icandy7272/ESP32-GPS-Lap-Timer/docs/PRD.md

# Kart GPS Lap Timer — 产品需求文档 (PRD)

**版本**: v0.5
**更新日期**: 2026-04-03
**审阅**: Codex Reviews (v0.2 → v0.5)

## 变更记录

| 版本 | 日期 | 变更内容 |
|---|---|---|
| v0.1 | 2026-04-02 | 初始需求 |
| v0.2 | 2026-04-02 | 新增 Position-Based Delta、无效圈过滤、自动开始/停止、赛后回顾、参考项目 |
| v0.3 | 2026-04-02 | Codex 审阅后修订：放宽 Delta 精度、改进过线检测算法、增加断电保护、精简驾驶 UI、限制扇区数、收窄 v1 范围、移除不安全的校准圈标记 |
| v0.4 | 2026-04-03 | 新增 PPS 校时，修正 Delta 精度目标（±50ms），过线计时精度目标（±20ms） |
| v0.5 | 2026-04-16 | 移除 PPS 相关内容：BK-880 不提供 PPS 输出，也无飞线可用的测试焊盘；时间基准改为 UART 到达时间，Delta 精度放宽到 ±100ms，过线计时 ±60ms |
| v0.5 | 2026-04-03 | Codex 二审：过线精度需求改为 ±30ms（±20ms 为目标值），去抖与精确计时解耦，SD 写入异步化 |

## 1. 项目概述

为卡丁车赛道设计的便携式 GPS 圈速计时器，安装在方向盘上，实时显示与最佳圈的时间差值（Delta），帮助车手在驾驶过程中精确定位每个弯角的快慢，并记录完整轨迹数据供赛后分析。

## 2. 目标用户

- 租赁卡丁车爱好者
- 会去不同赛道
- 需要在驾驶中实时获取圈速反馈
- 需要赛后导出数据用专业软件分析

## 3. 版本规划

### v1.0（MVP）

核心目标：**可靠的圈速计时 + 一个大 Delta 驾驶屏 + SD 卡 VBO 导出**

包含：
- 25Hz GPS 数据记录
- 可靠的过线检测和圈速计时
- Position-Based 实时 Delta 显示（大字体单屏）
- 扇区计时（最多 4 个扇区）
- SD 卡自动记录 VBO 文件
- WiFi 热点 Web 界面（赛道选择、VBO 下载、基础设置）
- 赛道自动识别
- 手动输入经纬度创建赛道
- 无效圈自动过滤
- 断电保护

### v1.1

- 赛后回顾界面（设备端查看圈速列表、理论最佳圈）
- Session 自动开始/停止
- 最佳圈模式切换（本次/历史）
- 历史最佳圈跨 Session 保留

### v2.0

- 地图点选创建赛道
- 赛后轨迹标记扇区
- OTA 固件更新
- 多车手 Profile
- 加速度计（IMU）G 值采集
- 弯心最低速度、滚动圈速等高级功能

## 4. 硬件配置

| 组件 | 型号 | 规格 |
|---|---|---|
| 主控 | 鹿小班 ESP32-S3-N16R8 | 双核 240MHz, 16MB Flash, 8MB PSRAM, WiFi+BLE |
| GPS | 北天 BK-880 | u-blox M9, 25Hz（单星座）/ 10Hz（多星座）, 有源天线, 28x28mm |
| 屏幕 | 中景园 ZJY320S0800TG02 | 3.2" IPS TFT, 320x240, ILI9341, SPI 4线, 3500nit |
| 存储 | MicroSD 卡模块（SPI） + 闪迪 16GB TF 卡 | FAT32 格式 |
| 电源 | 辰克 18650 电池组 | 5V 3A 输出, 4000mAh, Type-C 充电, 支持边充边用 |
| 按键 | 12mm 金属防水按键 x2 | 1 个自锁（总开关）, 1 个自复位（录制键） |
| 安装 | 3D 打印外壳 + 方向盘夹具 | 所有组件装在一个盒子中 |

### 硬件连接

```
ESP32-S3
├── SPI 总线（HSPI）
│   ├── TFT 屏幕 (CS_TFT)
│   └── SD 卡模块 (CS_SD)  ← 与 TFT 共用 MOSI/MISO/CLK，独立 CS
├── UART1
│   └── BK-880 GPS (TX/RX)  ← 115200 baud, UART 环形缓冲 ≥ 1KB
│                              （BK-880 不提供 PPS 输出；计时基准取 UART 到达时间）
├── GPIO
│   ├── 自复位录制键（GPIO4）
│   └── TFT 背光控制 (PWM)
├── 5V/VIN
│   └── 由 5V_SW 主电源母线供电
└── USB
    └── 固件烧录（烧录时外部 5V 断开）
```

### 设备物理结构（一体化盒装，安装在方向盘上）

```
侧面截面：

         天空 ↑ GPS 信号
    ╔══════════════╗  ← 塑料背壳（GPS 信号穿透）
    ║  GPS 天线 ↑  ║  ← BK-880 天线面朝天，贴背壳内侧
    ║──────────────║
    ║  ESP32-S3    ║
    ║  SD 卡模块   ║
    ║──────────────║
    ║  18650 电池  ║  ← 最重部件在底部，降低重心
    ╠══════════════╣
    ║  TFT 屏幕    ║  ← 朝向驾驶员
    ╚══════════════╝
         ↓ 方向盘
```

### 重量与振动注意事项

- 总重量估算：~250g（含电池）。AiM MyChron5 为 390g，Alfano 7 为 435g，本设备更轻
- 外壳建议用 PETG（比 PLA 更耐热耐冲击）
- 所有内部组件用泡棉或硅胶垫固定，防止振动松脱
- Type-C 充电口外露，供充电和固件更新

## 5. 功能需求

### 5.1 核心功能：Position-Based 实时 Delta 计时

**优先级：P0（v1.0）**

- **基于参考圈多段线进度的 Delta 计算**（Polyline Progress Delta）：
  1. 将最佳圈的 GPS 轨迹存储为有序坐标点序列（参考多段线）
  2. 每次 GPS 更新时，将当前坐标投影到参考多段线上，计算沿线进度（0.0 ~ 1.0）
  3. 查找参考圈在相同进度处的时间戳，计算差值
  4. **航向过滤**：当前航向与参考多段线该段的航向差 > 90° 时，不更新 Delta（防止平行赛道段误匹配）
  5. **最大横向距离阈值**：当前坐标到参考多段线的垂直距离 > 30m 时，Delta 显示冻结并标记"OFF TRACK"
- **时间基准（仅 UART）**：BK-880 **不对外输出 PPS 信号**（数据手册 §2.1.3：「1PPS 信号接口：无」），也没有可飞线引出的 PPS 测试焊盘。GPS fix 的时间戳取 UART 到达时间（`esp_timer_get_time()`），抖动约 10-50ms
- Delta 精度目标：**±100ms**（25Hz GPS + 样条插值 + UART 抖动）
- 过线计时精度：**±60ms**（UART 时间戳 + Catmull-Rom 样条插值）
  - 注：25Hz 采样间隔 40ms，样条插值可在采样点之间估算穿越时刻，但 GPS 位置噪声（CEP ~1.5m）和 UART 抖动限制了绝对下限
- Delta 屏幕显示分辨率：**0.01s**（百分之一秒，与 MyChron/Alfano 一致）
- 颜色编码：绿色 = 快于参考圈，红色 = 慢于参考圈
- **首圈无参考圈时**：Delta 显示 "--"，仅记录数据，首个有效圈完成后自动作为参考

### 5.2 过线检测（起终线和扇区线）

**优先级：P0（v1.0）**

每条检测线定义为：两点经纬度 + 合法穿越方向

检测逻辑：
1. **有符号线段交叉检测**：判断连续两个 GPS 点是否穿过检测线
2. **航向窗口**：当前航向必须在检测线法线方向 ±60° 以内（防止反方向穿越误触发）
3. **单次触发（Arming）**：每条检测线穿越一次后进入"已触发"状态，必须远离检测线一定距离（>50m）后重新激活
4. **最小时间间隔**：
   - 最小圈时间：15 秒（防止 GPS 抖动在终点线附近连续触发）
   - 最小扇区时间：5 秒
5. **样条插值精确时间戳**：GPS 采样间隔 40ms（25Hz），在前后两个 GPS 点之间用 Catmull-Rom 样条插值估算穿越时刻；时间基准为 UART 到达时间（BK-880 不提供 PPS）
6. **去抖（与精确计时解耦）**：
   - **精确时间戳路径**：检测到线段交叉后，立即用样条插值回溯计算精确穿越时刻（不等待确认）
   - **去抖验证路径**：连续 2 个 GPS 采样确认穿越方向一致后，才正式确认该穿越事件有效
   - 如果去抖验证失败（GPS 抖动导致的假穿越），丢弃已计算的时间戳
   - 两条路径独立运行：去抖不增加计时延迟，仅决定穿越事件是否被采纳

### 5.3 扇区计时

**优先级：P0（v1.0）**

- 每条赛道最多 **4 个扇区**（即最多 3 条扇区分割线 + 1 条起终线）
- 扇区分割线与起终线使用相同的检测逻辑
- 实时显示已完成扇区的 Delta
- GPS 抖动在短扇区上影响大，故限制最少 2 个扇区

### 5.4 最佳圈定义

**优先级：P0（v1.0 仅支持 Session Best，v1.1 扩展）**

- **v1.0**：本次 Session 最佳圈（每次开机重新计算）
- **v1.1**：增加历史最佳圈（跨 Session 保留，存储在 SD 卡），可通过 Web 界面切换
- 参考圈需存储完整 GPS 轨迹数据（约 50-100KB/圈，25Hz 下 40 秒一圈约 1000 个坐标点）

### 5.5 无效圈自动过滤

**优先级：P0（v1.0）**

圈状态定义：

| 状态 | 说明 | 计入统计？ |
|---|---|---|
| `timed` | 正常计时圈 | ✅ |
| `out` | 出发圈（首次穿越起终线之前） | ❌ |
| `slow` | 圈速 > 当前最佳圈 × 150% | ❌ |
| `short` | 圈时间 < 最小圈时间（15秒） | ❌ |
| `no_ref` | 无参考圈的首圈 | ✅（作为首个参考） |

失效规则：
- 首次穿越起终线前的所有数据为 `out` 状态
- 没有最佳圈时，第一个完整圈自动成为参考，状态为 `no_ref`
- `slow` 和 `short` 圈不更新最佳圈，不影响 Delta 参考基准
- v1.1 增加：Web 界面手动标记/取消

### 5.6 赛道管理

**优先级：P0（v1.0）**

- 预存赛道库，保存在 SD 卡中
- 每条赛道包含：
  - 赛道名称（ASCII only，v1.0 不支持中文文件名）
  - 赛道 ID
  - 起终线坐标（两点经纬度 + 合法穿越方向向量）
  - 扇区分割线坐标（每条也是两点经纬度 + 方向向量，最多 3 条）
  - 赛道中心坐标（用于自动识别）
  - 赛道近似长度（用于辅助识别）

### 5.7 赛道自动识别

**优先级：P0（核心自动识别为 v1.0，多候选交互选择延期到 v1.1）**

识别逻辑：
1. GPS 定位成功后，搜索赛道库中中心坐标距当前位置 < 5km 的赛道
2. 如果匹配到 1 条，直接使用，屏幕显示"已识别：XX"
3. 如果匹配到 0 条，屏幕提示"未知赛道，请用手机配置"
4. 识别结果可通过 Web 界面修改

**v1.0 当前范围：**

- 若 5km 内存在多条候选赛道，设备自动选择最近的一条
- 用户仍可通过手机 Web 界面手动切换赛道

**延期到 v1.1：**

- 如果匹配到多条（同一场馆多个布局），在 Web 界面上手动选择

### 5.8 赛道创建

**优先级：P0（v1.0 仅手动输入，v2.0 扩展）**

**v1.0**：在手机 Web 界面中离线创建赛道。用户先命名赛道，然后在现场依次标记起终线和可选扇区线，界面显示当前 GPS 坐标、鲜度和离线几何预览，不依赖互联网地图。

当前 v1.0 交互约束：

- 赛道创建完全离线，ESP32 热点模式下不加载在线地图瓦片
- 可见坐标默认约每 `2000ms` 刷新一次；进入赛道创建后提升到约 `1000ms`
- GPS 坐标显示鲜度标签：
  - `Live`
  - `1s ago`
  - `2s ago`
  - `Stale - refresh before trusting`
- 按下 `Mark P1/P2` 或扇区打点时，不再使用单次样本，改为固定策略采样：
  - 采样窗口 `2400ms`
  - 采样周期 `400ms`
  - 至少 `3` 个有效样本，否则失败并提示重试
  - 聚合方法为局部米制坐标系中的分量中位数
- 每次采样后显示点位质量，文案使用动作导向提示：
  - `Noisy - try again`
  - `Acceptable - short lines may drift`
  - `Good - ready to save`
- 短起终线会触发更严格门槛：若线长小于 `max(5m, 4 × max(point_spread))`，则要求更高置信度
- 复测（repeatability check）逻辑已预留，但 **v1 默认关闭**，当前不会强制要求用户复测
- Review 面板使用离线 SVG，显示：
  - 真比例几何
  - North / 北向参考
  - 米制比例尺
  - 起终线长度
  - 穿越方向
  - 点位不确定性圈
- v1 不保存未提交的赛道创建草稿；刷新或关闭页面会丢失当前创建过程，所以界面会明确提示不要刷新
- 创建失败时，Web 端应显示具体的保存错误，而不是笼统的 `save failed`

**v1.1**：赛后从已保存的 GPS 轨迹中标记起终线和扇区（在 Web 界面上拖拽轨迹上的点）

**v2.0**：在手机 Web 界面的卫星地图上点选（需解决 ESP32 热点下无互联网的问题，可能需要 Station 模式或预缓存地图瓦片）

### 5.9 数据记录

**优先级：P0（v1.0）**

- GPS 锁定 25Hz 刷新率（v1.0 不提供可选，确保 Delta 精度）
- 自动保存到 SD 卡，无需手动操作
- 文件格式：VBO（Racelogic VBOX 格式）
- 文件命名：`YYYYMMDD_TrackName_HHMMSS_NNN.vbo`（ASCII only）
  - 示例：`20260402_ShanghaiKartCenter_143022_001.vbo`
- 兼容 Circuit Tools、VBOX Tools 等分析软件

### 5.10 断电保护

**优先级：P0（v1.0）**

卡丁车振动大，Type-C 接触不良可能导致瞬断。必须防止数据丢失：

1. **写入策略**：VBO 数据写入临时文件 `_recording.vbo.tmp`，每 30 秒执行一次 `fsync` 刷盘
2. **Session 完成时**：关闭文件，原子重命名为最终文件名
3. **开机恢复**：启动时扫描 SD 卡根目录是否存在 `.tmp` 文件，如果有则：
   - 视为上次异常断电的未完成 Session
   - 重命名为 `YYYYMMDD_UNKNOWN_HHMMSS_recovered.vbo`（从文件内容提取时间戳）
   - 屏幕提示"已恢复上次未完成的 Session"
4. **Session 元数据 JSON**：仅在 Session 正常结束时写入，断电丢失 JSON 可接受（VBO 数据不丢）

### 5.11 VBO 文件格式

**文件编码**：ASCII only
**行结尾**：Windows CR+LF（`\r\n`），包括最后一行
**时间**：UTC

GPS 坐标格式：**角分制**
- 纬度：`十进制度 × 60`，`+` = 北纬，`-` = 南纬
- 经度：`十进制度 × -60`，`+` = 西经，`-` = 东经（注意：东经为负）
- 格式字符串：`%+012.5f`

文件结构：

```
File created on DD/MM/YYYY at HH:MM:SS\r\n
\r\n
[header]\r\n
satellites\r\n
time\r\n
latitude\r\n
longitude\r\n
velocity kmh\r\n
heading\r\n
height\r\n
\r\n
[comments]\r\n
Generated by KartGPS v1.0\r\n
Log Rate (Hz) : 25.00\r\n
\r\n
[session data]\r\n
name TrackName\r\n
\r\n
[laptiming]\r\n
Start  +MMMMM.MMMMM +MMMMM.MMMMM +MMMMM.MMMMM +MMMMM.MMMMM Start / Finish\r\n
Split  +MMMMM.MMMMM +MMMMM.MMMMM +MMMMM.MMMMM +MMMMM.MMMMM Split 1\r\n
\r\n
[column names]\r\n
sats time lat long velocity heading height\r\n
\r\n
[data]\r\n
008 143000.000 +01874.12345 -07258.67890 045.200 128.50 +00032.10\r\n
...
```

数据列格式：

| 列 | 格式 | 示例 | 说明 |
|----|---|---|---|
| sats | `%03d` | `008` | 3 位零填充 |
| time | `HHMMSS.SSS` | `143000.000` | UTC，无冒号，毫秒分辨率 |
| lat | `%+012.5f` | `+01874.12345` | 角分，+ 北 |
| long | `%+012.5f` | `-07258.67890` | 角分，- 东 |
| velocity | `%07.3f` | `045.200` | km/h |
| heading | `%06.2f` | `128.50` | 度 |
| height | `%+09.2f` | `+00032.10` | 米，WGS84 |

**验收标准**：生成的 VBO 文件必须能在 Circuit Tools 中正确导入并显示圈速和轨迹。项目需包含黄金测试文件（golden test files）用于回归验证。

### 5.12 手机交互（WiFi + Web 界面）

**优先级：P0（v1.0 基础版）**

- ESP32 自建 WiFi 热点
- SSID：`KartGPS-XXXX`（XXXX 为设备 MAC 后四位）
- 密码：可配置，默认 `kartgps123`
- 访问地址：`http://192.168.4.1`
- iOS / Android 浏览器通用

**重要约束**：记录模式下 WiFi 功能受限（降低优先级/限制并发请求），避免影响 GPS 数据处理和 SD 卡写入的实时性。WiFi 主要在停车/赛后使用。

v1.0 Web 页面：

```
首页
├── Status（默认）
│   ├── 当前状态（GPS 信号/卫星数、录制状态、当前圈、最佳圈、当前赛道）
│   ├── 录制控制
│   └── Advanced
│       ├── WiFi 密码修改
│       ├── 屏幕亮度
│       └── 固件/重启相关说明
├── Sessions
│   ├── 历史 Session 列表
│   └── VBO 文件下载
└── Tracks
    ├── 当前赛道摘要 / 附近赛道选择
    ├── 赛道列表（选择 / 删除）
    └── 新建赛道（手动输入经纬度 / 标记起终线与扇区）
```

### 5.13 VBO 文件传输

**优先级：P1（v1.0）**

- **方式 A**：拔 SD 卡插电脑读取
- **方式 B**：WiFi 下载（停车状态下，通过 Web 界面浏览和下载 VBO 文件）

## 6. 屏幕 UI 设计

### 6.1 驾驶界面（默认，唯一的赛道中屏幕）

**设计原则**：驾驶中只需余光瞥一眼。一个巨大的 Delta 数字 + 颜色 = 全部信息。

```
┌─────────────────────────────────┐
│                                 │
│                                 │
│         -0.23s                  │  ← 巨大字体，绿色背景（快）或红色背景（慢）
│                                 │
│                                 │
├─────────────────────────────────┤
│  Lap 7         Best: 42.956    │  ← 小字，弱化
└─────────────────────────────────┘
```

状态变体：
- **正常**：绿色/红色背景 + 白色大 Delta 数字
- **无参考圈（首圈）**：黑色背景 + 白色 "--"
- **OFF TRACK（偏离赛道 >30m）**：黄色背景 + "OFF TRACK"
- **GPS 信号丢失**：灰色背景 + "NO GPS"

### 6.2 停车/赛后界面（当前为预留界面）

在停车状态下，这个界面用于显示更多信息。当前硬件没有独立页面按键，
因此该界面先作为后续扩展预留：

```
┌─────────────────────────────────┐
│  SESSION: 14 laps (12 valid)    │
├─────┬────────┬──────────────────┤
│ Lap │  Time  │  vs Best         │
├─────┼────────┼──────────────────┤
│  3  │ 41.956 │  BEST ★          │
│  5  │ 42.088 │  +0.132          │
│  4  │ 42.102 │  +0.146          │
│  2  │ 42.301 │  +0.345          │
│ ... │        │                  │
├─────────────────────────────────┤
│  Best: 41.956                   │
└─────────────────────────────────┘
```

- 当前硬件没有独立页面按键；该界面先保留为后续扩展入口
- 无效圈以灰色显示
- v1.1 增加理论最佳圈显示

### 6.3 状态界面（当前为预留界面）

```
┌─────────────────────────────────┐
│  GPS: 12 sats  Fix: 3D         │
│  Track: ShanghaiKartCenter      │
│  Recording: ● REC               │
│  Battery: Charging / Full       │
│  SD: 14.2 GB free               │
│  WiFi: KartGPS-A3F2             │
│  FW: v1.0.0                     │
└─────────────────────────────────┘
```

注意：电池百分比需要电量计 IC（v1.0 没有），v1.0 仅显示充电中/已满/使用中。

### 6.4 开机流程屏幕

```
[开机画面] → [GPS 搜星中: X sats] → [已识别: XX赛道] → [Ready]
```

### 6.5 按键功能

| 按键 | 类型 | 功能 |
|---|---|---|
| 总开关 | 自锁 | 系统电源开/关 |
| 录制键 | 自复位 | 短按：开始/停止录制 |

## 7. 系统工作流程

```
[开机]
  │
  ▼
[GPS 搜星] ← 屏幕显示卫星数量，等待 3D Fix
  │
  ▼ (3D Fix, 卫星 ≥ 6)
  │
[自动匹配赛道]
  │
  ├── 匹配 1 条 → 屏幕显示"已识别：XX"
  ├── 匹配多条 → 进入 Web 界面手动切换
  └── 匹配 0 条 → 屏幕提示"用手机配置"
  │
  ▼
[Ready - 等待起跑]
  │
  ▼ (首次穿越起终线 → 开始计时)
  │   (同时 SD 卡开始写入 VBO 临时文件)
  │
[计时中]
  │
  ├── 每 40ms (25Hz) → GPS 更新 → 写入 VBO → 计算 Delta
  ├── 穿越扇区线 → 记录扇区时间
  ├── 穿越起终线 → 完成一圈
  │   ├── 判断圈状态 (timed / slow / short)
  │   └── 如果是新最佳 → 更新参考圈
  ├── 每 30 秒 → fsync 刷盘
  │
  ▼ (用户关机)
  │
[正常结束]
  ├── 关闭 VBO 文件
  ├── 原子重命名 .tmp → 最终文件名
  ├── 写入 Session 元数据 JSON
  └── 断电
```

## 8. 任务调度与资源管理

ESP32-S3 双核任务分配：

| 核心 | 任务 | 优先级 | 说明 |
|---|---|---|---|
| Core 0 | GPS UART 接收 + NMEA 解析 | 最高 | UART 环形缓冲 ≥ 1KB，不允许被任何任务阻塞（BK-880 无 PPS，时间戳取 UART 到达时间） |
| Core 0 | 过线检测 + Delta 计算 | 高 | 每次 GPS 更新后立即执行，必须在下一个 GPS fix 到来前完成（<40ms） |
| Core 1 | SD 卡 VBO 写入（异步队列） | 中高 | GPS 数据写入环形队列，Core 1 异步消费写入 SD 卡，每 30s fsync |
| Core 1 | TFT 屏幕渲染 | 中 | 目标 10 FPS，仅刷新变化区域（局部刷新） |
| Core 1 | WiFi Web Server | 低 | 记录模式下限制并发，仅响应基本请求 |
| Core 1 | 按键输入处理 | 低 | 去抖 50ms |

关键约束：
- **GPS 计时路径零阻塞**：Core 0 只做 GPS 接收、解析、过线检测、Delta 计算，不做任何 I/O 阻塞操作
- **SD 写入异步化**：GPS 数据先写入内存环形队列（PSRAM，容量 ≥ 5 秒数据），Core 1 的 SD 写入任务从队列消费。即使 SD 卡写入偶尔延迟（FAT32 簇分配），也不影响 Core 0 的计时精度
- **SPI 总线互斥**：SD 卡写入和 TFT 屏幕渲染共用 SPI 总线，通过 mutex 互斥，SD 写入优先级高于屏幕渲染
- WiFi 在记录模式下为尽力服务（best-effort），不保证响应速度

## 9. 数据存储结构（SD 卡）

```
SD 卡根目录
├── tracks/
│   ├── track_001.json
│   └── ...
├── sessions/
│   ├── 20260402_ShanghaiKartCenter_143022_001.vbo
│   ├── 20260402_ShanghaiKartCenter_143022_001.json  ← 正常结束时写入
│   └── ...
├── best_laps/                    ← v1.1
│   └── track_001_best.json
├── config/
│   └── settings.json
└── _recording.vbo.tmp            ← 记录中的临时文件（正常结束后消失）
```

### 赛道配置文件示例（track_001.json）

```json
{
  "id": "track_001",
  "name": "ShanghaiKartCenter",
  "start_finish": {
    "lat1": 31.2345,
    "lon1": 121.4567,
    "lat2": 31.2346,
    "lon2": 121.4568,
    "heading_deg": 45
  },
  "sectors": [
    {
      "name": "S1",
      "lat1": 31.2340,
      "lon1": 121.4570,
      "lat2": 31.2341,
      "lon2": 121.4571,
      "heading_deg": 120
    }
  ],
  "center_lat": 31.2342,
  "center_lon": 121.4567,
  "approx_length_m": 850
}
```

### Session 元数据示例

```json
{
  "track_id": "track_001",
  "track_name": "ShanghaiKartCenter",
  "date": "2026-04-02",
  "start_time_utc": "06:30:22",
  "end_time_utc": "07:12:45",
  "gps_hz": 25,
  "total_laps": 14,
  "valid_laps": 12,
  "best_lap": {
    "lap_number": 3,
    "time_ms": 41956,
    "sectors_ms": [14201, 15032, 12723]
  },
  "laps": [
    {"lap": 1, "time_ms": 43521, "status": "slow", "sectors_ms": [14800, 15621, 13100]},
    {"lap": 2, "time_ms": 42301, "status": "timed", "sectors_ms": [14300, 15101, 12900]},
    {"lap": 3, "time_ms": 41956, "status": "timed", "sectors_ms": [14201, 15032, 12723]}
  ]
}
```

## 10. 技术约束

- GPS 坐标系：WGS84
- GPS 锁定 25Hz，多星座模式下若不支持则降至 10Hz
- VBO 坐标格式：角分制（十进制度 × 60），东经为负
- VBO 文件编码：ASCII only，CR+LF 行尾
- VBO 时间：UTC
- SPI 总线：屏幕和 SD 卡共用，通过互斥锁（mutex）保证不冲突
- PSRAM 8MB：用于屏幕帧缓冲和参考圈 GPS 轨迹数据
- 内部 SRAM：用于 GPS UART 缓冲、NMEA 解析、实时计算
- 参考圈存储：约 50-100KB/圈（25Hz × 40s × 每点约 20 字节）
- 电池续航：需实测，目标 ≥ 8 小时
- 工作温度：-20°C ~ 70°C

## 11. 验收测试计划

| 测试项 | 方法 | 通过标准 |
|---|---|---|
| VBO 导入 | 在 Circuit Tools 中导入生成的 VBO 文件 | 正确显示轨迹、圈速、扇区 |
| 过线检测精度 | 用已知赛道真实 GPS 数据回放 | 与 MyLaps 官方计时差值 < 30ms（需求），目标 < 20ms |
| Delta 稳定性 | 连续 10 圈相同走线 | Delta 在直道上不出现 >0.1s 的异常跳变 |
| GPS 计时路径延迟 | 在 25Hz 记录模式下测量 Core 0 处理时间 | GPS fix 到达 → 过线检测完成 < 10ms（不被 SD/WiFi 阻塞） |
| 断电恢复 | 记录中拔电，重启 | 恢复的 VBO 文件可正常导入 |
| 赛道识别 | 在赛道库中有 5 条赛道，到达其中一条 | 10 秒内正确识别 |
| SD 卡长时间写入 | 连续记录 2 小时 | 无数据丢失、无文件损坏 |

## 12. 许可证说明

- 参考项目中 DovesLapTimer 为 GPLv3，**仅参考其行为逻辑和算法思路，独立实现代码**，不直接复用其源码
- BonoGPS 为 MIT，可自由复用其 u-blox 配置和 WiFi 栈代码
- 本项目计划采用 MIT 许可证

## 13. 参考项目与资料

### 开源项目

| 项目 | 地址 | 说明 | 可复用价值 |
|---|---|---|---|
| **DovesLapTimer** | https://github.com/TheAngryRaven/DovesLapTimer | Arduino 圈速计时库，样条插值过线检测，Delta，扇区计时，62ms 精度对标 MyLaps | 算法思路参考（GPL v3，不直接复用代码） |
| **DovesDataLogger** | https://github.com/TheAngryRaven/DovesDataLogger | DovesLapTimer 的数据记录伴侣项目 | SD 卡数据记录架构参考 |
| **gotzl/gps-tracker** | https://github.com/gotzl/gps-tracker | ESP32 GPS 圈速计时器，红/绿 Delta 条，WiFi 数据下载 | ESP32 Delta 显示 UI 参考 |
| **BonoGPS** | https://github.com/renatobo/bonogps | ESP32 GPS 桥接器，u-blox 配置，BLE/WiFi，25Hz（104★, MIT） | GPS 初始化、UBX 配置、WiFi 栈（可直接复用） |
| **M5Stack_GPS_LapTimer** | https://github.com/toripoyo/M5Stack_GPS_LapTimer | M5Stack GPS 圈速计时器（MIT） | 简单圈速计时参考 |
| **RaceChronoDiyBleDevice** | https://github.com/timurrrr/RaceChronoDiyBleDevice | ESP32 BLE 设备对接 RaceChrono（123★） | BLE 协议参考 |
| **vbo-tools** | https://github.com/lbulej/vbo-tools | Python CSV→VBO 转换器 | VBO 格式规范和坐标转换 |
| **quentinsf/vboxutils** | https://github.com/quentinsf/vboxutils | Python VBO 读取器 | VBO 格式验证参考 |

### 商业产品参考

| 产品 | 说明 | 参考价值 |
|---|---|---|
| **AiM MyChron5/5S** | 专业卡丁车数据仪，137x88mm，多显示模式，WiFi | 显示 UI、功能优先级 |
| **Alfano 7** | 专业卡丁车计时器，3000mAh/40h，5000+ 赛道库 | 赛道管理、理论最佳圈 |
| **RaceBox Mini/Mini S** | 便携 GPS 计时器，BLE 连手机，2000+ 赛道库 | 赛道自动识别、App 设计 |
| **FoxLAP** | ESP32 DIY GPS 计时器（闭源），1700+ 赛道，Position-Based Delta | 功能设计参考（https://foxlap.com） |

### 技术文档

| 文档 | 说明 |
|---|---|
| Racelogic VBO 格式规范 | https://en.racelogic.support/Knowledge_Base/.VBO_Files |
| VBO 经纬度计算说明 | https://en.racelogic.support/VBOX_Automotive/Knowledge_Base/VBOX_Latitude_and_Longitude_Calculations |
| 中景园 ZJY320S0800TG02 规格书 | 项目本地文件 |
| ILI9341 驱动芯片手册 | 项目本地文件 |
| BK-880 GPS 模块资料 | 北天官方 https://www.beitian.com |
