icandy7272/ESP32-GPS-Lap-Timer/pcb-guide.md

# ESP32-S3 GPS Lap Timer — PCB 打样教程

> 从零开始，手把手教你把面包板原型做成 PCB
>
> 前置文档：[docs/WIRING.md](docs/WIRING.md)（完整接线表和电源架构）

---

## 目录

1. [需要购买的元件](#1-需要购买的元件)
2. [电源与去耦方案](#2-电源与去耦方案)
3. [立创 EDA 零基础教程](#3-立创-eda-零基础教程)
4. [PCB 布局指南](#4-pcb-布局指南)
5. [嘉立创下单](#5-嘉立创下单)
6. [焊接与测试](#6-焊接与测试)
7. [洞洞板替代方案](#7-洞洞板替代方案)

---

## 1. 需要购买的元件

### 你已有的（不用买）

| 元件 | 数量 | 说明 |
|---|---|---|
| ESP32-S3-DevKitC-1 (N16R8) | 1 | 主控开发板 |
| ILI9341 TFT 3.2" 模块 | 1 | 排针接口，8 pin |
| GPS BK-880 模块 | 1 | **线束接口**（非直插排针），1×6 线束 |
| SD 卡 SPI 模块 | 1 | 排针接口，6 pin |
| 自锁按键 12×12mm | 1 | 电源总开关 |
| 自复位按键 12×12mm | 1 | Record 录制键 |
| 470µF 16V 电解电容 (8×12mm) | 4+ | 电源滤波 |
| 104 瓷片电容 0.1µF | 4+ | 高频去耦 |
| USB-C 5V 3A 电池 | 1 | 供电电源 |
| Type-C 母口分线板 | 1 | 从电池取电 |

### 需要购买

| 元件 | 规格 | 数量 | 参考价 | 用途 |
|---|---|---|---|---|
| 排母座 1×22pin | 2.54mm 间距，单排 | 2 | ¥1 | ESP32 DevKit 左右两侧插座 |
| 排母座 1×8pin | 2.54mm 间距，单排 | 1 | ¥0.5 | TFT 模块插座 |
| 排母座 1×6pin | 2.54mm 间距，单排 | 1 | ¥0.5 | SD 卡模块插座 |
| 排针 1×6pin | 2.54mm 间距，单排直插 | 1 | ¥0.3 | GPS 线束焊接点（线束焊到排针上，或直接焊到 PCB 焊盘） |
| 2pin 接线端子 5.08mm | 直插螺钉端子 | 1 | ¥0.5 | Type-C 分线板的 5V/GND 接入 |
| 220Ω 直插电阻 | 1/4W | 1 | ¥0.1 | LED 限流（如用 GPIO2 LED） |
| **PCB 打样** | 嘉立创 5 片 | 1 单 | **¥5-10** | 见第 5 节下单指南 |

> **排母座数量说明：** 以上按各模块引脚数列出最小需求。建议多买几条长排母（如 1×40pin），用手掰成需要的长度，更灵活也更便宜。

---

## 2. 电源与去耦方案

> 完整电源架构见 [docs/WIRING.md § 电源接线](docs/WIRING.md#电源接线)，这里只补充 PCB 上的电容布局。

### 电源通路

```
USB-C 电池 (5V 3A) → Type-C 母口分线板
  → [接线端子 `5V_BAT`] → [自锁按键] → `5V_IN` 总线
      │
      ├── C1: 470µF + C2: 104 ── GND     ← 总线入口滤波
      │
      ├──→ C3: 104 + C4: 470µF ── GPS VCC (5V)
      │
      ├──→ C5: 104 + C6: 470µF ── SD VCC (5V)
      │
      └──→ ESP32 5VIN
            └── 3.3V 引脚
                 └── C7: 104 + C8: 470µF ── TFT VCC (3.3V)
```

**共 4 对电容：4 个 470µF + 4 个 104。**

### 为什么用 470µF 替代文档推荐的 10-220µF？

`WIRING.md` 建议 GPS 旁 10µF、SD 旁 100-220µF、TFT 旁 10µF。你手头有大量 470µF，直接用完全没问题：

- 电解电容大了**不会有害**，只是占更多板面积
- 8×12mm 的 470µF 在载板上放得下
- 更大的容量对突发电流的缓冲更好

### 电容摆放原则

- **104 瓷片**紧贴模块的 VCC/GND 引脚（越近越好，滤高频噪声）
- **470µF 电解**可以稍远一些（1-2cm 内），滤低频纹波和突发电流
- 电解电容**注意正负极**：长脚为正（接 VCC），短脚/标记条为负（接 GND）

---

## 3. 立创 EDA 零基础教程

### 3.1 注册与进入

1. 打开 https://lceda.cn
2. 注册嘉立创账号（或用微信扫码登录）
3. 点击「立创 EDA 标准版」→「在线使用」
4. 进入编辑器后，左上角「文件」→「新建项目」
5. 项目名：`ESP32_GPS_LapTimer_PCB`

### 3.2 原理图绘制

原理图的目的是告诉软件"哪个引脚连哪个引脚"，**不需要画得跟实物一样**。

#### 步骤 1：放置元件符号

在右侧「元件库」搜索并放置：

| 搜索关键词 | 选择 | 数量 | 代表 |
|---|---|---|---|
| `排针 1×22` 或 `Header 1x22` | 2.54mm 单排直插 | 2 | ESP32 DevKit 左右两排 |
| `排针 1×8` 或 `Header 1x8` | 2.54mm 单排 | 1 | TFT 模块 |
| `排针 1×6` 或 `Header 1x6` | 2.54mm 单排 | 1 | SD 卡模块 |
| `排针 1×6` 或 `Header 1x6` | 2.54mm 单排 | 1 | GPS 线束焊接点 |
| `SW_Push` 或 `按键开关` | 直插按键 12×12 | 2 | 自锁开关 + Record |
| `接线端子 2P` | 5.08mm 2pin | 1 | 电源输入 |
| `电容 470uF` 或 `Cap_Polar` | 直插电解 8×12 | 4 | 滤波电容 |
| `电容 100nF` 或 `C` | 直插瓷片 | 4 | 去耦电容 |
| `电阻 220` 或 `R` | 直插 1/4W | 1 | LED 限流 |
| `LED` | 3mm 直插 | 1 | 状态 LED（可选） |

> **技巧：** 搜不到精确型号没关系。原理图符号只是逻辑连接，真正决定焊盘的是封装（Footprint）。先用通用符号，后面再指定封装。

#### 步骤 2：给元件标注引脚名

双击排母符号，把引脚名改成有意义的名字。参考 [docs/WIRING.md § 接线总览表](docs/WIRING.md#接线总览表)：

**ESP32 DevKit（左右各 1×22）：** 你不需要标全部 44 个引脚，只标用到的：

| 引脚编号 | 标注 | 说明 |
|---|---|---|
| 按 DevKit 实际排列 | 5VIN | 接 `5V_IN` |
| | GND | 接地 |
| | 3V3 | 输出给 TFT |
| | GPIO4 | Record 按钮 |
| | GPIO8 | TFT RST |
| | GPIO9 | TFT DC |
| | GPIO10 | TFT CS |
| | GPIO11 | SPI MOSI |
| | GPIO12 | SPI SCLK |
| | GPIO13 | SPI MISO |
| | GPIO17 | GPS RX |
| | GPIO18 | GPS TX |
| | GPIO42 | SD CS |
| | GPIO47 | TFT BLK |
| | GPIO2 | LED |

**TFT (1×8)：** GND, VCC, CLK, MOS, RES, DC, CS, BLK

**SD (1×6)：** GND, VCC, MISO, MOSI, SCK, CS

**GPS (1×6 焊盘/排针)：** SDA, GND, TX, RX, VCC, SCL — 模块板上的 2.54mm 通孔路径，焊 1×6 排针到模块，PCB/洞洞板上装对应排母座即可。BK-880 不提供 PPS，不需要预留任何 PPS 焊点。

#### 步骤 3：用网络标签连线

**不要直接拉线连来连去——会变成一团乱麻。** 用「网络标签」（Net Label）：

1. 在工具栏找到「网络标签」（或按快捷键 `N`）
2. 放一个标签叫 `MOSI`，贴在 ESP32 的 GPIO11 引脚上
3. 再放一个同名的 `MOSI` 标签，贴在 TFT 的 MOS 引脚上
4. 再放一个同名的 `MOSI` 标签，贴在 SD 的 MOSI 引脚上
5. **同名标签 = 物理连线**，软件会自动认为它们相连

按这个方法把所有连接做完：

| 网络标签 | 连接的引脚 |
|---|---|
| `5V_BAT` | 接线端子 pin1 → 自锁按键 pin1（按键前，电池原始 5V） |
| `5V_IN` | 自锁按键 pin2 → C1+ → C4+ → C6+ → ESP32 5VIN → GPS VCC → SD VCC（按键后，系统 5V 总线） |
| `3V3` | ESP32 3V3 → C8+ → TFT VCC |
| `GND` | 所有 GND 引脚、所有电容负极、接线端子 pin2 |
| `MOSI` | ESP32 GPIO11 → TFT MOS → SD MOSI |
| `SCLK` | ESP32 GPIO12 → TFT CLK → SD SCK |
| `MISO` | ESP32 GPIO13 → SD MISO |
| `TFT_CS` | ESP32 GPIO10 → TFT CS |
| `TFT_DC` | ESP32 GPIO9 → TFT DC |
| `TFT_RST` | ESP32 GPIO8 → TFT RES |
| `TFT_BL` | ESP32 GPIO47 → TFT BLK |
| `SD_CS` | ESP32 GPIO42 → SD CS |
| `GPS_RX` | ESP32 GPIO17 (U1RXD) ↔ GPS pin3 (TX) — 从 ESP32 视角命名：ESP32 的 RX 线 |
| `GPS_TX` | ESP32 GPIO18 (U1TXD) ↔ GPS pin4 (RX) — 从 ESP32 视角命名：ESP32 的 TX 线 |
| `BTN_REC` | ESP32 GPIO4 → Record 按钮 pin1 |
| `LED_OUT` | ESP32 GPIO2 → 220Ω 电阻 → LED 正极 |

> Record 按钮的另一端接 `GND`。LED 负极也接 `GND`。

#### 步骤 4：添加电源符号

1. 搜索元件库中的 `VCC` 和 `GND` 电源符号
2. 把 `VCC` 放在 `5V_IN` 网络上，`GND` 放在地线上
3. 这一步主要是让原理图更易读，不影响实际连接

#### 步骤 5：ERC 检查

1. 菜单「设计」→「电气规则检查（ERC）」
2. 点击「运行检查」
3. 常见警告：
   - "未连接的引脚" — 检查是不是忘了接线
   - "电源引脚未连接电源网络" — 加 VCC/GND 符号
4. 所有错误清零后，原理图完成

### 3.3 指定封装

每个元件需要指定 PCB 上的实际焊盘形状：

| 元件 | 封装搜索关键词 |
|---|---|
| ESP32 排母 1×22 ×2 | `PIN-HEADER_1X22_2.54` |
| TFT 排母 1×8 | `PIN-HEADER_1X8_2.54` |
| SD 排母 1×6 | `PIN-HEADER_1X6_2.54` |
| GPS 排母 1×6 | `PIN-HEADER_1X6_2.54` |
| 按键 12×12 | `SW_12x12` 或 `KEY-TH_4P-L12.0-W12.0` |
| 470µF 电解 8×12 | `CAP-D8.0×H12.0` 或搜 `电解 8x12` |
| 104 瓷片 | `C_DISC_D5.0` 或 `C0805`（看你的是直插还是贴片） |
| 220Ω 电阻 | `R_AXIAL_L6.3` 或类似直插封装 |
| LED 3mm | `LED_D3.0` |
| 接线端子 2P | `CONN-TH_2P-P5.08` |

双击每个元件 → 「封装」栏 → 搜索对应封装 → 选择 → 确认。

### 3.4 PCB 设计

#### 步骤 1：转换到 PCB

菜单「设计」→「原理图转 PCB」（或点顶部的 PCB 图标）。

所有元件会堆在一起出现在 PCB 编辑器中。接下来要做三件事：摆元件、画板框、布线。

#### 步骤 2：画板框

1. 切换到「板框层」（Board Outline）
2. 用矩形工具画板框
3. 推荐尺寸：**100mm × 80mm**（可以放下所有元件，后面调整）

> DevKit 本体约 70×26mm，TFT 模块约 50×34mm。预留足够空间。

#### 步骤 3：摆放元件

把元件从堆叠状态拖到板框内。摆放原则见下一节。

#### 步骤 4：布线

1. 点击「布线」工具（或快捷键 `W`）
2. 从一个焊盘开始，拉线到另一个焊盘
3. 软件会用飞线（细白线）提示哪些焊盘需要连接
4. 走完所有飞线 = 布线完成

走线宽度设置：
- 「设计规则」→ 添加规则：
  - `5V_IN` 网络：线宽 **1mm**
  - `3V3` 网络：线宽 **0.5mm**
  - `GND` 网络：线宽 **1mm**（或用铺铜代替）
  - 其余信号线：线宽 **0.25mm**

#### 步骤 5：铺铜（地平面）

1. 选择「铺铜」工具
2. 在**底层**（Bottom Layer）画一个覆盖整个板框的矩形
3. 网络选择 `GND`
4. 点击「重建铺铜」
5. 底层会被 GND 铜皮填满，所有 GND 焊盘自动通过过孔连接

> 这是 PCB 设计中最重要的一步——地铜平面能大幅减少电源噪声和信号串扰，是面包板无法实现的。

#### 步骤 6：DRC 检查

1. 菜单「设计」→「设计规则检查（DRC）」
2. 运行检查
3. 修复所有错误（间距不够、未连接、短路等）

---

## 4. PCB 布局指南

### 推荐布局（俯视图）

```
┌──────────────────────────────────────────────────────────┐
│                                                          │
│  [接线端子]  [自锁按键]     470µF(总线)                    │
│   5V/GND      ON/OFF        C1 + C2(104)                 │
│                                                          │
│  ┌────────────────────────────────────┐                   │
│  │                                    │    [GPS 焊盘]     │
│  │   ESP32-S3 DevKit (1×22 + 1×22)    │    C3+C4(470µF)  │
│  │                                    │  ← 线束从此引出   │
│  │     USB-C 口朝板边                  │                   │
│  │     （方便烧录时接线）               │                   │
│  │                                    │                   │
│  └────────────────────────────────────┘                   │
│                                                          │
│  [SD 排母]    [Record 按钮]     [TFT 排母 1×8]           │
│  C5+C6         GPIO4            C7+C8                    │
│  ← 靠近 ESP32                    ← 可伸出板边插屏幕       │
│    (SPI 走线短)                                           │
│                                                          │
│  [LED] ── [220Ω] ── GPIO2                                │
│                                                          │
└──────────────────────────────────────────────────────────┘
```

### 排母座丝印防呆（重要！）

模块排针的丝印顺序和 PCB 排母的 pin1 方向可能相反，**插反会导致 5V 灌入 GPIO，烧毁 ESP32 或模块。**

**必须在 PCB 丝印上印出每个排母座各引脚的信号名：**

```
SD 卡排母：
  CS  SCK  MOSI  MISO  VCC  GND
   ○    ○    ○     ○    ○    ○

TFT 排母：
  GND  VCC  SCL  SDA  RES  DC  CS  BLK
   ○    ○    ○    ○    ○   ○   ○    ○

GPS 焊盘：
  SDA  GND  TX  RX  VCC  SCL
   ○    ○   ○   ○    ○    ○
```

安装时，将模块丝印上的信号名与 PCB 丝印一一对齐即可，不依赖 pin 编号。

### 元件摆放原则

| 原则 | 原因 |
|---|---|
| **ESP32 居中** | 信号线向四周辐射，平均走线最短 |
| **SD 卡靠近 ESP32** | SPI 总线走线越短越好（10-25MHz 时钟） |
| **GPS 天线朝板边外侧** | 远离 SPI 时钟线和 ESP32 的射频干扰 |
| **TFT 在一侧** | 方便用排线延伸到外壳面板 |
| **自锁按键在板边** | 方便从外壳露出操作 |
| **接线端子在板边** | 方便外部电源线接入 |
| **电容紧贴模块 VCC/GND** | 去耦效果与距离成反比，越近越好 |

### 走线规则

| 网络 | 线宽 | 说明 |
|---|---|---|
| `5V_IN`, `GND` | ≥ 1.0mm | 电源主干，电流大 |
| `3V3` | ≥ 0.5mm | 3.3V 供 TFT，电流 ~30mA |
| SPI (`MOSI`, `SCLK`, `MISO`) | 0.25mm | 尽量短、平行、等长 |
| CS/DC/RST/BL | 0.25mm | 低速控制信号，不敏感 |
| UART (`GPS_TX`, `GPS_RX`) | 0.25mm | 低速 115200，可以走长线 |
| `BTN_REC` | 0.25mm | 低速 GPIO 输入 |

### SPI 走线注意事项

```
GOOD:  MOSI ═══════╗
       SCLK ═══════╬══→ TFT/SD （平行、短、紧挨）
       MISO ═══════╝
       GND  ═══════    （旁边跑一根地线）

BAD:   MOSI ═══════════════╗
       SCLK ═╗              ╠══→ TFT/SD （长度不一、绕路）
       MISO ═╩═════════════╝
```

- SPI 三根线（MOSI/SCLK/MISO）从 ESP32 出发，先到 SD 卡模块再到 TFT（或反之），走菊花链
- 或者从 ESP32 分叉，分别短线到两个模块
- 旁边伴一根 GND 走线或依赖底层地铜平面

---

## 5. 嘉立创下单

### 5.1 导出 Gerber 文件

立创 EDA 最方便的一点——**可以跳过 Gerber 导出，直接下单：**

1. PCB 编辑器内，点击顶部工具栏的「嘉立创下单」按钮
2. 自动检查设计 → 生成制造文件 → 跳转到嘉立创下单页面
3. 如果要手动导出：菜单「制造」→「Gerber 导出」

### 5.2 下单参数

| 参数 | 选择 | 说明 |
|---|---|---|
| 层数 | **2** | 双面板（顶层走信号，底层铺地铜） |
| 尺寸 | 自动识别 | 从 Gerber 读取 |
| 板厚 | **1.6mm** | 标准厚度，最便宜 |
| 阻焊颜色 | **绿色** | 最便宜，交期最快 |
| 铜厚 | **1 oz** | 标准，够用 |
| 表面处理 | **HASL（有铅喷锡）** | 最便宜，手工焊接最方便 |
| 数量 | **5 片** | 最小起订量 |
| 确认生产稿 | **否** | 省时间 |

### 5.3 费用与交期

| 项目 | 参考价格 |
|---|---|
| PCB 5 片 | ¥2-5 |
| 运费 | ¥5-12（看快递方式） |
| **合计** | **约 ¥10-15** |
| 交期 | 下单后 2-5 个工作日发货 |

> 嘉立创经常有新用户免费打样活动，注册后看看有没有优惠券。

---

## 6. 焊接与测试

### 6.1 焊接顺序

从低到高、从小到大焊接：

| 顺序 | 元件 | 注意事项 |
|---|---|---|
| 1 | 104 瓷片电容 ×4 | 无极性，随便插 |
| 2 | 220Ω 电阻 | 无极性 |
| 3 | 470µF 电解电容 ×4 | **有极性！** 长脚=正=VCC，短脚/白条=负=GND |
| 4 | 排母座（ESP32, TFT, GPS, SD） | 先焊一个引脚定位，确认垂直后再焊其余 |
| 5 | 按键 ×2 | 12×12mm 四脚，对角两脚相连 |
| 6 | 接线端子 | 开口朝板边（方便接线） |
| 7 | LED + 电阻 | LED 长脚=正极=接电阻侧 |

### 6.2 焊后检查（上电前必做！）

用万用表逐项检查：

| 检查项 | 操作 | 期望结果 |
|---|---|---|
| **5V/GND 无短路** | 欧姆挡量接线端子 5V 和 GND | 不导通（显示 OL） |
| **3V3/GND 无短路** | 量 TFT 排母的 VCC 和 GND | 不导通 |
| **自锁按键通断** | 蜂鸣挡量按键两端，按下/释放 | 按下响，释放不响 |
| **电源通路** | 自锁按键按下，量各模块 VCC 到接线端子 5V+ | 导通（蜂鸣） |
| **电容极性** | 目视检查 470µF 的正负极标记 | 正极接 VCC 侧 |

### 6.3 首次上电

1. **不插任何模块**，只接电源线到接线端子
2. 按下自锁按键
3. 用万用表量各排母座的 VCC-GND 电压：
   - GPS/SD 排母：应为 **~5V**
   - TFT 排母：此时无电压（ESP32 还没插，3.3V 没输出）
4. 确认无异味、无发热

### 6.4 插入模块测试

1. 断电（释放自锁按键）
2. 插入 ESP32 DevKit
3. 上电，量 TFT 排母 VCC-GND：应为 **~3.3V**
4. 逐个插入其他模块，每插一个观察是否正常

### 6.5 刷固件并修改参数

PCB 走线比面包板可靠得多，可以恢复全速参数：

**文件 1：`src/storage/storage_internal.h` 第 18 行**
```cpp
// 修改前（面包板保守值）：
static constexpr uint32_t SD_SPI_MHZ = 4;

// 修改后（PCB 全速值）：
static constexpr uint32_t SD_SPI_MHZ = 25;
```

**文件 2：`platformio.ini` 第 16 行**
```ini
; 修改前（面包板降频防 BROWNOUT）：
board_build.f_cpu = 160000000L

; 修改后（PCB 全速）：
board_build.f_cpu = 240000000L
```

### 6.6 验证步骤

1. 编译并上传固件
2. 查看串口输出，确认无 `BROWNOUT` 错误
3. 检查 SD 卡 `boot_log.txt`，确认启动正常
4. 测试录制功能（按 Record 按钮）
5. 测试 GPS 定位（户外等待 30-60 秒冷启动）
6. 如果 SD 卡在 25MHz 下不稳定，降回 10MHz 再试

### 6.7 烧录模式注意

> 参见 [docs/WIRING.md § 烧录与双供电注意事项](docs/WIRING.md#6-烧录与双供电注意事项)

1. 释放自锁按键（断外部 5V）
2. USB 线连电脑和 ESP32 DevKit
3. 烧录固件
4. 拔掉 USB
5. 按下自锁按键恢复电池供电

**不要同时接电池和电脑 USB** — 双路 5V 可能互相回灌。

---

## 7. 洞洞板替代方案

如果 PCB 打样太麻烦，可以用洞洞板焊接，原理图作为接线参考即可。

### 7.1 材料清单

| 材料 | 规格 | 用途 |
|---|---|---|
| 洞洞板 | **双面镀锡**，2.54mm 间距，~10×8cm | 焊接基板 |
| 排母座 | 1×6 ×2, 1×8 ×1, 1×22 ×2 | 模块插座（含 GPS） |
| 排针 | 1×6 | 焊到 GPS 模块底部焊盘 |
| 接线端子 | 2P 5.08mm | 电源输入 |
| 漆包线 | **0.3mm** | 信号跳线（SPI/UART/GPIO） |
| 镀锡铜线 | **0.5mm** 或更粗 | 电源线（5V/GND，承载 500mA） |
| 杜邦线（可选剥皮用） | 普通现成杜邦线 | 可替代漆包线/镀锡线 |
| 焊锡丝 | 0.6mm 含松香 | 焊接 |

### 模块连接方式总结

| 模块 | 连接方式 |
|---|---|
| ESP32 DevKit | 两条 1×22 排母座（插拔） |
| TFT 屏 | 1×8 排母座（插拔） |
| SD 卡模块 | 1×6 排母座（插拔） |
| GPS BK-880 | **先焊 1×6 排针到模块底部焊盘**，再用 1×6 排母座插拔 |
| 自锁按键（电源） | 按钮的线焊到洞洞板焊盘（按钮装外壳上） |
| 自复位按键（Record） | 按钮的线焊到洞洞板焊盘（按钮装外壳上） |
| 接线端子 | 直接焊到洞洞板 |
| 电容 | 直接焊到洞洞板 |

> **不要用 0.1mm 漆包线做电源线** — 太细，500mA 会发热，长期不可靠。
> **0.1-0.2mm 仅信号线短跳可用**，但容易折断。
> 推荐：信号 0.3mm 漆包线，电源 0.5mm+ 镀锡线。

### 7.2 双面镀锡洞洞板的优势

- 每个孔上下两面都有铜环，强度更好
- 相邻焊盘可以**用焊锡桥接**，省跳线
- 比单面板贵一点但好焊

### 7.3 布局原则

和 PCB 一样（参考第 4 节）：
- ESP32 居中，USB 朝板边
- SD 靠近 ESP32
- GPS 在板边，远离 SPI
- 电容紧贴模块 VCC

### 7.4 焊接顺序

1. **排母座**（先焊对角两针定位，确认垂直再焊其余）
2. **按钮接线焊盘**（直接用 1×2 排针孔位，不焊排针，留着穿线）
3. **接线端子**（开口朝板边）
4. **104 瓷片电容**（无极性）
5. **470µF 电解电容**（**注意极性**：长脚=正、短脚/白条=负）
6. **背面跳线**（按原理图的网络连接）

### 7.5 跳线技巧

**电源/GND 总线（推荐方案）：**
- 用 0.5mm 镀锡铜线沿一行/一列拉直，作为 5V 总线
- GND 另起一行
- 各模块的 VCC/GND 焊到对应总线上
- 这样比每个模块单独拉线干净得多

```
背面示意（俯视）：
  ESP32 GND ──┬─────────────── GND 总线 ────┬── GPS GND
              │                              │
              SD GND                         TFT GND

  ESP32 5V ──┬─────────────── 5V 总线 ────┬── GPS VCC
             │                             │
             SD VCC                        (TFT VCC 走 3V3)
```

**SPI 信号（MOSI/SCLK/MISO）：**
- 用 0.3mm 漆包线，三根捋直走在一起
- 旁边伴一根 GND 跳线（抗干扰）
- 长度尽量短

**漆包线焊接：**
- 漆包线表面有绝缘漆，焊前需要去漆
- 方法：电烙铁高温（350°C）+ 焊锡，烫几秒漆就化了
- 或者用刀刮、砂纸磨

### 7.6 防呆

模块插上去之前，**用记号笔在板上写信号名**：

```
SD 排母旁：  CS  SCK  MOSI  MISO  VCC  GND
TFT 排母旁： GND VCC SCL SDA RES DC CS BLK
GPS 焊盘旁：SDA GND TX RX VCC SCL
```

模块上的丝印对着洞洞板上的标注插，杜绝插反烧板。

### 7.7 上电前检查

万用表蜂鸣挡：
- 5V 总线 ↔ GND：**不应导通**（否则短路）
- 各模块 VCC ↔ 5V 总线（或 3.3V）：**应导通**
- 各模块 GND ↔ GND 总线：**应导通**
- 自锁按键按下：5V_BAT ↔ 5V_IN **应导通**

### 7.8 固件参数

洞洞板的信号完整性比 PCB 差一些，但比面包板好。建议：
- `SD_SPI_MHZ` 先试 **10**（不要直接上 25）
- `f_cpu` 可以上 **240MHz**

如果稳定，再把 SD 速度加到 25MHz。

---

## 附录：常见问题

### Q: 上电后没反应？
- 检查自锁按键是否按下锁住
- 量接线端子有没有 5V
- 检查 470µF 电容正负极是否反了

### Q: SD 卡读写报错？
- 先把 `SD_SPI_MHZ` 降回 4 或 10，排除速度问题
- 检查 MOSI/SCLK/MISO/CS 四根线的焊点

### Q: TFT 不亮？
- 量 TFT VCC-GND 是否有 3.3V
- 检查 GPIO47 (BLK) 连线
- RST (GPIO8) 虚焊会导致屏幕不初始化

### Q: GPS 无输出？
- TX/RX 是否交叉连接（GPS TX → ESP32 GPIO17）
- GPS 模块 VCC 是否有 5V
- 首次定位需要 30-60 秒，室内可能更久

### Q: 编译上传后 BROWNOUT？
- 把 `f_cpu` 改回 `160000000L` 试试
- 检查 470µF 电容是否在位
- 检查自锁按键接触是否良好（量按键两端电压降，应 < 250mV）

---

## 附录：补充意见（焊接前）

这些不是必须照做的硬性要求，但按现在这条 worktree 里的文档和代码状态来看，下面几条会明显降低首版洞洞板翻车概率。

### 1. BK-880 完全不提供 PPS，无需预留相关焊点

- 数据手册 §2.1.3 明确标注「1PPS 信号接口：无」
- 模块板上没有可用于飞线的 PPS 测试焊盘（`PPS` LED 只是内部秒脉冲的可视指示）
- GPIO16 代码里保留 `PIN_GPS_PPS` 定义以便兼容，但 **ISR 永不触发**
- 洞洞板上 GPIO16 不需要布线、不需要预留焊孔，按未用处理即可

### 2. 已确认的插座规格

- 当前实物规格已经确认：
- `ESP32-S3-DevKitC-1` 使用 **两排独立 `1×22`**
- `GPS BK-880` 使用 **`1×6` 线束/焊盘**
- 因此采购和切排母时，按上面两个规格执行即可
- `ESP32` 不要按标准双排 `2×22` 排母去理解，它更接近“两条分开的单排插座”
- 真正开焊前，仍建议先把 `ESP32`、`TFT`、`SD`、`GPS` 四个模块摆到桌上，逐个数针脚、量排距、确认丝印方向，再开始切插座

### 3. 洞洞板首版建议按“先稳再快”调试

- 虽然文档里给了洞洞板 `240MHz + SD_SPI_MHZ=10` 的建议，但第一次点亮时我还是更建议从当前固件保守值开始
- 也就是先用 `f_cpu = 160MHz`
- `SD_SPI_MHZ` 先维持 `4` 或最多升到 `10`
- 等你确认下面这些都稳定后，再逐步提速：
- 连续冷启动不 brownout
- TFT 每次都能正常复位点亮
- SD 卡反复挂载/写入不报错
- GPS 长时间供电不掉线
- 这样排障会简单很多，因为你能先把“焊接错误”和“时序/速度问题”分开

### 4. 机械强度在洞洞板版本里和电气同样重要

- `GPS` 线束、电源输入线、自锁按键引线，都是最容易被震动拉坏的地方
- 这些线不要只靠焊点承力，建议在线束进入板子的地方做一次应力释放
- 可选做法：热熔胶、UV 胶、小扎带穿孔固定、或者在线束上打结后再进外壳
- `USB` 口、`SD` 卡口、总开关位置，也尽量在外壳阶段就想好，避免后面因为“插不进去”返工焊线

### 5. 建议预留最少量测试点

- 哪怕是洞洞板，也建议至少留出几个万用表/示波器好碰到的位置
- 推荐预留：
- `5V_IN`
- `3V3`
- `GND`
- `GPIO17 / GPIO18`（GPS 串口）
- `GPIO42`（SD CS，排查 SPI 时很有用）
- 这些测试点不需要很正式，一排空焊孔或短排针都可以

### 6. 首次上电顺序建议再保守一点

- 第一次不是“全插满再上电”，而是按层级推进
- 先只上电源总线，确认 `5V_IN` 正常
- 再插 `ESP32`，确认板上 `3.3V` 正常
- 再插 `TFT`
- 再插 `SD`
- 最后插 `GPS`
- 每加一个模块，都量一次该模块 `VCC-GND` 电压，并观察电流、发热和串口日志
- 这样一旦出问题，你几乎能立刻定位是哪个模块或哪段线引入的

### 7. 这版文档已经够开工，但仍建议边焊边修正文档

- 现在这份 `pcb-guide.md` 已经足够支持你开始做洞洞板版本
- 但它还带着少量从 `PCB 打样` 视角遗留下来的描述，和少量规格不一致的地方
- 比如 `ESP32` 插座针数、`GPS` 线束针数、以及“PCB 推荐参数”和“洞洞板推荐参数”的切换时机
- 所以更实际的策略不是等文档绝对完美，而是你每焊完一个关键节点，就把实测结论反写回文档
- 这样第二版无论继续洞洞板还是转正式 PCB，都会顺得多
