icandy7272/ESP32-GPS-Lap-Timer/docs/WIRING.md

# ESP32-S3 GPS 轨迹记录仪 — 接线指南

> 适用硬件：ESP32-S3 N16R8 DevKit（乐鑫官方开发板，两排独立 1×22 排针）
> 更新日期：2026-04-09

---

## 目录

1. [接线总览表](#接线总览表)
2. [TFT 屏接线](#tft-屏接线)
3. [SD 卡模块接线](#sd-卡模块接线)
4. [GPS 模块接线](#gps-模块接线)
5. [按钮接线](#按钮接线)
6. [电源接线](#电源接线)
7. [ASCII 连接示意图](#ascii-连接示意图)
8. [注意事项](#注意事项)
9. [组装与振动加固（点热熔胶）](#组装与振动加固点热熔胶)

---

## 接线总览表

| 模块 | 模块引脚 | ESP32-S3 GPIO | 说明 |
|---|---|---|---|
| **TFT (ILI9341)** | GND | GND | 接地 |
| TFT | VCC | 3.3V | 注意：ILI9341 供电为 3.3V，不可接 5V |
| TFT | CLK (SCLK) | GPIO12 | SPI 时钟，与 SD 共享 |
| TFT | MOS (MOSI) | GPIO11 | SPI 数据输出，与 SD 共享 |
| TFT | RES (RST) | GPIO8 | 屏幕复位 |
| TFT | DC | GPIO9 | 数据/命令选择 |
| TFT | CS | GPIO10 | SPI 片选（TFT 专用） |
| TFT | BLK | GPIO47 | 背光控制（PWM 调亮度） |
| **SD 卡模块** | GND | GND | 接地 |
| SD 卡 | VCC | **5V_SW** | 当前项目这块蓝色 SPI SD 模块带 `1117-3.3` 稳压，建议接 **5V_SW** |
| SD 卡 | MISO | GPIO13 | SPI 数据输入（SD 专用，TFT 无 MISO） |
| SD 卡 | MOSI | GPIO11 | SPI 数据输出，与 TFT 共享 |
| SD 卡 | SCK | GPIO12 | SPI 时钟，与 TFT 共享 |
| SD 卡 | CS | GPIO42 | SPI 片选（SD 专用） |
| **GPS BK-880** | SDA (pin1) | 未接（预留） | I2C 数据，QMC5883 罗盘 |
| GPS BK-880 | GND (pin2) | GND | 接地；必须与 ESP32 共地 |
| GPS BK-880 | TX (pin3) | GPIO17 | GPS 发送 → ESP32 接收（UART1 RX） |
| GPS BK-880 | RX (pin4) | GPIO18 | GPS 接收 ← ESP32 发送（UART1 TX） |
| GPS BK-880 | VCC (pin5) | **5V_SW** | 主电源 DC 3.6-5.5V，推荐 5V |
| GPS BK-880 | SCL (pin6) | 未接（预留） | I2C 时钟，QMC5883 罗盘 |
| **按钮 1（锁定）** | 串联在 5V 正极 | 不接 GPIO | 作为系统总开关，控制 `5V_SW` 母线 |
| **按钮 2（录制）** | 一端 | GPIO4 | 自复位物理录制键，另一端接 GND |
| **GPIO5 扩展位** | 预留 | GPIO5 | 当前硬件未装配；可留给未来页面/扇区键 |
| **LED 状态指示** | 正极 | GPIO2 | 负极接 GND，串接 220Ω 限流电阻 |
| **电源** | 5V 电池 USB-C | 取电板 → 自锁开关 → `5V_SW` | `5V_SW` 再分到 ESP32 `5V/VIN`、GPS、SD |

---

## TFT 屏接线

**模块型号：** ZJY320S0800TG02，3.2 寸，驱动 IC：ILI9341，8 根连线

| # | 模块引脚标注 | 连接位置 | 说明 |
|---|---|---|---|
| 1 | GND | ESP32-S3 GND | 接地 |
| 2 | VCC | ESP32-S3 3.3V | **必须接 3.3V**，ILI9341 不支持 5V 逻辑/供电 |
| 3 | CLK | GPIO12 | SPI 时钟线 |
| 4 | MOS | GPIO11 | SPI MOSI（主机发送，屏幕接收） |
| 5 | RES | GPIO8 | 复位引脚，低电平复位 |
| 6 | DC | GPIO9 | 数据/命令选择：高电平=数据，低电平=命令 |
| 7 | CS | GPIO10 | 片选，低电平有效 |
| 8 | BLK | GPIO47 | 背光使能。接 GPIO 可用 PWM 控制亮度；若不需调光也可直接接 3.3V 常亮 |

**要点：**
- ILI9341 逻辑电平为 3.3V，若 VCC 误接 5V 会损坏芯片
- BLK 接 GPIO47 后，代码中用 `ledcWrite()` 即可实现亮度调节
- TFT 仅作为输出设备，无需 MISO 线

---

## SD 卡模块接线

**接口：** SPI，6 根连线

> 当前项目实物使用的是蓝色 SPI MicroSD 模块，板上可见 `1117-3.3`
> 稳压器和 `SN74HC125` 缓冲/电平处理芯片。对这块模块，`VCC`
> 建议接 **5V_SW**，不要从 ESP32 的 `3.3V` 脚给它供电。

| # | 模块引脚标注 | 连接位置 | 说明 |
|---|---|---|---|
| 1 | GND | ESP32-S3 GND | 接地 |
| 2 | VCC | **5V_SW** | 当前这块带 `1117-3.3` 的模块建议接 **5V_SW** |
| 3 | MISO | GPIO13 | SD 卡数据输出，此引脚 TFT 不使用 |
| 4 | MOSI | GPIO11 | **与 TFT 共用**，同一根物理线 |
| 5 | SCK | GPIO12 | **与 TFT 共用**，同一根物理线 |
| 6 | CS | GPIO42 | SD 专用片选，与 TFT CS（GPIO10）独立 |

**共享 SPI 总线说明：**
- TFT 和 SD 卡共用 MOSI（GPIO11）和 SCK（GPIO12）
- 通过各自的 CS 引脚区分：操作 TFT 时拉低 GPIO10，操作 SD 时拉低 GPIO42
- 同一时刻只能有一个 CS 为低电平，不可同时操作两个设备
- Arduino/ESP-IDF 的 SPI 库会自动管理 CS，配置正确即可
- 若你换成纯 `3.3V` SPI 卡座，再把该模块 `VCC` 改接 `3.3V`

---

## GPS 模块接线

**模块型号：** Beitian BK-880 GNSS 模块，UART 通信，内置 QMC5883 电子罗盘

> 参考文档：《BK-880 GNSS 模块使用说明书》P2.0 (2025-07-06)
>
> BK-880 提供**两种电气接口**，信号定义相同：
>   1. **1.25mm 6P 卧式贴片座**（随模块自带线束）
>   2. **板上 2.54mm 通孔焊盘**（已实测间距为 2.54mm，可焊标准直插排针）
>
> 本项目洞洞板/PCB 版本使用 **2.54mm 通孔路径**：在模块板上焊 1×6 排针，
> 洞洞板/PCB 上装对应排母座即可插拔。避免处理 1.25mm 线束的压接工艺。
>
> UART TX/RX 为 **3.3V TTL** 电平，可直接接 ESP32-S3。
> **BK-880 不对外提供 PPS 信号**（数据手册 §2.1.3：「1PPS 信号接口：无」）：
> 6P 线束和 2.54mm 通孔均未引出 PPS，模块板上也没有可飞线使用的 PPS 测试焊盘。
> 项目按 UART 到达时间做时间基准，不依赖 PPS。

| # | 模块引脚标注 | I/O | 连接位置 | 说明 |
|---|---|-----|---|---|
| 1 | SDA | O | 未接（预留） | I2C 数据，QMC5883 罗盘（未来可接 ESP32 I2C） |
| 2 | GND | G | ESP32-S3 GND | 接地；必须和 ESP32 共地 |
| 3 | TX | O | GPIO17 | GPS 模块发送 → ESP32 接收（**交叉连接**） |
| 4 | RX | I | GPIO18 | GPS 模块接收 ← ESP32 发送（**交叉连接**） |
| 5 | VCC | I | **5V_SW** | 主电源，DC 3.6-5.5V，推荐 5.0V |
| 6 | SCL | I | 未接（预留） | I2C 时钟，QMC5883 罗盘（未来可接 ESP32 I2C） |

**要点：**
- TX/RX 必须交叉：GPS 的 TX 接 ESP32 的 RX，GPS 的 RX 接 ESP32 的 TX
- 当前代码引脚定义见 [pins.h](/Users/wenchaodu/Documents/Claude_code_projects/ESP32_track_GPS/src/pins.h)：`RX=GPIO17`、`TX=GPIO18`
- `PIN_GPS_PPS` (GPIO16) 在代码中保留以便兼容，**无外部连接**——BK-880 根本不向外输出 PPS，对应 ISR 在运行期永不触发
- 当前固件会自动尝试 `115200 / 38400 / 9600` 三种常见波特率；探测到后会尽量切到 `115200`
- 25Hz 下 NMEA 数据量较大，长期稳定运行仍建议最终工作在 `115200`
- SDA/SCL 为 QMC5883 电子罗盘 I2C 接口，当前项目未使用，线束上预留即可
- 若 GPS 模块单独接 5V 供电，**一定要和 ESP32 共地**

---

## 按钮接线

### 按钮 1：自锁总开关（推荐接法）

自锁按钮不再接到 `GPIO4`，而是直接串在系统 `5V` 正极上，作为整机
总开关使用：

```text
取电板 5V ──────── 自锁按钮 ──────── 5V_SW
取电板 GND ──────────────────────── 公共地
```

| 按钮 | 类型 | 连接方式 | 功能 |
|---|---|---|---|
| 按钮 1 | 12mm **锁定**（自锁）按钮 | 串联在 `5V` 正极 | 系统总开关 |

**要点：**
- 只切 `5V` 正极，**不要切 GND**
- 自锁按钮放在 `5V` 分电点之前，按钮后的电源母线统一记作 `5V_SW`
- `5V_SW` 同时供给 ESP32 `5V/VIN`、GPS `VCC`、SD 模块 `VCC`

### 按钮 2：录制键（GPIO 输入）

```text
GPIO4 ──────── 按钮一端
                  |
               [按钮]
                  |
GND  ──────── 按钮另一端
```

| 按钮 | 类型 | GPIO | 功能 |
|---|---|---|---|
| 按钮 2 | 12mm **瞬动**（自复位）按钮 | GPIO4 | 录制开始 / 停止 |

**代码初始化示例：**
```cpp
pinMode(4, INPUT_PULLUP);  // 按钮2，按下时读到 LOW
```

### GPIO5 扩展键（当前未装配）

当前硬件版本没有把第二颗 GPIO 按键装到 `GPIO5`。固件保留了
`PIN_BTN_SECTOR` 这个扩展位，但在当前设备上它不是必接项。

**要点：**
- 当前量产/原型接线只需要 `GPIO4` 录制键即可
- 若以后增加页面切换或手动扇区功能，可把一颗额外的自复位按钮接到 `GPIO5`
- GPIO 输入按钮启用 `INPUT_PULLUP` 后无需外接上拉电阻

---

## 电源接线

**推荐方案：5V USB-C 电池 → 取电板 → 自锁开关 → `5V_SW` 主电源母线**

```text
5V USB-C 电池
      |
      | USB-C 线
      |
USB-C 取电板 / 分电板
      |
      +---- GND ------------------------------------------+
      |                                                   |
      +---- 5V ---- 自锁按钮 ---- 5V_SW ------------------+----> ESP32 5V / VIN
                                                          +----> GPS VCC
                                                          +----> SD VCC

ESP32 3.3V ----------------------------------------------------> TFT VCC
```

- `5V_SW` 是自锁按钮后的系统主电源母线
- `ESP32` 建议从 `5V/VIN` 供电，不再把电池长期直接插在开发板 USB 口上
- `GPS BK-880` 建议从 `5V_SW` 供电；已确认当前模块 `TX/RX` 是 `3.3V TTL`
- 当前这块带 `1117-3.3` 的 `SD` 模块建议从 `5V_SW` 供电
- `TFT` 继续使用 ESP32 板上的 `3.3V` 引脚供电
- **所有 GND 必须共地**

**烧录模式（推荐操作流程）：**

1. 自锁总开关拨到 `OFF`
2. 电脑 USB 接到 ESP32 开发板
3. 烧录固件
4. 烧录完成后拔掉电脑 USB
5. 自锁总开关拨到 `ON`，恢复电池供电

> 说明：Espressif 官方把 `USB` 供电与 `5V/GND` 针脚供电列为互斥的上电方式。
> 为避免双路 `5V` 互相回灌，烧录时不要让外部 `5V_SW` 同时喂进 ESP32。

**3.3V 引脚电流预算（参考）：**

| 模块 | 典型电流 |
|---|---|
| TFT ILI9341 | ~20 mA |
| LED | ~5-10 mA |
| **合计** | ~25-30 mA |

ESP32-S3 板载 LDO 给 TFT 和少量逻辑负载供电是安全的；GPS 和当前 SD 模块
都不再占用板载 `3.3V` 预算。

---

## ASCII 连接示意图

```
  5V USB-C 电池
         |
         v
  USB-C 取电板 / 分电板
         |
         +--------------------------- GND --------------------------------------+
         |                                                                      |
         +---- 5V ---- [按钮1 自锁总开关] ---- 5V_SW ---------------------------+-----+
                                                                                 |     |
                                                                                 |     |
                                                                                 v     v
                    ┌─────────────────────────────────┐                     GPS BK-880  SD 模块
                    │       ESP32-S3 N16R8 DevKit      │                     VCC ← 5V_SW VCC ← 5V_SW
                    │                                  │                     GND ↔ GND   GND ↔ GND
                    │  5V/VIN ─────────────────────────┼←── 5V_SW             TX  → GPIO17 MOSI←GPIO11
                    │  GND    ─────────────────────────┼↔── GND               RX  ← GPIO18 SCK ←GPIO12
                    │                                  │                                  MISO→GPIO13
                    │  GPIO11 ──── MOSI (SPI共享) ────┼──→ TFT MOS                        CS  ←GPIO42
                    │                                  │
                    │  GPIO16 ──── (预留未用；BK-880 不提供 PPS，无外部连接)
                    │  GPIO12 ──── SCLK (SPI共享) ────┼──→ TFT CLK
                    │  GPIO10 ──── CS ────────────────┼──→ TFT CS
                    │  GPIO9  ──── DC ────────────────┼──→ TFT DC
                    │  GPIO8  ──── RST ───────────────┼──→ TFT RES
                    │  GPIO47 ──── BLK ───────────────┼──→ TFT BLK
                    │  3.3V   ────────────────────────┼──→ TFT VCC
                    │  GND    ────────────────────────┼──→ TFT GND
                    │                                  │
                    │  GPIO4  ──┐   (独立录制键)        │
                    │           ├── [按钮2 录制]        │
                    │  GND    ──┘                      │
                    │                                  │
                    │  GPIO2  ──[220Ω]──[LED]── GND   │
                    │                                  │
                    └─────────────────────────────────┘

SPI 共享总线示意：
  GPIO11 (MOSI) ──┬──→ TFT MOS
                  └──→ SD MOSI

  GPIO12 (SCLK) ──┬──→ TFT CLK
                  └──→ SD SCK

  GPIO13 (MISO) ←── SD MISO   (TFT 无此引脚)

  CS 独立控制：
    GPIO10 → TFT CS（操作 TFT 时拉低）
    GPIO42 → SD CS （操作 SD 时拉低）
```

---

## 注意事项

### 1. 避开的 Strapping 引脚

ESP32-S3 启动时以下引脚电平会影响启动模式，**慎用或避用**：

| 引脚 | 说明 |
|---|---|
| GPIO0 | 启动模式选择（低电平=下载模式），避免接外部上拉/下拉 |
| GPIO3 | JTAG 相关，启动时需为低电平，谨慎使用 |
| GPIO45 | VDD_SPI 电压选择（影响 Flash），不可随意拉高/拉低 |
| GPIO47 | 已用作 TFT BLK；注意该引脚在某些版本中也是 strapping pin，启动完成后可正常使用 |

**GPIO47 特别说明：** 在 ESP32-S3 中，GPIO47 是 strapping pin（控制 ROM 消息打印），默认需为低电平。BLK 背光默认低电平（关背光）不影响启动，上电稳定后再用 PWM 控制，实测无问题。若遇到启动异常，可改接其他非 strapping 引脚。

### 2. 3.3V vs 5V 注意事项

| 模块 | 供电电压 | 说明 |
|---|---|---|
| TFT ILI9341 | **3.3V** | 不可接 5V，会损坏驱动 IC |
| GPS BK-880 | **5V_SW** | 当前项目实测这块载板更适合 5V 输入；UART 仍是 3.3V TTL |
| SD 卡模块 | **5V_SW** | 当前实物这块蓝色模块带 `1117-3.3`，建议接 5V_SW |
| 按钮 | 视接法而定 | 自锁总开关串在 5V 正极；GPIO 按钮只需 GPIO + GND |

### 3. 共享 SPI 总线注意事项

- MOSI（GPIO11）和 SCLK（GPIO12）由 TFT 和 SD 卡共享，使用同一根导线分别接到两个模块
- 同一时刻只能激活一个 CS：操作 TFT 时 GPIO10=LOW、GPIO42=HIGH；操作 SD 时 GPIO42=LOW、GPIO10=HIGH
- Arduino 的 `TFT_eSPI` 库和 `SD` 库均支持共享 SPI 总线，配置文件中指定各自 CS 引脚即可
- SPI 频率：TFT 可达 40-80 MHz；SD 卡建议 25 MHz 以下

### 4. GPS 串口接线验证

- 上电后若 GPS 无 NMEA 输出，首先检查 TX/RX 是否接反
- 当前实测这块 BK-880 在 5V 模块供电下，TX 仍输出约 3.0-3.3V TTL 电平，可直接接 ESP32-S3
- 模块板上的 PPS LED 只是内部秒脉冲的可视指示，没有对外引出的电气接口
- 默认等待 30-60 秒冷启动定位；首次上电或室内环境可能更久

### 5. 走线建议

- SPI 线尽量短，避免长线干扰（特别是高速 TFT 刷新时）
- GPS 模块远离 ESP32 核心，减少 RF 干扰
- 电源线尽量粗短；在 GPS `VCC/GND` 附近建议放 `10μF + 100nF`
- 在 SD 模块 `VCC/GND` 附近建议放 `100μF~220μF + 100nF`
- 在 TFT `3.3V/GND` 附近建议放 `10μF + 100nF`

### 6. 烧录与双供电注意事项

- 运行模式：自锁总开关 `ON`，电池经 `5V_SW` 给 ESP32、GPS、SD 供电
- 烧录模式：自锁总开关 `OFF`，只接电脑 USB 给 ESP32 供电和烧录
- 不建议在外部 `5V_SW` 仍连接 ESP32 `5V/VIN` 时，再把电脑 USB 同时插上
- 若设备正在录制，关机前先停止录制，再断开总电源，可减少 `_recording.vbo.tmp` 恢复压力
- **电池模式下用 live_map（无需 USB）：** 板子上电后，笔记本加入 `KartGPS`
  AP，然后跑 `python3 tools/live_map.py --source udp --offline-map`，浏览器
  打开 `http://127.0.0.1:8080`。固件会把 `[gps-live]` 用 UDP 5555 广播出来；
  `--offline-map` 走本地 canvas 渲染，不依赖 Leaflet/OSM 之类的在线瓦片
  （加入 AP 之后笔记本是没有外网的）。详见
  `docs/superpowers/plans/2026-05-06-wifi-live-map.md`。

---

## 组装与振动加固（点热熔胶）

这块板子最终要上卡丁车（30-80 km/h）。手工焊点和飞线在持续振动下最常见的失效是**焊盘根部疲劳断裂** —— 焊盘把铜从 PCB 上撕下来，整条线脱开。点热熔胶做应力释放是这一类硬件最便宜、最可逆的加固手段。下面是这块板子的具体清单。

### 应该点

**飞线 / 焊接点机械应力释放：**

- **GPS 模块的 1.25mm 6-pin 线束**：在 PCB 接插点上点一坨胶，把头壳和板子粘成一体。振动里头壳被甩动会反复拉焊脚，最容易先死的位置之一。
- **SD 卡座的 6 个引脚根部**：尤其 `VCC` 和 `GND`，焊点面积小、承力大。
- **TFT 排线**（如果是 FPC 直焊而非连接器接入）：FPC 焊点最容易疲劳断。
- **电池 / 取电板到主板的 5V 线**：粗线撕拉力最大，一定要点。
- **USB-C 接口的板上 4 个机械固定脚**（不是 D+/D- 信号脚）：USB-C 反复插拔最爱拽掉。
- **任何天线飞线**（如果是飞线接 SMA / IPEX 转接的）：连接器底部点一坨防反复扭。

**TFT SPI 飞线特殊情况：** GPIO11 (`MOSI`) 和 GPIO12 (`SCLK`) 现在跑 20 MHz，**走线越短越固定信号越干净**。这两根飞线（如果是飞线而非 PCB trace）值得多点一点胶把线压在板面上 —— 既是机械加固，也是信号完整性提升。

**模块级固定：**

- **ESP32-S3 DevKitC-1 排针根部**（如果用排针不直焊）：在板子边缘排针根部点一圈胶柱。
- **TFT 模块四角到 PCB 之间**：用胶柱代替机械螺丝，比纯靠 8 针 0.5mm 焊脚撑着稳得多。

### 不要点

**会发热的器件 —— 胶受热变软甚至流出来：**

- ESP32-S3 模块本体（满载会到 60°C）
- 电源 LDO / 升压模块外壳
- TFT 控制器芯片所在区域

**未来可能要拆 / 改 / 测的点：**

- 测试点 / pogo pin 落点 / 调试排针
- 跳线 / 配置电阻
- BOOT 按钮 / RST 按钮
- 串口 TX / RX 焊盘（万一以后要外接 J-Link / debug 工具）
- **GPIO16 (`PIN_GPS_PPS`)**：v1 暂时空着，未来真接 PPS 飞线会用到，详见
  `~/.claude/projects/-Users-wenchaodu-Documents-Claude-code-projects-ESP32-track-GPS/memory/project_pcb_migration.md` §3。

**信号完整性敏感区：**

- **GPS 模块的陶瓷贴片天线本体和它周围 ~5mm**：胶会改变贴片天线的介电环境，让 NMEA 接收灵敏度下降。
- 27 MHz 晶振 / TFT 时钟相关元件附近：胶受热膨胀有可能引入抖动（小概率，但既然 TFT 时钟我们已经超规格 2x，留点裕度好）。

### 操作要点

1. **温度档位调到中低温**（120-150 °C）。大多数热熔胶枪有高 / 低温两档，**用低温**。高温档会把焊盘上的助焊剂残留化掉，也更可能损伤 ESP32 周围的 PCB 阻焊层。
2. **小点慢点**。一个焊点根部一颗黄豆大就够。多了反而把热量闷在焊点上、增加冷焊风险。
3. **冷却前别动板子**。胶完全凝固前（~30 秒）板子放平，不然胶会拉丝或下沉移位。
4. **拉丝清理**。拔枪头时会拉丝，等细丝凝固了用手指或镊子撕掉，别让丝缠到旁边引脚造成意外短路或干扰 SPI 高速线。
5. **可逆性预期**。胶可以用酒精 + 热风枪 100°C 加温慢慢去掉，但很费事。点之前再次确认这一点是真不会再改了。

---

## GPIO 引脚汇总

| GPIO | 功能 | 说明 |
|---|---|---|
| GPIO2 | LED | 状态指示灯 |
| GPIO4 | REC 输入 | 独立自复位录制按钮 |
| GPIO5 | 预留扩展位 | 当前硬件未装配 |
| GPIO8 | TFT RST | 屏幕复位 |
| GPIO9 | TFT DC | 数据/命令选择 |
| GPIO10 | TFT CS | TFT 片选 |
| GPIO11 | SPI MOSI | TFT + SD 共享 |
| GPIO12 | SPI SCLK | TFT + SD 共享 |
| GPIO13 | SPI MISO | SD 卡专用 |
| GPIO16 | 预留未用 | BK-880 不提供 PPS 信号，此引脚无外部连接 |
| GPIO17 | UART1 RX | 接 GPS TX |
| GPIO18 | UART1 TX | 接 GPS RX |
| GPIO42 | SD CS | SD 卡片选 |
| GPIO47 | TFT BLK | 背光 PWM 控制 |

> 自锁总开关不占用 GPIO；它是串在 `5V` 正极上的物理电源开关。
