icandy7272/ESP32-GPS-Lap-Timer/src/gps_filter.cpp

#include "gps_filter.h"
#include "gps_kalman.h"

#if defined(ARDUINO)
#include <freertos/FreeRTOS.h>
#include <freertos/portmacro.h>
#endif

#include <math.h>

#if defined(ARDUINO)
static portMUX_TYPE s_filter_mux = portMUX_INITIALIZER_UNLOCKED;
#define GPS_FILTER_LOCK() portENTER_CRITICAL(&s_filter_mux)
#define GPS_FILTER_UNLOCK() portEXIT_CRITICAL(&s_filter_mux)
#else
#define GPS_FILTER_LOCK()
#define GPS_FILTER_UNLOCK()
#endif

namespace {

static constexpr float HEADING_RELIABLE_SPEED_KMH = 5.0f;
static constexpr int   RAW_HISTORY_CAPACITY = 5;
static constexpr int   MEDIAN_WINDOW_MIN = 3;
static constexpr float DISPLAY_MEDIAN_MAX_SPEED_KMH = 8.0f;
static constexpr float STATIONARY_SPEED_MAX_KMH = 2.0f;
static constexpr float STATIONARY_HOLD_RADIUS_M = 1.0f;
static constexpr float MAX_FILTER_SPEED_KMH = 140.0f;
static constexpr float MAX_FILTER_ACCEL_MPS2 = 45.0f;
static constexpr float LOW_SPEED_HEADING_FLIP_KMH = 8.0f;
static constexpr float LOW_SPEED_HEADING_FLIP_DEG = 120.0f;
static constexpr float LOW_SPEED_HEADING_FLIP_RADIUS_M = 1.5f;

// After this many consecutive rejects the filter drops its own
// last-filtered baseline and treats the next sample as
// first-after-reset.  Codex P1 from 2026-04-19: without an escape
// hatch, a legitimate large GPS jump (or a recovered signal gap)
// traps the filter into rejecting every subsequent sample because
// they're all judged against the stale pre-jump baseline.  At 1 Hz,
// 5 rejects ≈ 5 s of frozen display, which is the outer edge of
// what is still useful as outlier rejection vs. "just stuck".
static constexpr uint8_t MAX_CONSECUTIVE_REJECTS = 5;

struct GpsFilterState {
    bool display_valid;
    bool match_valid;
    GpsPoint display_fix;
    GpsPoint match_fix;
    GpsFilterDiagnostics diagnostics;
    GpsPoint raw_history[RAW_HISTORY_CAPACITY];
    int raw_history_count;
    int raw_history_next;
    // Consecutive-reject counter.  Resets to 0 the moment a sample is
    // accepted.  Exists purely so we can notice a stale baseline and
    // rebuild it without fully reinitialising the filter.
    uint8_t consecutive_rejects;
    // Alpha-beta (constant-velocity) Kalman state for the display
    // position path.  Replaced the speed-tiered EMA on 2026-04-23
    // after walking tests showed the EMA output still visibly
    // jittered on-screen with the board held stationary — EMA at
    // alpha=0.24 lets 24% of raw noise through every sample, which
    // at 25 Hz and ±3 m typical noise is a clearly visible wobble.
    // Kalman-lite at alpha=0.08 cuts that to ~8% and, more
    // importantly, tracks velocity so it catches up to real motion
    // without lagging.  See src/gps_kalman.cpp for the math.
    GpsKalmanState kalman_display;
};

static GpsFilterState s_state = {};

static int clamp_score(int value) {
    if (value < 0) {
        return 0;
    }
    if (value > 100) {
        return 100;
    }
    return value;
}

static bool has_position_fix(int fix_quality, int fix_type) {
    if (fix_type > 0) {
        return fix_type >= 2;
    }
    return fix_quality == 1 || fix_quality == 2 ||
           fix_quality == 4 || fix_quality == 5;
}

static bool has_3d_fix(int fix_quality, int fix_type, int satellites) {
    if (fix_type > 0) {
        return fix_type >= 3;
    }
    return has_position_fix(fix_quality, fix_type) && satellites >= 6;
}

static int score_fix_quality(int fix_quality) {
    switch (fix_quality) {
        case 4: return 34;  // RTK fixed
        case 5: return 32;  // RTK float
        case 2: return 28;  // DGPS
        case 1: return 22;  // Autonomous GPS
        default: return 0;
    }
}

static int score_fix_type(int fix_type) {
    if (fix_type >= 3) {
        return 20;
    }
    if (fix_type == 2) {
        return 6;
    }
    return 0;
}

static int score_satellites(int satellites) {
    if (satellites >= 15) return 18;
    if (satellites >= 12) return 15;
    if (satellites >= 9)  return 12;
    if (satellites >= 7)  return 8;
    if (satellites >= 5)  return 4;
    return 0;
}

static int score_hdop(float hdop) {
    if (hdop <= 0.0f) return 6;  // GSA absent; do not over-reward.
    if (hdop <= 0.9f) return 18;
    if (hdop <= 1.5f) return 15;
    if (hdop <= 2.5f) return 10;
    if (hdop <= 4.0f) return 4;
    return 0;
}

static int score_pdop(float pdop) {
    if (pdop <= 0.0f) return 4;
    if (pdop <= 1.5f) return 10;
    if (pdop <= 2.5f) return 8;
    if (pdop <= 4.0f) return 4;
    return 0;
}

static uint8_t tier_for_score(uint8_t score) {
    if (score >= 80) return GPS_QUALITY_TIER_EXCELLENT;
    if (score >= 60) return GPS_QUALITY_TIER_GOOD;
    if (score >= 40) return GPS_QUALITY_TIER_FAIR;
    return GPS_QUALITY_TIER_POOR;
}

static double deg_to_rad(double deg) {
    return deg * 0.017453292519943295;
}

static double approx_distance_m(double lat1_deg,
                                double lon1_deg,
                                double lat2_deg,
                                double lon2_deg) {
    double lat1 = deg_to_rad(lat1_deg);
    double lat2 = deg_to_rad(lat2_deg);
    double d_lat = lat2 - lat1;
    double d_lon = deg_to_rad(lon2_deg - lon1_deg);
    double x = d_lon * cos((lat1 + lat2) * 0.5);
    double y = d_lat;
    return 6371000.0 * sqrt((x * x) + (y * y));
}

static void sort_values(double* values, int count) {
    for (int i = 1; i < count; i++) {
        double key = values[i];
        int j = i - 1;
        while (j >= 0 && values[j] > key) {
            values[j + 1] = values[j];
            j--;
        }
        values[j + 1] = key;
    }
}

// display_alpha_for_speed removed 2026-04-23 — the display path now
// uses gps_kalman_update (alpha-beta, constant-velocity) instead of
// the speed-tiered EMA.  match_alpha_for_speed is kept because the
// match path (fed to lap_timer's secondary smoothed stream) still
// uses EMA; that path wants a faster response to track geometry
// and doesn't share the stationary-jitter problem Kalman solves.

static float match_alpha_for_speed(float speed_kmh) {
    if (speed_kmh < 2.0f) return 0.35f;
    if (speed_kmh < 5.0f) return 0.42f;
    if (speed_kmh < 12.0f) return 0.55f;
    if (speed_kmh < 25.0f) return 0.68f;
    return 0.78f;
}

static double blend_double(double prev, double next, float alpha) {
    return prev + ((next - prev) * alpha);
}

static float blend_float(float prev, float next, float alpha) {
    return prev + ((next - prev) * alpha);
}

static void push_raw_history(const GpsPoint& raw_fix) {
    s_state.raw_history[s_state.raw_history_next] = raw_fix;
    s_state.raw_history_next =
        (s_state.raw_history_next + 1) % RAW_HISTORY_CAPACITY;
    if (s_state.raw_history_count < RAW_HISTORY_CAPACITY) {
        s_state.raw_history_count++;
    }
}

static int raw_history_start() {
    return (s_state.raw_history_next - s_state.raw_history_count
            + RAW_HISTORY_CAPACITY) % RAW_HISTORY_CAPACITY;
}

static GpsPoint raw_history_at(int offset_from_oldest) {
    int idx = (raw_history_start() + offset_from_oldest) % RAW_HISTORY_CAPACITY;
    return s_state.raw_history[idx];
}

static double median_recent_coord(bool latitude) {
    double values[RAW_HISTORY_CAPACITY] = {};
    int count = s_state.raw_history_count;

    for (int i = 0; i < count; i++) {
        GpsPoint point = raw_history_at(i);
        values[i] = latitude ? point.lat_deg : point.lon_deg;
    }

    sort_values(values, count);
    return values[count / 2];
}

static GpsPoint apply_display_median(const GpsPoint& raw_fix) {
    GpsPoint filtered = raw_fix;
    if (raw_fix.speed_kmh > DISPLAY_MEDIAN_MAX_SPEED_KMH ||
        s_state.raw_history_count < MEDIAN_WINDOW_MIN) {
        return filtered;
    }

    filtered.lat_deg = median_recent_coord(true);
    filtered.lon_deg = median_recent_coord(false);
    return filtered;
}

static double time_delta_s(const GpsPoint& previous_fix,
                           const GpsPoint& next_fix) {
    int64_t delta_us = next_fix.timestamp_us - previous_fix.timestamp_us;
    if (delta_us <= 0) {
        return 0.0;
    }
    return static_cast<double>(delta_us) / 1000000.0;
}

static float heading_delta_deg(float a_deg, float b_deg) {
    float delta = fmodf(fabsf(a_deg - b_deg), 360.0f);
    if (delta > 180.0f) {
        delta = 360.0f - delta;
    }
    return delta;
}

static bool exceeds_implied_speed_limit(const GpsPoint& previous_fix,
                                        const GpsPoint& next_fix) {
    double dt_s = time_delta_s(previous_fix, next_fix);
    if (dt_s <= 0.0) {
        return false;
    }

    double step_m = approx_distance_m(previous_fix.lat_deg, previous_fix.lon_deg,
                                      next_fix.lat_deg, next_fix.lon_deg);
    double implied_speed_kmh = (step_m / dt_s) * 3.6;
    return implied_speed_kmh > MAX_FILTER_SPEED_KMH;
}

static bool exceeds_acceleration_limit(const GpsPoint& previous_fix,
                                       const GpsPoint& next_fix) {
    double dt_s = time_delta_s(previous_fix, next_fix);
    if (dt_s <= 0.0) {
        return false;
    }

    double dv_mps = fabs(static_cast<double>(next_fix.speed_kmh)
                       - static_cast<double>(previous_fix.speed_kmh)) / 3.6;
    double accel_mps2 = dv_mps / dt_s;
    return accel_mps2 > MAX_FILTER_ACCEL_MPS2;
}

static bool has_low_speed_heading_flip(const GpsPoint& previous_fix,
                                       const GpsPoint& next_fix) {
    if (previous_fix.speed_kmh > LOW_SPEED_HEADING_FLIP_KMH ||
        next_fix.speed_kmh > LOW_SPEED_HEADING_FLIP_KMH) {
        return false;
    }

    double step_m = approx_distance_m(previous_fix.lat_deg, previous_fix.lon_deg,
                                      next_fix.lat_deg, next_fix.lon_deg);
    if (step_m > LOW_SPEED_HEADING_FLIP_RADIUS_M) {
        return false;
    }

    return heading_delta_deg(previous_fix.heading_deg, next_fix.heading_deg)
        > LOW_SPEED_HEADING_FLIP_DEG;
}

static bool should_reject_fix(const GpsPoint& previous_fix,
                              const GpsPoint& next_fix) {
    return exceeds_implied_speed_limit(previous_fix, next_fix)
        || exceeds_acceleration_limit(previous_fix, next_fix)
        || has_low_speed_heading_flip(previous_fix, next_fix);
}

static void apply_heading_freeze(GpsPoint* fix,
                                 const GpsPoint& previous_fix) {
    if (fix->heading_reliable &&
        fix->speed_kmh >= HEADING_RELIABLE_SPEED_KMH) {
        return;
    }

    fix->heading_deg = previous_fix.heading_deg;
    s_state.diagnostics.heading_freezes++;
}

static void apply_stationary_hold(GpsPoint* fix,
                                  const GpsPoint& previous_fix) {
    if (fix->speed_kmh > STATIONARY_SPEED_MAX_KMH) {
        return;
    }

    double step_m = approx_distance_m(previous_fix.lat_deg, previous_fix.lon_deg,
                                      fix->lat_deg, fix->lon_deg);
    if (step_m > STATIONARY_HOLD_RADIUS_M) {
        return;
    }

    fix->lat_deg = previous_fix.lat_deg;
    fix->lon_deg = previous_fix.lon_deg;
    fix->speed_kmh = 0.0f;
    s_state.diagnostics.stationary_holds++;
}

static GpsPoint apply_ema(const GpsPoint& previous_fix,
                          const GpsPoint& candidate,
                          float alpha) {
    GpsPoint filtered = candidate;
    filtered.lat_deg = blend_double(previous_fix.lat_deg,
                                    candidate.lat_deg,
                                    alpha);
    filtered.lon_deg = blend_double(previous_fix.lon_deg,
                                    candidate.lon_deg,
                                    alpha);
    filtered.speed_kmh = blend_float(previous_fix.speed_kmh,
                                     candidate.speed_kmh,
                                     alpha);
    return filtered;
}

static void store_filter_outputs(const GpsFilterProcessResult& result) {
    GPS_FILTER_LOCK();
    s_state.display_valid = result.display_valid;
    s_state.match_valid = result.match_valid;
    s_state.display_fix = result.display_fix;
    s_state.match_fix = result.match_fix;
    GPS_FILTER_UNLOCK();
}

}  // namespace

GpsQualityResult gps_filter_assess_quality(const GpsQualityInput& input) {
    GpsQualityResult result = {};

    if (!has_position_fix(input.fix_quality, input.fix_type)) {
        return result;
    }

    int score = score_fix_quality(input.fix_quality)
              + score_fix_type(input.fix_type)
              + score_satellites(input.satellites)
              + score_hdop(input.hdop)
              + score_pdop(input.pdop);

    result.fix_3d = has_3d_fix(input.fix_quality,
                               input.fix_type,
                               input.satellites);
    result.quality_score = static_cast<uint8_t>(clamp_score(score));
    result.quality_tier = tier_for_score(result.quality_score);
    result.heading_reliable = result.fix_3d
                           && input.speed_kmh >= HEADING_RELIABLE_SPEED_KMH
                           && result.quality_score >= 50;
    return result;
}

void gps_filter_reset() {
    GPS_FILTER_LOCK();
    s_state = {};
    GPS_FILTER_UNLOCK();
}

GpsFilterProcessResult gps_filter_process(const GpsPoint& raw_fix) {
    GpsFilterProcessResult result = {};

    result.raw_fix = raw_fix;
    result.display_valid = true;
    result.match_valid = true;

    // Decide reject BEFORE updating history.  Two reasons:
    //   - Codex P2 from 2026-04-19: pushing the raw fix into
    //     raw_history before the reject rules run let rejected spikes
    //     leak into subsequent frames' display medians, undoing the
    //     reject.
    //   - Gating the history push on "not rejected by display" keeps
    //     the reject thresholds themselves working against the same
    //     stream of samples they always did — we only changed which
    //     samples the downstream median gets to see.
    bool reject_display = s_state.display_valid
                       && should_reject_fix(s_state.display_fix, raw_fix);
    bool reject_match = s_state.match_valid
                     && should_reject_fix(s_state.match_fix, raw_fix);

    // Escape hatch — Codex P1 from 2026-04-19.  Without this, a
    // genuine GPS jump (tunnel exit, RTK fix acquisition, cold-start
    // bias) gets rejected, then every subsequent sample also gets
    // rejected because should_reject_fix still compares against the
    // stale pre-jump baseline.  display_fix / match_fix look frozen
    // from the UI's perspective even though raw data has long since
    // recovered.  After MAX_CONSECUTIVE_REJECTS rejects in a row, we
    // discard the stale baseline and treat the current sample as
    // first-after-reset, rebuilding cleanly.
    if ((reject_display || reject_match) &&
        s_state.consecutive_rejects >= MAX_CONSECUTIVE_REJECTS) {
        // display_valid / match_valid are read by the accessors under
        // GPS_FILTER_LOCK; take the same lock so we don't tear their
        // transition from true to false against a concurrent reader.
        // consecutive_rejects and diagnostics are single-writer from
        // inside gps_filter_process, so they don't strictly need the
        // lock — but holding it briefly costs nothing and keeps the
        // "filter state transitions happen atomically" invariant.
        GPS_FILTER_LOCK();
        s_state.display_valid = false;
        s_state.match_valid = false;
        s_state.consecutive_rejects = 0;
        s_state.diagnostics.filter_resets++;
        // Codex 2026-04-23 review finding 1 (HIGH): the escape hatch
        // originally only cleared display_valid / match_valid, which
        // was sufficient when the display path was EMA-only.  Now
        // that Kalman holds its own position + velocity state, and
        // the low-speed median reads from raw_history, failing to
        // clear those means the "first-after-reset" comment above is
        // a lie — Kalman would keep predicting from the stale
        // pre-jump velocity and the median would blend the new
        // accepted sample with whatever survived from before.  Zero
        // everything the accepted-sample path reads from so the next
        // accepted sample is actually a fresh seed.
        gps_kalman_reset(&s_state.kalman_display);
        s_state.raw_history_count = 0;
        s_state.raw_history_next = 0;
        GPS_FILTER_UNLOCK();
        // No baseline means nothing to reject against.
        reject_display = false;
        reject_match = false;
    }

    if (!reject_display) {
        push_raw_history(raw_fix);
    }

    GpsPoint display_fix = apply_display_median(raw_fix);
    GpsPoint match_fix = raw_fix;

    if (reject_display) {
        result.display_fix = s_state.display_fix;
        result.display_rejected = true;
        s_state.diagnostics.display_outlier_drops++;
    } else {
        // Order matters here:
        //   1. apply_display_median (already done above) — strips
        //      isolated single-sample spikes below the reject
        //      threshold.  Keeps Kalman from having to reject them.
        //   2. apply_stationary_hold — if speed is near zero AND the
        //      step from the previous filtered position is < 1 m,
        //      snap to previous.  This produces a perfect residual
        //      of zero going into Kalman, so the filter's position
        //      state does not drift when the receiver is truly
        //      stationary.  Only meaningful when we have a previous
        //      filtered fix to compare against.
        //   3. gps_kalman_update — the constant-velocity alpha-beta
        //      filter.  Self-manages seed vs. update (first call
        //      after reset passes through unchanged), so it works
        //      on the display_valid=false path too.
        //   4. apply_heading_freeze — heading isn't filtered by
        //      Kalman (we only track position + position-velocity),
        //      so the legacy heading hold stays in.
        if (s_state.display_valid) {
            apply_stationary_hold(&display_fix, s_state.display_fix);
        }

        GpsKalmanInput kin = {};
        kin.lat_deg   = display_fix.lat_deg;
        kin.lon_deg   = display_fix.lon_deg;
        kin.t_us      = raw_fix.timestamp_us;
        kin.speed_kmh = raw_fix.speed_kmh;
        GpsKalmanOutput kout = {};
        if (gps_kalman_update(&s_state.kalman_display, kin, &kout)) {
            display_fix.lat_deg = kout.lat_deg;
            display_fix.lon_deg = kout.lon_deg;
        }

        if (s_state.display_valid) {
            apply_heading_freeze(&display_fix, s_state.display_fix);
        }
        result.display_fix = display_fix;
    }

    if (reject_match) {
        result.match_fix = s_state.match_fix;
        result.match_rejected = true;
        s_state.diagnostics.match_outlier_drops++;
    } else if (s_state.match_valid) {
        match_fix = apply_ema(s_state.match_fix,
                              match_fix,
                              match_alpha_for_speed(raw_fix.speed_kmh));
        apply_heading_freeze(&match_fix, s_state.match_fix);
        result.match_fix = match_fix;
    } else {
        result.match_fix = match_fix;
    }

    store_filter_outputs(result);

    // Maintain the consecutive-reject counter that feeds the escape
    // hatch at the top of this function.  A single accepted sample
    // clears it.  A rejected sample increments it, clamped so it
    // cannot wrap and silently defuse the hatch.
    if (reject_display || reject_match) {
        if (s_state.consecutive_rejects < UINT8_MAX) {
            s_state.consecutive_rejects++;
        }
    } else {
        s_state.consecutive_rejects = 0;
    }

    return result;
}

bool gps_filter_get_display_fix(GpsPoint* out) {
    if (out == nullptr) {
        return false;
    }

    GPS_FILTER_LOCK();
    bool valid = s_state.display_valid;
    if (valid) {
        *out = s_state.display_fix;
    }
    GPS_FILTER_UNLOCK();
    return valid;
}

bool gps_filter_get_match_fix(GpsPoint* out) {
    if (out == nullptr) {
        return false;
    }

    GPS_FILTER_LOCK();
    bool valid = s_state.match_valid;
    if (valid) {
        *out = s_state.match_fix;
    }
    GPS_FILTER_UNLOCK();
    return valid;
}

GpsFilterDiagnostics gps_filter_get_diagnostics() {
    GPS_FILTER_LOCK();
    GpsFilterDiagnostics diagnostics = s_state.diagnostics;
    GPS_FILTER_UNLOCK();
    return diagnostics;
}
