icandy7272/ESP32-GPS-Lap-Timer/src/gps/gps_fix.cpp

#include "gps/gps_internal.h"
#include "gps/gps_constellation.h"
#include "gps_fix_bundle.h"
#include "gps_filter.h"
#include "wifi_server.h"

#include <esp_timer.h>
#include <stdio.h>

namespace {

static constexpr float GPS_DIAG_LOW_SPEED_KMH = 5.0f;
static uint8_t s_live_stream_rate_hz = 0;

}

void gps_set_live_stream_rate(uint8_t rate_hz) {
    if (rate_hz > GPS_FIX_RATE_HZ) {
        rate_hz = GPS_FIX_RATE_HZ;
    }
    s_live_stream_rate_hz = rate_hz;
}

uint8_t gps_get_live_stream_rate() {
    return s_live_stream_rate_hz;
}

static bool is_pps_fresh() {
    int64_t now = esp_timer_get_time();
    int64_t last_pps = pps_read();
    return (last_pps > 0) && ((now - last_pps) < PPS_STALE_US);
}

static int64_t compute_timestamp(int fix_index) {
    int64_t base = pps_read();
    return base + (static_cast<int64_t>(fix_index) * FIX_INTERVAL_US);
}

static GpsPoint assemble_point(const GgaData* gga, const RmcData* rmc) {
    bool pps_ok = is_pps_fresh();

    GpsQualityInput quality_input = {};
    quality_input.fix_quality = gga->fix_quality;
    quality_input.fix_type = s_gsa.valid ? s_gsa.fix_type : 0;
    quality_input.satellites = gga->satellites;
    quality_input.speed_kmh = rmc->speed_kmh;
    // HDOP: prefer GSA (dedicated DOP sentence, aligned with the
    // same fix) but fall back to GGA field 7 when GSA is not
    // enabled.  The default u-blox config emits "GGA + RMC only"
    // to save radio time, so without this fallback HDOP is stuck
    // at the -1.0 sentinel and live_map shows it as "-".
    quality_input.hdop = s_gsa.valid ? s_gsa.hdop :
                         (gga->hdop >= 0.0f ? gga->hdop : -1.0f);
    quality_input.pdop = s_gsa.valid ? s_gsa.pdop : -1.0f;
    GpsQualityResult quality = gps_filter_assess_quality(quality_input);

    GpsPoint point = {};
    point.lat_deg      = gga->lat_deg;
    point.lon_deg      = gga->lon_deg;
    point.height_m     = gga->height_m;
    point.satellites   = gga->satellites;
    point.speed_kmh    = rmc->speed_kmh;
    point.heading_deg  = rmc->heading_deg;

    point.fix_3d           = quality.fix_3d;
    point.pps_synced       = pps_ok;
    point.hdop             = quality_input.hdop;
    point.quality_score    = quality.quality_score;
    point.quality_tier     = quality.quality_tier;
    point.heading_reliable = quality.heading_reliable;

    if (pps_ok) {
        point.timestamp_us = compute_timestamp(s_fix_idx);
    } else {
        point.timestamp_us = esp_timer_get_time();
    }

    return point;
}

void gps_send_fix_if_ready() {
    if (!s_gga.valid || !s_rmc.valid) {
        return;
    }

    int64_t current_pps = pps_read();
    if (current_pps != s_last_pps_seen) {
        s_last_pps_seen = current_pps;
        s_fix_idx = 0;
    }

    GpsPoint point = assemble_point(&s_gga, &s_rmc);
    GpsFilterProcessResult filter_result = gps_filter_process(point);
    GpsFixBundle bundle = gps_fix_bundle_from_filter_result(filter_result);

    bool queue_was_full = false;
    if (xQueueSend(s_gps_queue, &bundle, 0) == errQUEUE_FULL) {
        queue_was_full = true;
        GpsFixBundle discard;
        xQueueReceive(s_gps_queue, &discard, 0);
        xQueueSend(s_gps_queue, &bundle, 0);
    }

    uint32_t now_ms = millis();
    uint8_t live_rate_hz = s_live_stream_rate_hz;
    if (live_rate_hz > 0) {
        static uint32_t last_live_ms = 0;
        uint32_t live_period_ms = 1000UL / live_rate_hz;
        if (live_period_ms == 0) {
            live_period_ms = 1;
        }
        if (last_live_ms == 0 || now_ms - last_live_ms >= live_period_ms) {
            // Emit the FILTERED position, not the raw one.
            //
            // Before 2026-04-23 this line read point.lat_deg / lon_deg
            // directly — i.e. the raw assembled GGA/RMC.  That meant
            // live_map.py was looking at the unfiltered receiver output
            // the entire time, while the LCD got the Kalman-smoothed
            // display_fix.  Result: the browser view wobbled by the
            // full ±3 m noise envelope even after EMA/Kalman tuning.
            //
            // Fallback to the raw fix if the filter has no accepted
            // sample yet (first-fix, post-reset, or many consecutive
            // rejects) — losing some smoothing for one or two frames
            // at startup beats emitting no position at all.
            GpsPoint emit_point = point;
            GpsPoint filtered = {};
            if (gps_filter_get_display_fix(&filtered)) {
                emit_point.lat_deg = filtered.lat_deg;
                emit_point.lon_deg = filtered.lon_deg;
            }
            // Format the line once, then ship the same bytes out
            // both transports.  Keeping the formatter in one place
            // guarantees Serial and UDP can never drift in field
            // names, precision, or ordering — tools/live_map.py
            // doesn't have to care which transport delivered the
            // line.  160 bytes is comfortably wider than the longest
            // realistic payload (~135 bytes including newline).
            char buf[160];
            int n = snprintf(buf, sizeof(buf),
                             "[gps-live] lat=%.7f lon=%.7f sats=%d fix_3d=%d "
                             "speed=%.2f head=%.1f hdop=%.1f q=%u tier=%u "
                             "t_us=%lld\n",
                             emit_point.lat_deg, emit_point.lon_deg,
                             emit_point.satellites, emit_point.fix_3d ? 1 : 0,
                             (double)emit_point.speed_kmh,
                             (double)emit_point.heading_deg,
                             (double)emit_point.hdop,
                             emit_point.quality_score,
                             emit_point.quality_tier,
                             (long long)emit_point.timestamp_us);
            if (n > 0) {
                size_t out_len = (n < (int)sizeof(buf))
                                     ? (size_t)n
                                     : sizeof(buf) - 1;
                Serial.write(reinterpret_cast<const uint8_t*>(buf), out_len);
                // 2026-05-09 field-test diagnostic: temporarily disable
                // the UDP broadcast path to rule it out as a contributor
                // to the display-task PANIC chain (crash_bc_core1=61).
                // Re-enable once the next field test isolates whether
                // the crash recurs without UDP traffic.
                // gps_live_udp_broadcast(buf, out_len);
            }
            last_live_ms = now_ms;
        }
    }

    static uint32_t last_diag_ms = 0;
    static uint16_t accepted_since_last = 0;
    static uint16_t drops_since_last = 0;
    static uint16_t low_speed_since_last = 0;
    static int min_sats_since_last = 99;
    static int max_sats_since_last = 0;

    accepted_since_last++;
    if (queue_was_full) {
        drops_since_last++;
    }
    if (point.speed_kmh < GPS_DIAG_LOW_SPEED_KMH) {
        low_speed_since_last++;
    }
    if (point.satellites < min_sats_since_last) {
        min_sats_since_last = point.satellites;
    }
    if (point.satellites > max_sats_since_last) {
        max_sats_since_last = point.satellites;
    }

    if (now_ms - last_diag_ms >= 1000) {
        int min_sats = (accepted_since_last > 0) ? min_sats_since_last : 0;
        int max_sats = (accepted_since_last > 0) ? max_sats_since_last : 0;
        static GpsFilterDiagnostics last_filter_diag = {};
        GpsFilterDiagnostics current_filter_diag = gps_filter_get_diagnostics();
        uint32_t rejected_display = current_filter_diag.display_outlier_drops
                                  - last_filter_diag.display_outlier_drops;
        uint32_t rejected_match = current_filter_diag.match_outlier_drops
                                - last_filter_diag.match_outlier_drops;
        last_filter_diag = current_filter_diag;

        Serial.printf("[gps] accepted=%u/s drops=%u sats=%d-%d low=%u "
                      "fix_q=%d fix_3d=%d hdop=%.1f q=%u tier=%u head=%d "
                      "rej_d=%lu rej_m=%lu "
                      "pps=%d lat=%.5f lon=%.5f\n",
                      accepted_since_last, drops_since_last,
                      min_sats, max_sats, low_speed_since_last,
                      s_gga.fix_quality,
                      point.fix_3d ? 1 : 0, point.hdop,
                      point.quality_score, point.quality_tier,
                      point.heading_reliable ? 1 : 0,
                      static_cast<unsigned long>(rejected_display),
                      static_cast<unsigned long>(rejected_match),
                      point.pps_synced ? 1 : 0,
                      point.lat_deg, point.lon_deg);
        // Per-constellation counts from GSV — emitted as its own
        // structured line so parsers don't have to de-interleave from
        // the wider [gps] summary.
        gps_constellation_log_if_dirty();

        last_diag_ms = now_ms;
        accepted_since_last = 0;
        drops_since_last = 0;
        low_speed_since_last = 0;
        min_sats_since_last = 99;
        max_sats_since_last = 0;
    }

    s_fix_idx++;
    if (s_fix_idx >= GPS_FIX_RATE_HZ) {
        s_fix_idx = 0;
    }

    s_gga.valid = false;
    s_rmc.valid = false;
}
