icandy7272/ESP32-GPS-Lap-Timer/src/wifi/wifi_server.cpp

// ============================================================
// WiFi AP + HTTP server — ESP32-S3 GPS Lap Timer
// Provides: web dashboard, session/track API, VBO download,
// settings management.  Uses ESP32 WebServer library.
//
// Requires: WiFi.h, WebServer.h (Arduino ESP32 core)
// spi_mutex / session_mutex must be created before wifi_init().
// ============================================================

#include "wifi_server.h"
#include "wifi_internal.h"
#include "config.h"
#include "types.h"
#include "pins.h"

#include <Arduino.h>
#include <WiFi.h>
#include <WebServer.h>
#include <WiFiUdp.h>

// --- HTTP server on port 80 ---
WebServer server(80);

// --- Recording-mode throttle ---
unsigned long last_request_ms = 0;

// --- gps-live UDP broadcast (best-effort) -------------------------------
// Mirrors gps_fix.cpp's [gps-live] Serial.printf line out over UDP so
// tools/live_map.py can be driven from WiFi when USB is not available
// (battery-powered field testing).  Best-effort: failures are silent so
// the GPS task is never blocked on networking.
namespace {
static constexpr uint16_t kGpsLiveUdpPort = 5555;
WiFiUDP s_gps_live_udp;
bool s_gps_live_udp_ready = false;

void gps_live_udp_init() {
    // Bind a local UDP endpoint on the AP interface.  The local port
    // is incidental — we only ever transmit — but begin() is required
    // before beginPacket()/endPacket() will actually flush.
    if (s_gps_live_udp.begin(kGpsLiveUdpPort) == 1) {
        s_gps_live_udp_ready = true;
        Serial.printf("[wifi] gps-live UDP broadcast on port %u\n",
                      (unsigned)kGpsLiveUdpPort);
    } else {
        s_gps_live_udp_ready = false;
        Serial.println("[wifi] gps-live UDP begin() failed; broadcast disabled");
    }
}
}  // namespace

// ============================================================
// Initialisation
// ============================================================

void wifi_init() {
    WiFi.mode(WIFI_AP);
    WiFi.softAP(app_config.wifi_ssid, app_config.wifi_pass);

    IPAddress ip = WiFi.softAPIP();
    Serial.printf("[wifi] AP started: SSID=%s  IP=%s\n",
                  app_config.wifi_ssid, ip.toString().c_str());

    server.on("/",               HTTP_GET,  handle_root);
    server.on("/api/status",     HTTP_GET,  handle_api_status);
    server.on("/api/sessions",   HTTP_GET,  handle_api_sessions);
    server.on("/api/tracks",        HTTP_GET,  handle_api_tracks);
    server.on("/api/tracks",        HTTP_POST, handle_api_tracks_post);
    server.on("/api/tracks/select", HTTP_POST, handle_api_tracks_select);
    server.on("/api/tracks/delete", HTTP_POST, handle_api_tracks_delete);
    // Draft validation — Phase B.  Clients POST a candidate line, GET
    // the accepted/rejected counts + last-N candidates while the
    // operator walks across it, and DELETE (or POST empty) to clear.
    server.on("/api/tracks/draft_validation", HTTP_POST,
              handle_api_tracks_draft_validation_post);
    server.on("/api/tracks/draft_validation", HTTP_GET,
              handle_api_tracks_draft_validation_get);
    server.on("/api/tracks/draft_validation", HTTP_DELETE,
              handle_api_tracks_draft_validation_delete);
    server.on("/api/recording",     HTTP_POST, handle_api_recording);
    server.on("/api/settings",      HTTP_GET,  handle_api_settings_get);
    server.on("/api/settings",      HTTP_POST, handle_api_settings_post);
    server.onNotFound(handle_not_found);

    server.begin();
    Serial.println("[wifi] HTTP server started on port 80");

    // Bring the gps-live UDP broadcaster up alongside the HTTP server.
    // Must come AFTER softAP() so the WiFi stack has a bound interface.
    gps_live_udp_init();
}

void gps_live_udp_broadcast(const char* line, size_t len) {
    if (!s_gps_live_udp_ready || line == nullptr || len == 0) {
        return;
    }
    // 255.255.255.255 is the limited broadcast address.  On this
    // hardware the AP subnet (192.168.4.0/24) is the only attached
    // network, so the WiFi stack scopes the broadcast to that subnet
    // automatically — same effect as 192.168.4.255 with less ceremony.
    if (s_gps_live_udp.beginPacket(IPAddress(255, 255, 255, 255),
                                   kGpsLiveUdpPort) == 0) {
        return;
    }
    s_gps_live_udp.write(reinterpret_cast<const uint8_t*>(line), len);
    // Return value intentionally ignored — best-effort transmit.
    s_gps_live_udp.endPacket();
}

// ============================================================
// FreeRTOS task
// ============================================================

extern int crash_bc_core1;

void wifi_task(void* param) {
    (void)param;
    for (;;) {
        crash_bc_core1 = 50;  // wifi: about to handleClient
        server.handleClient();
        crash_bc_core1 = 51;  // wifi: handleClient done
        vTaskDelay(pdMS_TO_TICKS(10));
    }
}

// ============================================================
// Throttle helper — limit requests during recording
// ============================================================

bool is_throttled() {
    // Read only the is_recording flag — avoids copying the full ~4KB
    // SessionState onto the wifi task stack (8KB limit).
    bool recording = false;
    if (xSemaphoreTake(session_mutex, pdMS_TO_TICKS(50)) == pdTRUE) {
        recording = session_state.is_recording;
        xSemaphoreGive(session_mutex);
    }
    if (!recording) {
        return false;
    }
    unsigned long now = millis();
    if (now - last_request_ms < RECORDING_THROTTLE_MS) {
        return true;
    }
    last_request_ms = now;
    return false;
}

// ============================================================
// Thread-safe session state snapshot
// ============================================================

SessionState read_session_state() {
    SessionState ss;
    if (xSemaphoreTake(session_mutex, pdMS_TO_TICKS(50)) == pdTRUE) {
        ss = session_state;
        xSemaphoreGive(session_mutex);
    } else {
        memset(&ss, 0, sizeof(ss));
    }
    return ss;
}
