icandy7272/ESP32-GPS-Lap-Timer/src/lap_timer/lap_timer_task.cpp

#include "lap_timer_internal.h"

#include "../track.h"
#include "../track_runtime.h"
#include "../session.h"

#include <Arduino.h>
#include <esp_task_wdt.h>
#include <string.h>

namespace {

void forward_vbo_entry(QueueHandle_t vbo_queue, const GpsPoint* pt) {
    VboEntry entry;
    entry.satellites = pt->satellites;
    entry.timestamp_us = pt->timestamp_us;
    entry.lat_deg = pt->lat_deg;
    entry.lon_deg = pt->lon_deg;
    entry.speed_kmh = pt->speed_kmh;
    entry.heading_deg = pt->heading_deg;
    entry.height_m = pt->height_m;
    xQueueSend(vbo_queue, &entry, 0);
}

}  // namespace

void lap_timer_task(void* param) {
    (void)param;

    using namespace lap_timer_internal;

    esp_task_wdt_add(NULL);

    GpsFixBundle fix;
    GpsPoint curr;
    GpsPoint prev;
    bool has_prev = false;
    bool auto_detected = false;
    uint32_t shadow_version_seen = 0;

    for (;;) {
        if (xQueueReceive(s_gps_queue, &fix, pdMS_TO_TICKS(200)) != pdTRUE) {
            esp_task_wdt_reset();
            continue;
        }
        curr = fix.raw_fix;

        // Refresh the track shadow if a writer has bumped the version
        // since our last copy.  The volatile read + version-counter
        // pattern means we only pay the mutex cost on actual change
        // (user-initiated track select/delete), not on every fix.
        if (s_active_track_version != shadow_version_seen) {
            if (xSemaphoreTake(s_session_mutex, pdMS_TO_TICKS(10)) == pdTRUE) {
                extern TrackDefinition active_track;
                s_track_shadow = active_track;
                shadow_version_seen = s_active_track_version;
                xSemaphoreGive(s_session_mutex);
            }
        }

        if (!auto_detected && curr.fix_3d) {
            SessionState ss = {};
            if (xSemaphoreTake(s_session_mutex, pdMS_TO_TICKS(10)) == pdTRUE) {
                ss = session_state;
                xSemaphoreGive(s_session_mutex);
            }

            if (!track_runtime_should_apply_late_auto_detect(
                    ss.is_recording, ss.track_name)) {
                auto_detected = true;
                continue;
            }

            // Candidate counter — also migrated to copy-out APIs so
            // a concurrent WiFi-task track_delete can't shift
            // s_tracks[] out from under the iteration (codex review
            // 2026-04-22 round 4 Low: previously used
            // track_count() + track_get() raw pointers).  The count
            // is purely diagnostic ("N candidate(s) within 5km" in
            // the log line below), so a BUSY store or a mid-loop
            // delete both safely degrade to a slightly lower count.
            int candidates = 0;
            int total = track_snapshot_count();
            for (int ti = 0; ti < total; ti++) {
                TrackDefinition cand = {};
                if (track_copy_at(ti, &cand) != TRACK_LOOKUP_OK) {
                    break;
                }
                double d = haversine_m(curr.lat_deg, curr.lon_deg,
                                       cand.center_lat_deg,
                                       cand.center_lon_deg);
                if (d < 5000.0) {
                    candidates++;
                }
            }

            // Copy-out variant: holds track_store_mutex internally
            // while searching + copying so a concurrent track_delete
            // on the WiFi task can't move the winning entry out from
            // under us between detection and sync (codex review
            // 2026-04-22 HIGH).
            TrackDefinition detected_copy = {};
            bool have_detected = (track_auto_detect_copy(
                curr.lat_deg, curr.lon_deg, &detected_copy)
                == TRACK_LOOKUP_OK);

            if (have_detected) {
                extern TrackDefinition active_track;
                char detected_name[sizeof(session_state.track_name)] = {0};
                // Mutate active_track, bump version, and self-refresh the
                // shadow in one critical section so the current iteration
                // can process_line against the new geometry immediately.
                bool synced = false;
                if (xSemaphoreTake(s_session_mutex, portMAX_DELAY) == pdTRUE) {
                    synced = track_runtime_sync_detected_track(
                        &active_track, &detected_copy,
                        detected_name, sizeof(detected_name));
                    if (synced) {
                        lap_timer_bump_active_track_version_locked();
                        s_track_shadow = active_track;
                        shadow_version_seen = s_active_track_version;
                        strlcpy(session_state.track_name, detected_name,
                                sizeof(session_state.track_name));
                    }
                    xSemaphoreGive(s_session_mutex);
                }
                if (synced) {
                    lap_timer_reset();
                    Serial.printf("[lap_timer] Auto-detected: %s (%d candidate(s) within 5km)\n",
                                  detected_name, candidates);
                    // Also emit the structured active-track line the
                    // live_map picker parses.  Without this, a fresh
                    // laptop connect after boot auto-detect has no
                    // way to know which track the firmware already
                    // picked, and the dropdown defaults to the first
                    // entry visually but has no authoritative
                    // selection (codex review 2026-04-22 Medium).
                    Serial.printf("[track] auto-detected: %s (%s)\n",
                                  detected_copy.id, detected_name);
                }
            } else if (xSemaphoreTake(s_session_mutex, pdMS_TO_TICKS(10)) == pdTRUE) {
                strlcpy(session_state.track_name, "No Track",
                        sizeof(session_state.track_name));
                xSemaphoreGive(s_session_mutex);
                track_runtime_note_track_cleared();
                Serial.println("[lap_timer] WARN: No track within 5km — configure via phone");
            }

            auto_detected = true;
        }

        history_push(&curr);

        if (has_prev) {
            process_line(0, &s_track->start_finish, &prev, &curr);

            for (int i = 0; i < s_track->sector_count - 1; i++) {
                process_line(i + 1, &s_track->sectors[i], &prev, &curr);
            }

            // Dry-run the draft validation line (if any) against the
            // same (prev, curr) pair.  No lap / session side effects —
            // emits [xing-draft] candidate events and feeds the ring
            // buffer polled by /api/tracks/draft_validation.  Runs
            // whether or not a real track is loaded so track creation
            // from cold-start works.
            process_draft_validation_line(&prev, &curr);

            // gps_fix_bundle_from_filter_result() pre-fills match_fix with
            // raw_fix when no aligned match fix is valid, so Delta can consume
            // this field unconditionally while raw curr remains authoritative
            // for timing state and reference-lap capture.
            update_session_delta(&curr, &fix.match_fix);
        }

        if (s_lap_points != nullptr && s_lap_point_count < MAX_LAP_POINTS
            && !s_first_crossing) {
            s_lap_points[s_lap_point_count++] = curr;
        }

        // Only queue VBO entries while recording.  session_stop_recording()
        // clears is_recording before calling storage_end_session(); stopping
        // the producer here is what lets the drain path in
        // storage_end_session() actually reach an empty queue — otherwise
        // lap_timer would keep refilling the queue during the stop window
        // and the in-flight backlog would be dropped by storage_task once
        // s_session_active flips to false.
        if (session_state.is_recording) {
            forward_vbo_entry(s_vbo_queue, &curr);
        }

        prev = curr;
        has_prev = true;
        esp_task_wdt_reset();
    }
}
