icandy7272/ESP32-GPS-Lap-Timer/src/wifi/api_files.cpp

// ============================================================
// GET /files/:name — stream VBO file for download
// Also handles 404 / unknown-path routing.
// Uses SdFat via storage_get_session_path() + global sd instance.
// ============================================================

#include "wifi_internal.h"
#include "../sdfat_global.h"
#include "../storage.h"

#include <Arduino.h>
#include <WebServer.h>

static void handle_files();
static bool validate_filename(const String& name);
static void stream_file_from_sd(const char* path, const String& filename);

void handle_not_found() {
    String uri = server.uri();

    // Route: /files/filename.vbo
    if (uri.startsWith("/files/")) {
        handle_files();
        return;
    }
    server.send(404, "text/plain", "Not found");
}

static void handle_files() {
    String uri = server.uri();
    String filename = WebServer::urlDecode(uri.substring(7)); // strip "/files/"

    // Validate filename after URL-decoding so spaces and other
    // safe track-name characters continue to work for downloads.
    if (!validate_filename(filename)) {
        server.send(400, "text/plain", "Invalid filename");
        return;
    }

    char path[128];
    if (!storage_get_session_path(filename.c_str(), path, sizeof(path))) {
        server.send(404, "text/plain", "File not found");
        return;
    }

    stream_file_from_sd(path, filename);
}

static bool validate_filename(const String& name) {
    // Max session filename: YYYYMMDD_TrackName_HHMMSS_NNN.vbo
    // where TrackName can be up to 63 chars → total up to ~87 chars.
    if (name.length() == 0 || name.length() > 128) {
        return false;
    }
    for (unsigned int i = 0; i < name.length(); i++) {
        char c = name.charAt(i);
        bool ok = c >= 0x20 && c <= 0x7E &&
                  c != '"' && c != '\\' && c != '/' &&
                  c != ':' && c != '*' && c != '?' &&
                  c != '<' && c != '>' && c != '|';
        if (!ok) { return false; }
    }
    return true;
}

static void stream_file_from_sd(const char* path,
                                const String& filename) {
    if (xSemaphoreTake(spi_mutex, pdMS_TO_TICKS(2000)) != pdTRUE) {
        server.send(503, "text/plain", "SD card busy");
        return;
    }

    FsFile f;
    if (!f.open(path, O_RDONLY)) {
        xSemaphoreGive(spi_mutex);
        server.send(404, "text/plain", "File not found");
        return;
    }

    uint32_t file_size = f.fileSize();
    xSemaphoreGive(spi_mutex);

    String disposition = "attachment; filename=\"" + filename + "\"";

    server.sendHeader("Content-Disposition", disposition);
    server.setContentLength(file_size);
    server.send(200, "application/octet-stream", "");

    // Stream in chunks, releasing SPI between reads so storage_task
    // can write VBO data without queue overflows during recording.
    uint8_t buf[FILE_CHUNK_SIZE];
    while (true) {
        xSemaphoreTake(spi_mutex, portMAX_DELAY);
        int n = f.available() ? f.read(buf, sizeof(buf)) : 0;
        xSemaphoreGive(spi_mutex);

        if (n <= 0) { break; }

        String chunk;
        chunk.concat((const char*)buf, n);
        server.sendContent(chunk);
        vTaskDelay(pdMS_TO_TICKS(CHUNK_DELAY_MS));
    }

    xSemaphoreTake(spi_mutex, portMAX_DELAY);
    f.close();
    xSemaphoreGive(spi_mutex);
}
