icandy7272/ESP32-GPS-Lap-Timer/src/track_creation_feedback.h

#pragma once

#include "types.h"

enum TrackSaveResult {
    TRACK_SAVE_RESULT_SUCCESS = 0,
    TRACK_SAVE_RESULT_SUCCESS_DIR_RECREATED = 1,
    TRACK_SAVE_RESULT_INVALID_ARGUMENT = 2,
    TRACK_SAVE_RESULT_CAPACITY_REACHED = 3,
    TRACK_SAVE_RESULT_FORMAT_FAILED = 4,
    TRACK_SAVE_RESULT_DIRECTORY_CREATE_FAILED = 5,
    TRACK_SAVE_RESULT_FILE_OPEN_FAILED = 6,
    TRACK_SAVE_RESULT_FILE_WRITE_SHORT = 7,
    TRACK_SAVE_RESULT_FILE_SYNC_FAILED = 8,
    // track_store_mutex was held by another task longer than the
    // save's 3 s budget.  Caller should tell the operator to retry
    // — not bubble this up as "invalid argument".  Codex review
    // 2026-04-22 round 5 Medium.
    TRACK_SAVE_RESULT_STORE_BUSY = 9,
};

bool track_creation_save_result_succeeded(TrackSaveResult result);
const char* track_creation_save_result_message(TrackSaveResult result);

double track_creation_start_finish_separation_m(const DetectionLine* line);
bool track_creation_has_min_start_finish_separation(const DetectionLine* line, double min_distance_m);

// Minimum P1-P2 separation required before a track can be saved.
//
// Selected at compile time from WALKING_TEST_MODE so the walking-test
// profile keeps the short-line workflow (small loops near a 2-3 m debug
// line), while production requires a line long enough that 1-3 m of
// consumer-grade GPS noise at both point-marking and crossing time does
// not dominate the finish geometry.
//
// See docs/superpowers/plans/2026-04-18-finish-line-live-map-debugging.md
// for the reasoning behind the 5 m production minimum.
//
// Centralized here so the web (/api/tracks) and serial (track save) save
// paths enforce the same threshold.
double track_creation_min_save_line_length_m();
