icandy7272/ESP32-GPS-Lap-Timer/(commit log)

2026-04-02 docs: PRD v0.4 - add PPS timing, tighten precision targets
2026-04-04 feat: complete v1.0 firmware — all 10 modules compiled and reviewed
    GPS lap timer firmware for ESP32-S3 with:
    - 25Hz GPS (BK-880/u-blox M9) with PPS microsecond timestamping
    - Catmull-Rom spline interpolation for sub-sample crossing precision
    - Position-Based Delta calculation with polyline progress projection
    - VBO file export (Racelogic VBOX format) with power-loss recovery
    - ILI9341 TFT display with 3 screens (driving/status/lap list)
    - WiFi AP with web dashboard for track management and VBO download
    - FreeRTOS dual-core: Core 0 = GPS timing, Core 1 = I/O
    Reviewed by Codex (GPT-5) x2 rounds + Claude Code Review + Eng Review.
    12 bugs found and fixed across all review rounds.
    [User_Setup.h, button.cpp, button.h, config.cpp, config.h, delta.cpp, delta.h, display.cpp]
2026-04-04 feat: add track module + wire all subsystems in main.cpp
    - track.cpp: load/save/delete/auto-detect tracks from SD JSON files
    - main.cpp: full boot sequence — creates queues/mutexes, inits all 11 modules, launches 7 FreeRTOS tasks
    - wifi_server.cpp: refresh track list after web upload (Codex P2 fix)
    - Sample track JSON in data/tracks/ for testing
    Codex review: PASS (0 P0/P1, 2 P2 addressed)
    [main.cpp, storage.cpp, track.cpp, track.h, wifi_server.cpp]
2026-04-04 fix: address 6 findings from external code review
    F1: Distinguish off_track (lateral >30m) from no-reference (delta shows "---")
    F3: Propagate GPS fix_3d and satellites to SessionState every fix
    F4: Debounce now checks crossing direction — cancels if bounced back
    F5: Check storage_start_session() return value before marking recording
    F6: Handle filename collision in storage_end_session, check rename result
    F7: lap_timer_reset() clears all state + delta reference on new session
    [delta.cpp, delta.h, lap_timer.cpp, lap_timer.h, session.cpp, storage.cpp]
2026-04-04 fix: address 4 findings from second external review
    F1: Driving screen shows real elapsed time (esp_timer - lap_start_us)
    instead of synthetic best+delta
    F2: Add BOARD_HAS_PSRAM=1 to build flags, warn on ps_malloc failure
    F3: Web track POST now builds TrackDefinition and calls track_save()
    instead of writing raw unvalidated JSON
    F4: Backlight uses app_config.brightness instead of hardcoded 255
    Also added speed_kmh and current_lap_start_us to SessionState.
    [display.cpp, lap_timer.cpp, types.h, wifi_server.cpp]
2026-04-04 feat: complete all missing v1.0 functionality
    1. UBX GPS configuration: auto-detect 9600/115200, send CFG-PRT (baud),
    CFG-RATE (25Hz from config), CFG-MSG (GGA+RMC only), CFG-CFG (save)
    2. RTC sync from GPS: parse RMC date/time, settimeofday() once per boot
    3. Track auto-detect: one-time after first 3D fix via track_auto_detect()
    4. Sector timing: compute per-sector times in session.cpp handle_lap_sector()
    5. Display speed: read session_state.speed_kmh for screen auto-lock
    6. Web form: field names aligned (sf_lat1/lon1/lat2/lon2/heading)
    [display.cpp, gps.cpp, lap_timer.cpp, session.cpp, wifi_server.cpp]
2026-04-04 feat: complete mobile interaction — all phone-side gaps closed
    1. Track creation: POST handler now auto-generates id, center coords
    2. Track selection: POST /api/tracks/select + "选为当前赛道" button
    3. Track deletion: POST /api/tracks/delete + "删除" button with confirm
    4. Recording control: POST /api/recording + big toggle button in dashboard
    5. Brightness: applies immediately via ledcWrite after settings save
    6. WiFi/GPS: "重启后生效" note in UI, defaults aligned with PRD
    (SSID: KartGPS, password: kartgps123)
    Based on external mobile interaction gap analysis.
2026-04-04 feat: close all PRD-to-code gaps from product acceptance review
    1. VBO time format: raw seconds → HHMMSS.SS (Circuit Tools compatible)
    2. SSID: append MAC suffix (KartGPS-A3F2 style per PRD)
    3. Sector minimum: 5s threshold to reject GPS jitter crossings
    4. VBO [laptiming]: detection line coordinates, not lap times
    5. Boot screens: splash → GPS searching → track found → READY
    6. Auto-record: start recording on first finish-line crossing
    7. Lap elapsed: real-time mm:ss.xx in driving screen top-right
    Based on systematic PRD vs code walkthrough.
    [config.cpp, display.cpp, display.h, lap_timer.cpp, main.cpp, session.cpp, storage.cpp]
2026-04-04 fix: resolve 3 Codex findings from PRD gap review
    P1: Auto-start recording no longer calls lap_timer_reset() —
    uses storage_start_session() directly to preserve crossing state
    P1: VBO [laptiming] now uses session_track snapshot (captured at
    session start) instead of live active_track that may change
    P2: Boot GPS wait runs before lap_timer_task starts — no queue race
    [lap_timer.cpp, main.cpp, storage.cpp]
2026-04-05 feat: close all PRD-to-code gaps from product acceptance review
    PR1: session_task syncs s_phase when auto-start sets is_recording
    PR2: Track auto-detect logs candidates count, sets "No Track" on 0 match
    PR3: Web form adds sector split line inputs (up to 3 sectors)
    PR4: Block track switch during recording (409 Conflict)
    PR5: Write session metadata .json alongside .vbo on session end
    PR6: Status screen shows SD free space + WiFi SSID; lap list scrolls
    PR7: Boot screen uses GPS auto-detect result, not pre-loaded track
2026-04-06 chore: sync display fix and consolidate review docs
    [display.cpp]
2026-04-06 fix: resolve 6 Codex full-review engineering findings
    HIGH: Sector times no longer erased on lap finalize — init at lap start
    HIGH: SD.begin() called before config_load() — saved settings now load
    HIGH: WiFi download releases spi_mutex between chunks — no VBO drops
    HIGH: Active track cleared on delete — no dangling pointer
    MED: Display guards sd.vol() null before free-space query
    MED: GPS RX buffer 512 → 1024 bytes for 25Hz NMEA throughput
    [display.cpp, gps.cpp, main.cpp, session.cpp, wifi_server.cpp]
2026-04-06 feat: ship readiness — fix SR1/SR3, close PR8-PR11, add release assets
    SR1 (P0): All 3 recording paths now check storage_start_session() return
    - session.cpp: return early + rollback is_recording on SD fail
    - lap_timer.cpp: auto-start rolls back on SD fail
    - wifi_server.cpp: /api/recording returns 500 on SD fail
    SR3 (P1): ASCII-safe track name validation on POST /api/tracks
    PR8 (P1): Multi-track selection deferred to v1.1 (PRD scope reduction)
    PR9 (P2): GPS Rate removed from web settings (v1.0 fixed at 25Hz)
    PR10 (P2): Auto-switch to lap list after 10s idle, Battery: N/A, recovery screen
    PR11 (P2): Added VERSION (1.0.0-rc1), CHANGELOG.md, TODOS.md
    [display.cpp, display.h, lap_timer.cpp, main.cpp, session.cpp, storage.cpp, storage.h, wifi_server.cpp]
2026-04-08 fix(gps): use GGA fix_quality for fix detection, not satellite count
    Root cause: assemble_point() set fix_3d = (satellites >= 6), which
    rejected real navigation fixes when only 4-5 satellites were tracked.
    The BK-880's PPS LED was blinking (true 3D fix) but firmware reported
    "no GPS fix" because the satellite count gate was too strict.
    Changes:
    - gps.cpp: fix_3d now derived from GGA fix_quality whitelist
    (1=GPS, 2=DGPS, 4=RTK fixed, 5=RTK float). Rejects estimated/
    manual/simulator qualities.
    - gps.cpp: added once-per-second diagnostic log printing fix_quality,
    satellites, fix_3d, pps_synced, lat, lon for runtime visibility.
    - display.cpp: status screen "Fix: 3D/No fix" → "Fix: OK/N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
    [User_Setup.h, display.cpp, gps.cpp]
2026-04-08 feat: add device screen preview
2026-04-08 fix: tighten device status highlight and mobile frame sizing
2026-04-08 fix: address C876-1..C876-4 review findings + 2 connected issues
    C876-3 (P2): SPI_FREQUENCY double-defined — User_Setup.h's
    #define 40000000 silently overrode platformio.ini's build_flag
    -DSPI_FREQUENCY=10000000. Removed the User_Setup.h define so the
    build_flag wins. Verified compile_commands.json now contains
    -DSPI_FREQUENCY=10000000. The earlier "downgrade to 10MHz for
    breadboard signal integrity" change finally takes effect.
    C876-1 (P1): uart_init() hardcoded GPS_FIX_RATE_HZ = 25, ignoring
    app_config.gps_rate_hz. Now reads runtime config with bounds
    check (1-25, default 25 on invalid). FIX_INTERVAL_US derived
    from actual rate. Web/settings.json gps_rate_hz changes are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
    [User_Setup.h, display.cpp, gps.cpp, storage.cpp, wifi_server.cpp]
2026-04-08 fix: keep preview device panel in view
2026-04-09 fix(ui_preview): restore per-panel dark gradients
    The shared #workbench-layout > div rule used `background: var(--shell-panel)`
    which set a white semi-transparent background. Its specificity (0,1,0,1)
    beat the per-panel ID selectors (0,1,0,0), so the scenario-controls,
    web-console, and device-screen root panels all rendered with white
    backgrounds instead of their intended dark gradients.
    Result: panel titles styled for dark backgrounds (#e2e8f0) became
    white-on-white and effectively invisible.
    Fix: remove the shared background; the three root panels all define
    their own gradient backgrounds, so the fallback is unused.
2026-04-09 fix(ui_preview): prevent sector ribbon color bleed in polished TFT
    The .device-sector base and --fast/--slow modifiers all used semi-
    transparent backgrounds (alpha 0.35-0.60). When a fast (green) sector
    sat inside a slow (red) driving state, the red parent bled through
    the green modifier, blending to an olive/dark-yellow that misread as
    "not faster" — inverting the intended delta color semantics.
    Example: Sector Focus scenario — main delta is slow (red bg), but
    S1 delta is -0.05 (faster). The 60%-alpha green rendered as olive,
    not green, because 0.6 * green + 0.4 * red ≈ rgb(87, 88, 48).
    Fix: make the base and both tonal modifiers fully opaque. The sector
    ribbon color now reliably e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
2026-04-09 docs: add codex review snapshot 2026-04-08
    - CLAUDE_FIX_TASKS_2026-04-04.md: append C876-1..C876-4 review findings
    against commit 8b77376 (gps fix_quality change).
    - CLAUDE_CURRENT_ACTIONS_2026-04-08.md: minimal current-todo file
    (A1-A4) so future sessions can read a short list instead of the
    full archive.
    - CURRENT_PROJECT_REVIEW_2026-04-08.md: project review snapshot
    capturing problems that remain open against the current workspace.
    Pure docs commit — no code changes.
2026-04-09 feat(gps): add per-second fix rate and queue drop diagnostics
    Replaces the single-fix status line (printed once per second) with
    a per-second summary showing:
    - fixes/s: actual measured rate (derived from the send_fix_if_ready
    call frequency, so this reflects the real pipeline throughput, not
    the configured target)
    - drops=: number of queue overflows in the last second (old item
    discarded to make room for the new fix)
    The queue-drop tracking is lifted out of the existing overflow handler
    so the diagnostic log can count it accurately. No behavior change to
    the queue overflow policy itself.
    Rationale: seeds the data source for the Diagnostics view in the
    upcoming web preview workbench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
    [gps.cpp]
2026-04-09 docs: reconcile CLAUDE_CURRENT_ACTIONS with actual HEAD state
    The previous content of this file listed A1-A4 as open findings, but
    commit 645ae3d had already closed all four plus two connected fixes
    before this file was even committed to the repo. Reading the stale
    list on a fresh session would lead to redundant re-work and confusion.
    Rewrite the file so it accurately describes the current state:
    - A1/A2/A3/A4 and both connected issues explicitly marked closed with
    file-and-line evidence and a pointer to the fix commit (645ae3d).
    - A4 noted as "code complete, awaiting end-to-end verification on real
    hardware" — that part of the finding is genuinely still pending.
    - Add R1: src/gps.cpp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
2026-04-09 Refactor core modules and harden track session flows
2026-04-09 Clarify BK-880 wiring and power guidance
2026-04-09 docs: archive module split plan that drove R1-R4 refactor
    This is the planning document Codex generated before the
    codex/refactor-core-modules-r1-r4 branch was implemented.
    It enumerates the four target modules (gps / lap_timer /
    storage / track), the per-task extraction strategy, and
    the testability goals (track_runtime, storage_naming as
    host-testable pure helpers).
    Committing it as historical record so a future session
    can understand why the src/{gps,lap_timer,storage,track}/
    subdirectories were created and why two new top-level
    files (storage_naming, track_runtime) live alongside
    the new subdirs instead of inside them.
2026-04-09 fix(ui_preview): replace hard split body gradient with continuous dark
    The body --preview-background gradient had a hard color stop at
    38% from #132238 (dark navy) to #eef4ff (near-white), which made
    the bottom half of the workbench page render with a white background.
    This was a vestige of an earlier design where panels were intended
    to be light cards on a light area below the dark hero region.
    After the per-panel gradient fix landed in c770190, all three root
    panels (scenario-controls, web-console, device-screen) carry their
    own dark gradients. The body background is now visible only in the
    gutter area to the right of the shorter device-screen column on
    wide viewports — and that gutter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
2026-04-09 chore: ignore .superpowers, compile_commands.json, test_backups/
    These are local tooling artifacts that show up in every git
    status but should never be committed:
    - .superpowers/ — Codex/superpowers session state
    - compile_commands.json — clangd index, regenerated by build
    - test_backups/ — local backup directory
    Removing them from the working set so future git status output
    stays focused on real changes.
2026-04-09 test: add host test runner script for portable helpers
    Adds tools/run_host_tests.sh which iterates tests_host/test_*.cpp,
    pairs each with its sibling src/<name>.cpp, compiles standalone
    with c++ -std=c++17 -I src, runs the binary, and reports
    pass/fail with a non-zero exit on failure.
    Before this script, the host tests under tests_host/ existed but
    were unreachable: the project's only PlatformIO env is for the
    ESP32-S3 firmware, and pio test was not wired up. The only way
    to run them was a manual c++ command per test, which meant they
    would silently rot if track_runtime or storage_naming changed.
    Verified locally:
    ==> test_storage_naming PASS
    ==> test_track_runtime PASS
    Result: 2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
2026-04-11 fix: unify SD filesystem on SdFat, fix wifi stack overflow and crash diagnostics
    Remove Arduino SD library entirely — all filesystem access now uses SdFat
    through a single global instance. This eliminates the dual-mount FAT32
    driver conflict that caused track_save() to fail with "save failed".
    Key changes:
    - Create sdfat_global.h to consolidate extern SdFat declarations
    - Remove all SD.begin() calls (main.cpp, wifi_server.cpp)
    - Migrate config.cpp, api_tracks, api_sessions, api_files to SdFat
    - api_tracks GET now reads from in-memory array (zero SD access)
    - Fix wifi task stack overflow: eliminate all SessionState by-value
    copies on wifi stack (~4KB each), increase stack 8KB -> 12KB
    - A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
    [api_files.cpp, api_recording.cpp, api_sessions.cpp, api_status.cpp, api_tracks.cpp, button.cpp, button.h, button_profile.cpp]
2026-04-12 feat: scaffold mobile track creation layout
2026-04-12 fix: remove stale manual add-track js paths
    [web_ui.cpp]
2026-04-12 feat: add mobile track creation flow
2026-04-12 fix: harden mobile track creation flow
    [web_ui.cpp]
2026-04-12 feat: add gps stability gate for track creation
    [web_ui.cpp]
2026-04-12 feat: clarify current track and recording state
2026-04-12 feat: add nearby track disambiguation
2026-04-12 feat: guide mobile track creation review flow
2026-04-13 fix: correct SVG map projection and improve track save diagnostics
    SVG review map now applies cos(lat) correction and uniform scaling
    to preserve geographic aspect ratio, so finish line orientation
    displays accurately instead of always appearing diagonal.
    Track save adds directory existence check with auto-recreate,
    write return value verification, and richer error logging to
    help diagnose SD card failures.
    [track_store.cpp, web_ui.cpp]
2026-04-13 feat: add early boot probe breadcrumbs via RTC memory
    Track boot progress through RTC_NOINIT_ATTR so the previous
    attempt's last-reached phase survives a warm reset. Helps
    diagnose boot loops without needing serial capture.
    [boot_sequence.cpp, boot_sequence.h, main.cpp, test_boot_sequence.cpp]
2026-04-13 fix: correct TFT colour rendering on BGR-mode ILI9341
    Add bgr565() helper to swap R/B channels for TFT_eSPI colour
    constants which are always RGB565 but the panel interprets as
    BGR. Apply to delta background, boot accent, and lap status
    colours. Change neutral backgrounds from dark grey to black
    for higher contrast on the driving screen.
    [display_boot.cpp, display_format.cpp, display_internal.h]
2026-04-13 fix: delta start/finish ambiguity guard and crossing debug logs
    Reject polyline projections with progress > 75% in the first 5s
    of a lap to prevent huge negative delta from matching the end of
    the reference lap at the shared start/finish location.
    Add [xing] and [lap] serial debug logs for arm state, crossing
    detection, heading rejection, and lap time validation.
    Temporarily reduce ARM_DISTANCE_M to 10m for walk testing.
    [delta.cpp, lap_timer_crossing.cpp, lap_timer_events.cpp, lap_timer_internal.h]
2026-04-13 chore: add test track definition for field testing
2026-04-13 feat: harden gps confidence track creation
2026-04-13 fix: harden cold-start boot and add SD boot/crash logging
    - Increase power-on stabilization delay (120→500 ms) and TFT reset
    timing (120→150 ms) to fix white-screen on cold start
    - Remove broken TFT SPI probe retry that always returned 0xFF on
    modules without display MISO, saving ~2.5s boot time
    - Fix display_task boot-to-runtime handoff: preserve pending
    full_redraw when Phase 1 SPI mutex times out, and defer
    first_frame=false until after successful render
    - Add boot_log module that buffers lines before SD is ready, then
    writes directly to boot_log.txt for crash-resilient diagnostics
    - Add BROWNOUT to crash detection (was only catching PANIC/WDT)
    - Lower SD card SPI from 25 MH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
    [boot_log.cpp, boot_log.h, boot_sequence.cpp, display.cpp, main.cpp, storage_internal.h]
2026-04-14 refactor: tighten web ui split boundaries
    [web_ui.cpp, web_ui_script_core.cpp, web_ui_script_track_creation.cpp]
2026-04-14 fix: harden boot logging and cold-start diagnostics
    [boot_log.cpp, boot_log_buffer.cpp, boot_log_buffer.h, boot_log_policy.cpp, boot_log_policy.h, boot_sequence.cpp, boot_sequence.h, main.cpp]
2026-04-14 docs: capture wiring and perfboard build guidance
2026-04-15 feat: driving three-state display, walking test thresholds, track debug
    - Driving screen now has three states: READY (idle), OUT LAP (recording
    pre-first-crossing), and normal lap display. READY shows big satellite
    count plus current track name; OUT LAP shows current speed. Dirty-flag
    computation is state-aware so delta doesn't repaint on lap increments
    (stale delta flash) and idle doesn't repaint on speed jitter.
    - Walking-test thresholds: HEADING_WINDOW 180°, ARM_DISTANCE_M 3 m,
    MIN_LAP_TIME_MS 5000 ms. Marked as TEST values to revert before
    shipping (see memory/project_pcb_migration.md).
    - New MIN_CROSSING_SPEED_KMH = 1.0 gate rejects stationary GPS drift
    so the line does n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
    [display.cpp, display_driving.cpp, display_internal.h, lap_timer_crossing.cpp, lap_timer_internal.h, main.cpp]
2026-04-16 fix: address codex review — sync lap threshold, clear idle timer, wiring diagram
    - Align session.cpp LAP_SHORT_THRESHOLD_MS with lap_timer's MIN_LAP_TIME_MS
    (both now 5000 ms for walking tests). Previously the delta engine treated
    5-15 s laps as valid and seeded a reference, while session.cpp still
    classified them as LAP_STATUS_SHORT and refused to update best_lap_time_ms.
    That produced a split-brain: live delta shown, Best permanently "--:--.--".
    - session_stop_recording() now clears session_state.current_lap_start_us
    and calls lap_timer_reset(). Without this, the delta engine's last-written
    timestamp kept being echoed into session state after stop, so the new
    READY idle scr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
    [session.cpp]
2026-04-16 refactor: gate walking-test thresholds behind WALKING_TEST_MODE flag
    Addresses codex review findings #1, #2, #5.
    #5 — Compile-time gating for test thresholds
    Walking-test constants are now conditional on WALKING_TEST_MODE.
    Enabling the flag in platformio.ini swaps HEADING_WINDOW, ARM_DISTANCE_M,
    MIN_LAP_TIME_MS (lap_timer), and LAP_SHORT_THRESHOLD_MS (session) to
    relaxed values as one atomic switch — no more hand-editing multiple
    constants or risking lap_timer/session going out of sync. Commenting
    the -DWALKING_TEST_MODE=1 line restores production values.
    MIN_CROSSING_SPEED_KMH stays on both paths (it filters stationary GPS
    drift and is harmless in production).
    #1 — P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
    [lap_timer_internal.h, session.cpp]
2026-04-16 build: isolate walking-test firmware into its own opt-in env
    Addresses the remaining P1 from 2026-04-16 codex review: the default
    platformio env still shipped WALKING_TEST_MODE=1, so any plain
    `pio run` produced walking-test firmware with direction filtering
    effectively disabled and MIN_LAP_TIME_MS relaxed to 5 s.
    - Split platformio.ini into two envs. `esp32-s3-devkitc-1` is
    PRODUCTION and defines no walking-test flag. A new
    `esp32-s3-devkitc-1-walking-test` env extends it and adds
    -DWALKING_TEST_MODE=1.
    - Add `default_envs = esp32-s3-devkitc-1` so `pio run` without
    -e only builds production. Walking-test firmware now requires
    explicit `pio run -e esp32-s3-devkitc-1-walki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
2026-04-16 docs: remove PPS as a v1 design feature — BK-880 does not provide it
    Addresses 2026-04-16 codex review findings #1 (PPS story still mixed) and
    #2 (TEST_MODES checklist overstated current repo state).
    #1 — PPS
    BK-880 datasheet §2.1.3 explicitly states "1PPS 信号接口：无" and the
    module exposes no fly-wire test pad for PPS either. Prior docs carried
    a partial "v1.1 optional fly-wire" story, which was speculative. All
    PRD and ARCHITECTURE references now state plainly: BK-880 has no PPS,
    timing is UART-arrival-time only. Updates:
    - PRD.md hardware block, crossing algorithm, task table, changelog v0.5
    - ARCHITECTURE.md module structure, gps.cpp description, data-flow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
2026-04-17 docs,chore: finish PPS removal — wiring/perfboard docs + source comments
    Addresses the remaining inconsistency from the 2026-04-16 codex refresh:
    PRD/ARCHITECTURE had been updated to say BK-880 exposes no PPS at all,
    but WIRING.md / pcb-guide.md / source comments were still describing a
    "fly-wire to PPS test pad" path. All four sources now tell the same
    story: BK-880 has no PPS output, no usable test pad, GPIO16 has no
    external connection.
    docs/WIRING.md:
    - GPS section intro: drop the "LED + test pad available" sentence;
    state plainly that nothing is exposed and project uses UART time
    - Footnote: drop the PPS fly-wire instruction; note that PIN_GPS_PPS
    is retained in code for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
2026-04-17 fix: two regressions flagged by codex — stop-then-crossing + debounce under speed gate
    [P1] Manual stop followed by a crossing silently re-armed recording.
    session_stop_recording() called lap_timer_reset(), which set
    s_first_crossing back to true. The next start/finish crossing then
    hit handle_finish_crossing()'s first-crossing branch and auto-invoked
    storage_start_session(), bypassing the user's explicit stop.
    Fix: drop the lap_timer_reset() call and instead guard the crossing
    handler itself. handle_finish_crossing() now short-circuits with a
    "[lap] crossing ignored (recording stopped)" log whenever is_recording
    is false and s_first_crossing is already false — i.e. we are in the
    post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
    [lap_timer_crossing.cpp, lap_timer_events.cpp, session.cpp]
2026-04-17 fix: close out-lap abort and idle-timer regressions flagged by codex
    Follow-up to 89a1f83. The previous guard used s_first_crossing as the
    stopped-state discriminator, which is wrong: s_first_crossing stays
    true until a crossing actually happens, so pressing stop DURING the
    out lap left the crossing handler still happy to auto-start a new
    session on the next line crossing. It also left update_session_delta()
    writing s_lap_start_us back into session state on every GPS fix, so
    the READY screen's elapsed timer ticked back up within 40 ms of the
    stop.
    Two minimal fixes:
    1. Add `session_stopped` to SessionState. Cleared in
    session_start_recording(), set in session_stop_recording().
    han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
    [lap_timer_delta.cpp, lap_timer_events.cpp, session.cpp, types.h]
2026-04-17 fix: neutral idle-screen background + preserve stop suppression on SD failure
    Follow-up to be3ef1d, addressing the two new regressions codex flagged:
    [P2] The new READY / OUT LAP screens kept showing the delta-driven red
    /green/yellow background of the last recorded lap, because
    delta_background_colour() looks at delta_ms/delta_valid/off_track
    and those fields stay populated after a session ends. Added a
    driving_bg_colour() wrapper in display_driving.cpp that returns a
    neutral TFT_BLACK for IDLE and OUT_LAP, and only defers to the
    delta colour in NORMAL. All four driving-screen draw functions now
    use it. compute_dirty() also gets a state-transition term on
    d.background so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
    [display.cpp, display_driving.cpp, session.cpp]
2026-04-17 fix: stop driving_bg_colour from recursing into itself
    Sloppy replace_all in 44a46e2 rewrote the delta_background_colour(st)
    call *inside* the new driving_bg_colour() helper to driving_bg_colour(st),
    so the NORMAL-state fallback was a bare self-call. On any frame where
    the driving screen rendered in DRIVING_NORMAL, the helper would recurse
    forever until the FreeRTOS task overflowed its stack — a hard crash on
    the first real lap.
    Caught by codex during the next review pass (before the OpenAI-side
    stream reconnect loop killed it). Good catch, bad bug.
    Restore the delta_background_colour(st) call on the NORMAL branch so
    the helper has a base case. All external callers still use
    driving_b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
    [display_driving.cpp]
2026-04-17 docs: archive 2026-04-17 codex review memo
    Last codex review pass against this branch. Note: this memo's
    findings were stale — they describe the state BEFORE commit 85c5c5f
    (PPS removal in WIRING.md / pcb-guide.md / source comments), so
    every P1 it lists was already resolved on this branch when the
    memo was generated. Archived for session history only.
2026-04-17 fix: close two concurrency holes flagged in 2026-04-17 code review
    Two HIGH-severity findings from docs/CODE_REVIEW_2026-04-17_main.md:
    1. session.cpp handle_lap_finish() captured &session_state.laps[idx] under
    the mutex, released the mutex, then passed that pointer to
    storage_write_lap_timing(). The call is intentionally outside the lock
    because SD I/O may block, but the pointer still aims into shared state.
    Safe today only because storage_write_lap_timing() is a stub; the moment
    it becomes a real writer, any concurrent update to session_state.laps
    (best-lap bookkeeping, next-lap sector init) would race the write.
    Copy the record into a local LapRecord under the mutex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
    [lap_timer_events.cpp, session.cpp]
2026-04-17 fix: stop losing tail GPS data when a session ends
    Codex flagged this in docs/CODEX_REVIEW_2026-04-17_main.md as [P1] #3.
    The bug: storage_end_session() set s_session_active = false before doing
    any tail work. storage_task reads that flag on every iteration and does
    `continue` past any queued VBO entries once it sees false, so any backlog
    that was enqueued before the stop but not yet consumed was silently
    dropped. The window is small in the common case (1-3 entries during a
    flush_and_sync spike), but grows to seconds of driving data whenever SD
    was slow.
    Two-part fix. Neither part alone works:
    1) lap_timer_task.cpp now gates forward_vbo_entry() on
    session_state.is_recording. sessio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
    [lap_timer_task.cpp, storage_session.cpp]
2026-04-17 docs: capture 2026-04-17 main review memos (cpp-reviewer + codex)
    Two independent review passes against main at b5dcc8e:
    - CODE_REVIEW_2026-04-17_main.md — from the cpp-reviewer agent. Verdict
    WARNING. Flagged the session.cpp dangling-pointer, the lap_timer
    lock-free flag read, and (incorrectly) the Catmull-Rom spline.
    - CODEX_REVIEW_2026-04-17_main.md — from the OpenAI Codex pass. Same
    Catmull-Rom finding as the cpp-reviewer (also incorrect — see the
    subsequent fix commit's body for the numerical rebuttal). Added the
    real [P1] stop-path drain finding plus four P2s on the Web API
    surface (track-create validation, settings JSON escaping,
    /api/sessions metadata not wir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
2026-04-17 feat: inject FW_VERSION at build time from VERSION file + git SHA
    src/display/display.cpp had `const char* FW_VERSION = "v1.0.0"` wired
    directly in source, so every firmware update silently kept the same
    version string on the status screen regardless of what shipped.
    Add tools/inject_version.py as a PlatformIO pre-script that reads the
    top-level VERSION file, appends the current git short SHA, and marks
    dirty working trees with a `-dirty` suffix. The script exposes the
    result as FW_VERSION_STR via CPPDEFINES. display.cpp now consumes that
    macro with a fallback for direct compiler runs where the script is not
    active (e.g. tools/run_host_tests.sh).
    Typical output on the status screen: v1.0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
    [display.cpp, inject_version.py]
2026-04-17 fix: harden JSON API input validation and document VBO sign convention
    Three unrelated-but-adjacent hygiene items called out in the 2026-04-17
    review pass.
    1. /api/settings now validates wifi_ssid and wifi_pass before committing
    to app_config. settings.json is formatted and parsed by a hand-rolled
    helper that treats `"` as a terminator and does not honour backslash
    escapes, so a POST payload with either character would either
    truncate the field at load time or emit non-JSON bytes on save.
    is_safe_wifi_string() restricts both to printable ASCII without `"`
    or `\`, and apply_settings_from_json() now validates all fields
    before applying any of them and returns a descripti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
    [api_settings.cpp, api_tracks.cpp, storage_vbo.cpp]
2026-04-17 fix: serialize active_track access via lap_timer shadow copy + version
    active_track is a ~120-byte global TrackDefinition read by lap_timer_task
    on Core 0 (s_track->start_finish / sectors[i] dereferenced on every
    process_line call, 25 Hz in normal operation) and written by the WiFi
    task on Core 1 (api_tracks delete memset, api_tracks select via
    lap_timer_set_track, boot auto-detect in lap_timer_task itself, and the
    main.cpp boot path). A 120-byte memset is not atomic across the two
    Xtensa cores, and lap_timer_task doing process_line mid-mutation can
    read a torn detection line and emit a spurious crossing.
    Introduce a shadow-copy + version-counter pattern:
    - lap_timer_internal::s_track_sha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
    [api_tracks.cpp, lap_timer.cpp, lap_timer.h, lap_timer_internal.h, lap_timer_task.cpp]
2026-04-17 fix: wire /api/sessions metadata read and fix total_time_s source
    Two adjacent bugs in the historical-session metadata pipeline.
    1. GET /api/sessions used to hardcode best_lap_ms:-1 on every returned
    session (src/wifi/api_sessions.cpp:123 pre-fix). write_session_metadata_json()
    has been emitting a sibling `.json` with the real best since the VBO
    format landed, but nothing read it. Dashboard's "Best Lap" column
    therefore rendered `--` for every historical session.
    Add read_best_lap_ms_from_meta(): for each `.vbo` filename in the
    sessions/ listing, derive the sibling `.json` path, read it, and
    parse the "best_lap_ms" field with the same hand-rolled key matcher
    used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
    [api_sessions.cpp, storage_vbo.cpp]
2026-04-17 fix: write per-lap records into VBO [laptiming] section
    storage_write_lap_timing() was a stub that session.cpp called after
    every lap finish, and write_laptiming_lines() at session end only
    emitted the start/finish + sector geometry — no actual lap records
    landed on disk. Dashboard/analysis tools had to recompute laps from
    the raw GPS stream.
    Extend write_laptiming_lines() to iterate session_state.laps[] and
    append one `Lap N lap_time_ms=... status=... sectors=...` line per
    completed lap after the geometry rows. RaceLogic VBO's [laptiming]
    section accepts free-form lines, so Circuit Tools still consumes the
    geometry as before but other tools (and human readers) now get the
    explicit per-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
    [storage_session.cpp, storage_vbo.cpp]
2026-04-17 test: extract crossing decision truth table as host-testable unit
    The cluster of regressions fixed on 2026-04-17 (89a1f83 stop-then-
    crossing, be3ef1d out-lap abort + idle-timer echo, aa80a73 lock-free
    session flag read) all lived in the same set of conditions at the top
    of handle_finish_crossing(). Every time a fix landed, the handler
    gained another special case in the if/else ladder. With no host-level
    test coverage for that decision, the only way to catch the next
    regression was for codex to find it.
    Lift the decision into src/lap_timer_guard.{h,cpp} as classify_crossing
    — a three-argument pure function returning one of
    {Reject, AutoStartSession, StartLapTimer, CompleteLap}. handle_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
    [lap_timer_events.cpp, lap_timer_guard.cpp, lap_timer_guard.h, test_lap_timer_guard.cpp]
2026-04-18 fix: require segment-segment intersection for line crossings
    2026-04-18 walking test produced a textbook false-positive lap:
    Lap 1: 10.607s NO_REF
    Lap 2: 63.632s SLOW ← real walking lap
    Lap 3: 4.745s SHORT ← impossible on foot
    At ~4 km/h walking pace, a 4.7s "lap" is ~5 m of movement — the user
    could not have walked a real circuit that fast. Root cause:
    has_crossed_line() only tested for a sign flip on side_of_line(),
    which is mathematically equivalent to crossing the INFINITE line that
    passes through the start/finish segment's endpoints. Walking
    anywhere along that infinite extension — however far from the actual
    segment — counted as a crossing.
    Replace the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
    [lap_timer_crossing.cpp, line_geometry.cpp, line_geometry.h, test_line_geometry.cpp]
2026-04-18 fix: display speed dead-zone + bump walking-test min lap to 8s
    Follow-ups to the 2026-04-18 walk:
    B. src/display/display_driving.cpp
    draw_delta_out_lap() previously rounded st.speed_kmh straight to
    the screen, so a stationary device rendered "1 km/h" whenever the
    u-blox M9N's natural 0.2–1.0 km/h position drift rounded up.
    User saw this while sitting at the start line waiting to walk.
    Gate the displayed number on DISPLAY_MIN_SPEED_KMH = 1.0 — the same
    threshold MIN_CROSSING_SPEED_KMH the lap timer uses to reject
    stationary drift from arming the line. Raw speed still goes into
    the VBO [data] stream for post-analysis; the change is display-only.
    C. src/lap_time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
    [display_driving.cpp, lap_timer_internal.h, session.cpp]
2026-04-18 fix: WALKING_TEST heading window 180°→60°, arm distance 3m→6m
    Second-round fix for the 2026-04-18 walk-test false laps. The first
    round (f575b0b segment intersection + 4c8c687 8s min lap) addressed
    the geometry and the sub-lap noise, but the walker still saw "½ lap
    per lap" behaviour in a loop that enclosed the start/finish segment.
    Root cause: WALKING_TEST_MODE set HEADING_WINDOW to 180° on the
    (conservative) assumption that walker heading was too noisy to gate
    on. Replay analysis of the 2026-04-18 20260418_test_035407_001.vbo
    session showed the u-blox M9N actually reports heading to ±15° at
    walking pace — good enough to tell the "forward" crossing (~245°
    valid) from the "re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
    [lap_timer_internal.h]
2026-04-18 fix: add axial end tolerance to segment-segment crossing (T10)
    The 2026-04-18 walk produced a session with 0 laps where the user
    physically crossed the start/finish line. Replay confirmed that, in
    GPS-recorded coordinates, the closest approach to the P2 endpoint was
    0.22 m and the walker never entered the strict P1-P2 segment — yet the
    physical line was crossed. Root cause is the accumulated absolute GPS
    error from two independent samples: the track-creation point-marking
    GPS reading and the walk-time GPS reading each carry 1-3 m of noise on
    consumer u-blox hardware, so a real crossing can land 1-2 m off in the
    recorded data. Strict segments_intersect rejects these; they are not
    infinit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
    [lap_timer_crossing.cpp, lap_timer_internal.h, line_geometry.cpp, line_geometry.h, test_line_geometry.cpp]
2026-04-18 feat: delta-projection continuity bias (T6)
    The roadmap identifies jumpy delta matching as one of the UI-quality
    irritations to address: near-return or crossover geometry lets the
    minimum-lateral-distance matcher flick between two plausible segments
    whose geometric scores are nearly tied. Each flick is a visible delta
    "jump" even though the runner is moving smoothly.
    Mitigation:
    - src/delta_continuity.{h,cpp} — pure helper (no Arduino, no FreeRTOS)
    with three entry points:
    * classify_step() — Normal / Wrap / Suspicious taxonomy for future
    diagnostic use
    * folded_progress_delta() — shortest-way progress change that folds
    lap wrap into a small positive number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
    [delta.cpp, delta_continuity.cpp, delta_continuity.h, test_delta_continuity.cpp]
2026-04-18 task5: reject implausible gps fixes
    [gps_filter.cpp, gps_fix.cpp, test_gps_filter.cpp]
2026-04-18 fix: address codex P2 findings on T10 + T6
    Codex review of f00a4c4 + 1cfe350 flagged two real regressions that
    would bite on already-supported inputs:
    1. [delta] s_last_progress was advanced inside project_to_polyline()
    BEFORE delta_calculate() had decided whether the sample was
    on-track. When a runner went off the circuit and later rejoined
    near a different point of the lap, the off-track projection became
    the new continuity anchor — so the correct re-entry segment took a
    tens-of-metres penalty against whatever stale nearby branch the
    off-track samples had last matched. Recovery after any off-track
    excursion would be visibly worse than before the T6 bias landed.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
    [delta.cpp, lap_timer_crossing.cpp, test_line_geometry.cpp]
2026-04-18 chore: move gps_filter to top-level src/ so host tests pick it up
    tools/run_host_tests.sh pairs test_X.cpp with src/X.cpp at the top
    of src/, not inside subdirectories. Codex's Task 3 put the filter
    at src/gps/gps_filter.{h,cpp} which caused tests_host/test_gps_filter.cpp
    to be silently skipped ("target src/gps_filter.cpp not found").
    Relocate to src/gps_filter.{h,cpp} matching the convention used by
    src/delta.cpp, src/lap_timer.cpp, and src/line_geometry.cpp — pure
    modules that both firmware AND host tests can link against. Update
    the three includers to drop the gps/ prefix. No behaviour change.
    Host tests go 14 → 15 (test_gps_filter now runs).
    Both firmware envs still build green.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
    [display.cpp, gps_filter.cpp, gps_filter.h, gps_fix.cpp, test_gps_filter.cpp]
2026-04-18 feat: show speed to one decimal place on the out-lap screen
    Integer km/h felt stuck between whole-number ticks at walking pace
    (0–5 km/h) even though new GPS fixes were landing every 40 ms.
    display_driving.cpp:draw_delta_out_lap now formats as %.1f, and the
    dirty-detect in display.cpp:compute_dirty now compares at the tenths
    place so the visible digit can't lag the underlying fix stream.
    DISPLAY_MIN_SPEED_KMH (= 1.0) still collapses sub-threshold noise to
    0.0 so a stationary device renders a calm "0.0 km/h" instead of
    "0.2 → 0.5 → 0.1" flicker (u-blox M9N stationary drift is in that
    range). Font 7 renders '.' just like format_lap_time already relies
    on, so no font change needed.
    Ver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
    [display.cpp, display_driving.cpp]
2026-04-18 feat: enable Repeatability Check button in track creation UI
    Flag was off (REPEATABILITY_CHECK_ENABLED=false) since the feature
    landed in e694845. Re-enable for the 2026-04-18 walking-test round:
    the two-pass verification (mark P1/P2, then re-mark, compare
    midpoint distance and heading delta against length-aware thresholds)
    catches "the GPS felt stable but actually the pair you just marked
    would disagree with itself by 2 m" before the track is saved. That
    failure mode is exactly what produced the 10 m lines that then
    needed the 2 m axial tolerance rescue.
    Thresholds (unchanged, from web_ui_script_core.cpp:repeatabilityThresholds):
    - Line < 8 m: midpoint ≤ 1.5 m AND heading ≤ 12°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
    [web_ui_script_core.cpp]
2026-04-18 fix: send no-cache headers on dashboard HTML
    Mobile browsers were happily caching the entire dashboard page across
    firmware updates because handle_root() sent no Cache-Control header.
    That hid the Repeatability Check button for a user who had the
    dashboard already open when the REPEATABILITY_CHECK_ENABLED flag
    flipped from false to true (7864411): the browser kept serving the
    pre-flip JS from its cache, so the button's display rule still
    evaluated to "hidden" even after reflash.
    Add the standard anti-cache trio — Cache-Control no-cache/no-store/
    must-revalidate + Pragma no-cache + Expires 0 — to every response
    from handle_root(). Covers Safari, Chrome (desktop/mobile), Firefox,
    and emb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
    [web_ui.cpp]
2026-04-18 feat(tools): add live_map.py — laptop-side realtime GPS + line viewer
    Single-file Python 3 tool, stdlib + pyserial only. Reads the
    firmware's existing [gps] 1 Hz diagnostic line for current position,
    [track] boot-log lines for the active detection segment, and lap /
    session events; serves a self-contained canvas-based live map at
    http://127.0.0.1:8080.
    Draws:
    - Red solid segment: actual P1-P2 detection line, length labelled
    - Yellow dashed: axial extension matching walking-test
    CROSSING_END_TOLERANCE_M (2 m each end, clamped at 1x line length
    inside the firmware). Shows the *effective* hit zone.
    - Green arrow from midpoint: valid_heading direction
    - Blue polyline: recent GPS trail (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
2026-04-18 feat(tools): live_map.py on real map tiles + on-demand track query
    Two upgrades to the walk-test live viewer:
    1. Switch from hand-drawn canvas to Leaflet with OSM street + Esri
    World Imagery satellite tiles (layer switcher top-right). Yellow
    dashed axial-tolerance zone overlays the red P1-P2 segment so the
    effective hit zone matches what the firmware actually sees.
    Green arrow from the midpoint shows valid_heading. Laptop must
    be on an internet-reachable network (phone hotspot works) to
    fetch the tiles; serial data + UI state still flow entirely over
    localhost.
    2. Bootstrap thread sends `ls tracks` + `cat tracks/<first>.json`
    over the existing serial console on st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
    [live_map.py]
2026-04-18 feat: mark track start/finish over USB serial + live_map UI
    Track creation previously required the walker to switch their phone
    onto the ESP32 AP and use the web dashboard, which meant choosing
    between the satellite-map view tools/live_map.py provides (needs the
    phone-hotspot internet) and actually marking points (needs the AP).
    That split has been the main friction in the walking-test loop.
    Firmware — new serial console commands:
    track draft <name> start a new on-device draft
    mark p1 sample session_state GPS for 2 s, take per-axis
    median of 3D-fix samples, set as P1
    mark p2 same as P1, plus compute valid_heading as the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
    [live_map.py, main.cpp, serial_console.cpp, serial_console.h, test_serial_console.cpp]
2026-04-18 feat: live finish-line debugging instrumentation (2026-04-18 roadmap)
    Implements the high-leverage items from
    docs/superpowers/plans/2026-04-18-finish-line-live-map-debugging.md
    so walking-tests can answer "did I cross the finite segment or only the
    extension, and if not why was it rejected?" without reading logs.
    Firmware:
    - line_geometry::project_to_line() projects a point into (u, signed_d)
    along an arbitrary C-D line. Pure, host-testable math.
    - lap_timer emits one structured "[xing] L<i> candidate u=... overshoot=...
    hdiff=... result=PASS|REJECT reason=..." per side-flip — not just on
    accepted crossings. Reason codes: segment, extension, heading_mismatch,
    outside_endpoint_t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
    [api_tracks.cpp, lap_timer_crossing.cpp, line_geometry.cpp, line_geometry.h, live_map.py, main.cpp, test_line_geometry.cpp, track_creation_feedback.cpp]
2026-04-19 fix: address 2026-04-19 codex review findings (2 P1 + 5 P2)
    Follow-up to 8acf4f2 (Merge live-finish-line-debugging) — codex's
    independent review flagged seven issues across firmware, tools, and
    docs. All of them are real. Fixed in a single pass because each one
    is a minute-scale patch and the cost of a second merge is not worth
    trickling them out.
    P1 — live_map reader thread killed by one malformed serial line
    tools/live_map.py:126-165
    Regexes like `[0-9.\-]+` accepted garbage such as `..` or `1..2`; the
    subsequent `float()` raised ValueError and the serial_reader thread
    died, silently freezing the live map on its last frame. Tightened
    every numeric capture to `-?\d+(?:\.\d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
    [lap_timer_crossing.cpp, live_map.py, main.cpp, test_line_geometry.cpp, test_live_map_parse.py, web_ui_script_core.cpp]
2026-04-19 fix: address 2026-04-19 codex follow-up review (2 P1 + 2 P2)
    Follow-up review on top of 83741f6 caught four more issues across the
    serial-draft workflow on main and the GPS filter merged earlier as
    Track B. All real; fixed in one pass.
    [P1] Serial save doesn't sync selected-track runtime state
    src/main.cpp:557-585
    After `track save` the serial path called `lap_timer_set_track(saved)`
    but did not mirror what /api/tracks/select does: update
    session_state.track_name under session_mutex + call
    track_runtime_note_manual_selection(newly_created=true). Result was
    a split state where the lap timer saw the new track but the rest of
    the runtime still thought nothing was selected — /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
    [gps_filter.cpp, gps_filter.h, main.cpp, test_gps_filter.cpp]
2026-04-19 feat: Phase A — draft validation line + live_map dry-run candidates
    Phase A of the 2026-04-18 finish-line debugging roadmap. Adds a
    "dry-run" crossing evaluator the operator can use during track
    creation to verify a line actually triggers crossings BEFORE saving,
    instead of hitting Save and hoping.
    Firmware
    - src/lap_timer/lap_timer_draft_validation.cpp (new)
    Holds a DetectionLine behind a portMUX critical section + a ring
    buffer of the last 16 candidate events + accepted/rejected counters.
    lap_timer_task now calls process_draft_validation_line() every GPS
    sample, which runs the same segment-intersect + heading gate used
    against the active track but:
    * touches no arm / debo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
2026-04-19 feat: Phase B — /api/tracks/draft_validation + phone Validate step
    Closes the phone-only loop from the 2026-04-18 finish-line debugging
    roadmap. On the kart track, operators only have their phone; the
    laptop-driven live_map work (Phase A, 03461ae) will not be there.
    This adds the same draft-validation capability to the phone web UI
    through three new HTTP endpoints plus a Validate step in the track
    creation flow.
    Firmware HTTP endpoints (src/wifi/api_tracks.cpp)
    POST /api/tracks/draft_validation
    Body: {"sf_lat1":...,"sf_lon1":...,"sf_lat2":...,"sf_lon2":...,"sf_heading":...}
    Installs a draft detection line in the lap_timer. Resets the
    counters and ring buffer every call —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
    [api_tracks.cpp, web_ui_markup.cpp, web_ui_script_core.cpp, web_ui_script_track_creation.cpp, wifi_internal.h, wifi_server.cpp]
2026-04-19 fix: address 2026-04-19 codex follow-up on draft-validation (5 P1 + 3 P2)
    Codex review of the Phase A + B draft-validation work (8acf4f2) found
    eight real concurrency / state-machine / bypass issues. All eight are
    addressed in a single pass because they share a root cause: the
    firmware-side draft state was a bare singleton with no session
    identity, and the JS + backend gates trusted each other instead of
    cross-checking.
    Firmware (src/lap_timer/lap_timer_draft_validation.cpp, lap_timer.h)
    - Added `s_session_id` (monotonic, bumped on every set/clear) and
    `s_owner` (SERIAL / WEB / NONE) to the state struct.
    - New atomic snapshot: lap_timer_get_draft_validation_snapshot()
    reads active + se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
    [api_tracks.cpp, lap_timer.h, lap_timer_draft_validation.cpp, main.cpp, web_ui_script_core.cpp, web_ui_script_track_creation.cpp]
2026-04-19 fix: address 2026-04-19 codex round-3 review (5 P1 + 2 P2)
    Second follow-up after the validation-session fixes in c41f1b0. Codex
    found that the previous round introduced/left behind seven real holes.
    All seven fixed in one pass.
    P1 — Save path was DELETEing the firmware draft BEFORE POST
    src/wifi/web_ui_script_track_creation.cpp (addTrack)
    addTrack() called stopValidation() right before POST /api/tracks.
    The firmware save gate then saw !active / zero counts and rejected
    every save with 409. I had broken the happy path while trying to
    "clean up" on save. Fix: stop the poll timer only (UI cosmetic),
    keep the firmware line installed; DELETE on success branch; on
    failure, res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
    [lap_timer_draft_validation.cpp, live_map.py, web_ui_script_track_creation.cpp]
2026-04-20 fix: address 2026-04-20 codex round-4 review (4 P2 + stale comment)
    Round-3 follow-up review reported 0 P1, 4 P2. All four addressed
    plus a stale comment codex flagged.
    P2 — addTrack() .catch "ghost success" false negative
    src/wifi/web_ui_script_track_creation.cpp
    If POST /api/tracks landed on the ESP32 but the HTTP response was
    dropped, the old .catch() just showed "Failed to create track." and
    invited the user to retry — potentially creating a duplicate. Now
    the catch path does a readback via GET /api/tracks and checks if
    the attempted name is in the track list. If yes, treat as success:
    DELETE the draft_validation, resetTrackDraft, loadTracks,
    selectTrack with "ver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
    [api_tracks.cpp, lap_timer.h, lap_timer_draft_validation.cpp, live_map.py, main.cpp, web_ui_script_track_creation.cpp]
2026-04-20 fix: ghost-success readback — count-based proof + identity check (codex R5)
    Round-5 codex review found two real P2s in the round-4 ghost-success
    readback (addTrack .catch):
    P2 #1 — exact-name match is not proof of THIS save
    Firmware's track_store allows duplicate names. The for-loop in the
    .catch handler broke on the FIRST name match in insertion order,
    which is the OLDEST same-name track. If the user saved "home_1"
    yesterday, today's dropped POST would auto-select yesterday's
    track and lie "verified via readback" regardless of whether
    today's POST landed or failed.
    Fix: snapshot `sameNameCountBefore` from `_trackList` right before
    POST. In the readback, compute `mat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
    [web_ui_script_track_creation.cpp]
2026-04-20 fix: ghost-success id-set diff + defer submit-pending across readback (R6)
    Codex round-6 found two remaining P2s in the round-5 ghost-success
    readback:
    P2 #1 — count-based proof failed under concurrent deletes.
    If a concurrent client DELETEd a same-name track between the pre-POST
    snapshot and the post-POST readback, the count delta looked like the
    save failed even though it committed. Example: sameNameCountBefore=1,
    concurrent delete → firmware has 0, our POST adds 1 → readback sees 1,
    check `1 === 1 + 1` is false, UI reports retry, user double-saves.
    Fix: switch from count to id-set diff. Snapshot the SET of track
    IDs that had the attempted name before POST. In the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
    [web_ui_script_track_creation.cpp]
2026-04-20 feat: durability (lap sidecar JSONL) + LCD mirror + recording serial/UI
    Three operator-ergonomics additions after the 2026-04-20 walking test
    where a mid-session USB disconnect lost 5 real laps to a half-written
    .vbo.tmp with no [laptiming] section (known trade-off called out in
    storage_session.cpp line 119).
    Item 1 — Per-lap durability sidecar
    src/storage/storage_session.cpp, storage.cpp, storage/storage_internal.h
    New `_recording.lap.jsonl` tmp file opened alongside the VBO .tmp.
    Each completed lap appends ONE JSONL line + fsync so power-loss at
    any point preserves all previously completed laps:
    {"lap":N,"lap_time_ms":T,"status":"TIMED"|"SLOW"|...,
    "finish_ts_us":X,"sec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
2026-04-20 fix: live track geometry update + HDOP from GGA fallback
    Two field-test gaps spotted during the 2026-04-20 walk:
    Q1 — live_map drew the OLD track line after a runtime track change
    src/lap_timer.cpp (lap_timer_set_track)
    Firmware only emitted the [track] START/FINISH summary at boot,
    from the storage-init path in main.cpp. Runtime track changes
    (web /api/tracks POST → lap_timer_set_track, serial `track save`,
    lap_timer auto-detect) bumped s_active_track_version for
    lap_timer_task but never told serial listeners. live_map kept
    rendering P1/P2 from the boot-time track until the firmware was
    rebooted.
    Fix: lap_timer_set_track() now re-emits the same
    [track] START/FIN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
    [gps_fix.cpp, gps_internal.h, gps_parser.cpp, lap_timer.cpp]
2026-04-21 feat: ACK-based command feedback + durable track save + session-stop bool
    Codex-authored pass over the recording / track-save paths — makes both
    firmware and live_map tell the truth about whether a user action
    actually landed on SD.
    - src/session.{h,cpp}: session_stop_recording() now returns bool. true
    only when the final session file was committed to /sessions/.
    Handles the edge where stop is requested with s_phase != RECORDING
    but is_recording == true (resync + warning) instead of silently
    no-op'ing and leaving the tmp file dangling.
    - src/storage.h + src/storage/storage_session.cpp: storage_end_session()
    returns bool (rename success). Adds best-effort ensure_direct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
2026-04-21 feat(live_map): gate Save on draft validation + inline hint
    Layered UX on top of codex's ACK-based /command (28f5b26). The
    previous behavior: Save was enabled as soon as you had both P1 and
    P2, but firmware would silently 409 because track_save requires
    draft-validation accepted >= MIN_ACCEPTED. Operator got no feedback
    why the click "did nothing."
    Changes (tools/live_map.py HTML+JS):
    - Add MIN_ACCEPTED_CROSSINGS=1 JS const, documented as mirror of
    firmware lap_timer_draft_validation_min_accepted() for walking-test
    env. Comment explains production is 2 so anyone forking the tool
    knows to bump it.
    - Add #draft-validate-hint inline status row beneath Save buttons,
    styled with .read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
2026-04-21 feat(gps): compact [gps-live] stream + live_map 10 Hz updates
    Adds a USB-serial side channel that emits a single-line [gps-live]
    record at a configurable 1-25 Hz for laptop-side tools, without
    touching the existing 1 Hz [gps] diagnostic summary the firmware
    already prints to the console.
    Motivation: live_map.py was polling at 1 Hz off the [gps] line, which
    made the trail look laggy while walking and made crossing candidates
    look like teleports. The [gps-live] stream gives smooth motion
    without bloating logs when no tool is subscribed.
    Firmware (src/gps/*, src/main.cpp, src/serial_console.*):
    - gps_set_live_stream_rate(hz) / gps_get_live_stream_rate(): set/get
    live-stream cadence; 0 disa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
2026-04-21 feat(gps): Automotive dynamic model + SBAS + multi-GNSS + HDOP gate
    Race-track accuracy pass. Three u-blox config writes + a crossing
    gate, targeted at the drift the operator was seeing in live_map
    during walking tests.
    Rationale (see comments in src/ubx_builder.h for wire-level detail):
    1. CFG-NAV5 dynModel=4 (Automotive). Factory default is Portable,
    which assumes pedestrian velocity/acceleration bounds. Under a
    kart/car trajectory that model over-smooths during heavy
    brake/throttle transitions, delaying the true crossing by tens
    of ms and under-rejecting multipath because the bounded-road
    assumption is unused. Automotive tells the receiver the
    platform does <=100 m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
    [gps_ubx.cpp, lap_timer_crossing.cpp, lap_timer_draft_validation.cpp, lap_timer_internal.h, test_ubx_builder.cpp, ubx_builder.cpp, ubx_builder.h]
2026-04-21 fix(gps): CFG-GNSS QZSS flags silently NAKing entire config
    Root cause for the "sats/HDOP didn't improve after racing-accuracy
    pass" report from 2026-04-21 walking test.
    The QZSS block in ubx_builder.cpp's CFG-GNSS payload was setting
    flags=0x00010005, which decodes as:
    - bit 0 = 1 (enable) ← intended
    - bit 2 = 1 (undefined!) ← accidental
    - bits 16-23 = 0x01 (L1C/A only — L1S not actually enabled)
    The comment said "L1C/A + L1S" but the intended encoding was
    (0x05 << 16) | 0x01 = 0x00050001, not 0x00010005. u-blox M9N
    strictly validates CFG-GNSS and NAKs the ENTIRE message when any
    block's flags contain undefined bits, silently reverting all six
    constellations back to fac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
    [test_ubx_builder.cpp, ubx_builder.cpp]
2026-04-21 feat(live_map): reboot auto-bootstrap + stop-error surfacing + disconnect banner
    Three walking-test UX issues reported on 2026-04-21, fixable without
    the board plugged in.
    1. Reboot auto-bootstrap
    Firmware's live-stream rate (s_live_stream_rate_hz) resets to 0
    on every ESP32 reset, so after a board reboot live_map silently
    fell back from the 10 Hz [gps-live] feed to the 1 Hz [gps]
    diagnostic line — operator sees choppy trails and doesn't know
    why. parse_line() now watches for the "[BOOT-EARLY] SETUP_ENTRY"
    banner and kicks a background thread that re-sends
    "gps stream 10" and "ls tracks" after a 2 s settle. Debounced
    to 3 s so multiple boot-log lines can't spam t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
    [live_map.py, test_live_map_parse.py]
2026-04-21 feat(gps): UBX ACK/NAK monitor + GSV const counts + CFG-GNSS readback
    Boil-the-lake diagnostics pack so a single walking test can surface
    every class of GPS-config failure instead of looping "fly out to
    open sky, observe, fly back, debug" for days. Prompted by the
    2026-04-21 report: UBX configs silently NAK'd, sats/HDOP didn't
    improve, and the boot log looked identical between a working and
    broken receiver.
    Three monitoring layers, each with structured log lines that
    live_map parses into a new "GPS Receiver Diagnostics" panel:
    1. [gps-ubx] ACK|NAK <name> (cls=0x.. id=0x..)
    Every CFG write in gps_uart_init() is now followed by
    gps_ubx_monitor_drain_for_ack(cls, id, timeout_ms) that w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
    [gps_constellation.cpp, gps_constellation.h, gps_fix.cpp, gps_parser.cpp, gps_ubx.cpp, gps_ubx_monitor.cpp, gps_ubx_monitor.h, live_map.py]
2026-04-22 fix: codex-review HIGH findings before walking test
    Four HIGH-severity issues from codex review of 4cf60cf..9ee4107.
    All would have burned the next walking test.
    1. live_map track_query_bootstrap() NameError crash
    Refactor in 5fe1316 extracted the `send()` helper into
    _send_runtime_bootstrap_commands() but left a call site behind
    at line 1009. Codex reproduced `NameError: name 'send' is not
    defined` — guaranteed crash the first time ls reply arrives
    after live_map starts post-boot. Fix: lift send into a module-
    level _bootstrap_send() helper both call sites use; also make
    _send_runtime_bootstrap_commands() re-request the track JSON
    when first_track is already kno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
    [gps_ubx.cpp, live_map.py, test_live_map_parse.py]
2026-04-22 fix: codex follow-up review findings (5 Medium bugs)
    Second-pass codex review of 1d72d0e found 2 new Mediums in the fix
    commit itself plus 3 still-open Mediums from the first review.
    All five tightened before the next walking test so a single trip
    covers more edge cases.
    1. tools/live_map.py — unlocked _reboot_watch write slipped through
    the lock sweep in track_query_bootstrap() (line 1124). Every
    other access held _reboot_watch_lock; this one didn't. Held now.
    2. src/gps/gps_ubx.cpp — CFG-GNSS poll-response parser blindly burned
    (declared_len + 2) bytes for any non-target frame, up to the
    65535-byte UBX limit. A single false sync on bogus bytes could
    eat the entire 1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
    [gps_ubx.cpp, live_map.py, test_live_map_parse.py, test_ubx_builder.cpp, ubx_builder.h]
2026-04-22 feat(session): [stop-trace] milestones + 15s save timeout
    2026-04-22 walking test reproduced a 10-minute-session Save Recording
    hang: LCD kept showing rec=1, live_map timed out at 5 s, firmware
    emitted zero serial output from the stop path. Short sessions save
    cleanly. Without per-step diagnostics there's no way to know
    whether it's a true deadlock, a slow SD flush, a stuck queue drain,
    or a blocked mutex — all fail identically from the outside.
    Instrumentation:
    - src/session.cpp — session_stop_recording() now emits [stop-trace]
    lines at every milestone: entry, mutex1_ok, is_recording_cleared,
    calling_end_session, end_session_returned. Each carries the
    current millis() uptime s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
    [live_map.py, session.cpp, storage_session.cpp]
2026-04-22 fix: codex 2026-04-22 review — [stop-trace] visibility + blind spots
    Codex second-opinion on 278ee66 caught 1 High + 2 Medium + 1 Low
    in the stop-trace diagnostic patch itself. All fixed.
    1. High: [stop-trace] lines were parsed but dropped by live_map's
    event filter, so the diagnostic markers never surfaced in the
    tool the operator was actually using during the walking test.
    Added [stop-trace] to the prefix allowlist in parse_line so
    markers now appear in the events feed and the browser UI.
    Host test pins the filter hit so a future refactor doesn't
    quietly remove it.
    2. Medium: blind spot before `drain_done`. If a hang occurs during
    vTaskDelay(50), the first drain-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
    [live_map.py, storage_session.cpp, test_live_map_parse.py]
2026-04-22 feat(live_map): track picker + auto-detect button
    Operator can now switch the active track from the laptop without
    dropping to the phone's WiFi UI. Three new serial commands + a
    dropdown in the live_map right column.
    Firmware (src/serial_console.*, src/main.cpp):
    - SerialConsoleCommandType::TrackSelect ("track select track_NNN")
    - SerialConsoleCommandType::TrackAutodetect ("track autodetect")
    - SerialConsoleCommandType::TracksList ("tracks list")
    - is_track_id_valid(): tight regex on `track_\d{1,3}` so a malformed
    id can't reach track_get_by_id or trigger SD reads.
    - Handlers mirror the /api/tracks/select HTTP path:
    * block if recording (protects [laptiming] integrity)
    *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
    [live_map.py, main.cpp, serial_console.cpp, serial_console.h, test_live_map_parse.py, test_serial_console.cpp]
2026-04-22 fix: codex 2026-04-22 track-picker review (2 HIGH + 5 MED + 2 LOW)
    Codex adversarial review on b68cd67 caught 9 issues. All fixed.
    HIGH#1 — fail-open recording guard + non-atomic check. The old
    serial `track select` / `track autodetect` took session_mutex with
    pdMS_TO_TICKS(50) and defaulted `recording=false` on contention;
    if the mutex was held longer than 50 ms, the guard let a track
    switch slip through DURING an active recording. Plus check and
    switch were three separate critical sections, leaving a window for
    concurrent recording_start to snapshot the old track_name while
    lap_timer was about to take the new geometry. New
    serial_console_try_claim_track_switch() holds session_mutex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
    [lap_timer_task.cpp, live_map.py, main.cpp, test_live_map_parse.py]
2026-04-22 fix: codex handoff doc findings 2 + 3 on track picker
    Handoff (docs/CODEX_REVIEW_2026-04-22_main_track_picker_handoff.md)
    flagged 4 issues on commit b68cd67. Findings 1 and 4 were already
    resolved by 99f2cbc (fail-closed mutex; disabled-placeholder option).
    This commit closes the remaining two.
    Finding 2 — draft save leaves newly-active track out of the picker.
    After firmware emits `[draft] saved: track_NNN (Name) ...`, the new
    track is active server-side but live_map's parser only refreshed
    the geometry overlay via `cat tracks/<id>.json`. Catalog stayed
    stale and active_track_id pointed at the previous track until next
    reboot. The _DRAFT_SAVED_RE branch now:
    - upserts {id, name} int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
    [live_map.py, test_live_map_parse.py]
2026-04-22 fix: codex review fdf1c54 — parens-in-name regex + tighter filter test
    Two findings on the previous commit:
    MEDIUM — _DRAFT_SAVED_RE couldn't parse names containing ) chars.
    Firmware's is_track_name_valid only rejects control chars and a
    specific shell-unsafe set; parentheses are allowed, so a valid name
    like `Home (North)` produces:
    `[draft] saved: track_013 (Home (North)) length=8.33m heading=90.0`
    The old `([^)]+)` capture stopped at the first `)`, silently
    breaking the regex match. Side effect: catalog/active update from
    the previous commit never ran for such names, and
    `_match_command_ack("track save", ...)` would time out. Non-greedy
    `(.+?)` anchored on the literal `) length=`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
    [live_map.py, test_live_map_parse.py]
2026-04-22 fix: codex third-round review — parser robustness + dual-upsert
    Codex ran an adversarial sweep on 45a66ad and found 2 MEDIUM + 3
    LOW issues. All fixed.
    MEDIUM — _TRACK_SELECTED_RE had the same parens bug I just fixed
    in _DRAFT_SAVED_RE. Valid name `Home (North)` in
    `[track] selected: track_013 (Home (North))` parsed as just
    `Home (North`. Anchored greedy pattern + track_\d{1,3} id
    constraint.
    MEDIUM — _DRAFT_SAVED_RE was still delimiter-injection fragile.
    is_track_name_valid accepts `)`, spaces, `=`, digits, `.`, `m`,
    letters — so a name `Foo) length=1.0m heading=2.0` produces
    `[draft] saved: track_015 (Foo) length=1.0m heading=2.0) length=8.33m heading=90.0`
    and the old non-gre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
    [live_map.py, test_live_map_parse.py]
2026-04-22 fix: close deferred HIGHs — track_store mutex + HTTP select fail-closed
    Two long-acknowledged HIGH findings from prior codex reviews were
    tracked as deferred because they required a shared design across
    serial + HTTP. Both fixed in one pass.
    HIGH — s_tracks[] had no mutex. track_delete() shifted the array
    and track_save_detailed() appended, both on the WiFi task, while
    readers returned raw pointers through track_get_by_id/track_get/
    track_auto_detect on the main loop and lap_timer tasks. Concurrent
    reads could see shifted-out-from-under entries, produce stale
    pointers, or iterate past a shrinking array.
    - New track_store_mutex, created in setup() before track_init().
    Boot-time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
    [api_tracks.cpp, lap_timer_task.cpp, main.cpp, session.cpp, session.h, track.h, track_detect.cpp, track_internal.h]
2026-04-22 fix: codex round-4 review — save ID race + tri-state copy-out + legacy readers
    Codex fourth adversarial pass on 9a66c1c caught 1 new HIGH (I
    introduced it) + 2 MEDIUM + 1 LOW.
    HIGH — track_save_detailed had an ID-reservation race. The previous
    version took track_store_mutex, computed next_num, RELEASED the mutex
    for the SD write, then re-acquired for the final append. Two
    concurrent saves could compute the same track_NNN, target the same
    file path, and append duplicate in-memory entries. Fix: hold the
    mutex across the ENTIRE save. Writes are rare (operator creates
    tracks occasionally) and the alternative append-then-rollback
    approach is more code for a narrow UX win. The mutex is h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
    [api_status.cpp, api_tracks.cpp, lap_timer_task.cpp, main.cpp, session.cpp, track.h, track_detect.cpp, track_store.cpp]
2026-04-22 fix: codex round-5 review — atomic track_delete + STORE_BUSY + accurate err
    Codex fifth pass caught 1 HIGH + 1 MEDIUM + 1 LOW introduced by
    the previous round's save-mutex hold.
    HIGH — track_delete was still two-phase. Round 4 tightened save
    to hold track_store_mutex across the full I/O, but delete kept
    its old pattern: take mutex, look up idx, release, do SD remove,
    re-take for shift with 2000 ms timeout. With saves now holding
    the mutex for the entire write (100-500 ms), the chance of the
    re-take timing out went up. If that happened, the file was
    already gone from SD but the entry stayed in s_tracks[], leaving
    a disk/memory split until reboot. Fix: hold track_store_mutex
    across th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
    [main.cpp, track_creation_feedback.cpp, track_creation_feedback.h, track_store.cpp]
2026-04-22 fix: codex round-6 — atomic delete-vs-recording + busy propagation
    Codex sixth pass caught 1 HIGH + 2 MEDIUM + 1 LOW all caused by the
    track_store/SD lock hold introduced in rounds 4-5. Every round has
    introduced its own follow-up bugs; this one closes the loop.
    HIGH — handle_api_tracks_delete was not atomic against recording
    start / track select. The old code snapshotted is_recording and
    active_track.id under session_mutex, released, ran track_delete
    (now holds track_store_mutex + spi_mutex for hundreds of ms), then
    used the stale snapshot to decide whether to clear active_track.
    During the delete window:
    - serial `recording start` could start a session on the soon-to-
    be-delet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
    [api_tracks.cpp, live_map.py, main.cpp]
2026-04-22 chore: ignore walking_logs/ field-test data
    The 7-round codex review work on the track picker has shipped (see
    43bd7e0 back to b68cd67). The 4 review handoff docs that accumulated
    during that work are captured in their corresponding commit messages
    verbatim, so the root docs/ copies are now redundant; removed those
    to keep docs/ focused on persistent design material.
    walking_logs/ holds the real field-test captures (VBO + boot logs
    from the 2026-04-20 and 2026-04-21 walking sessions) that are not
    regenerable. Ignoring the directory so git status stays quiet while
    the files themselves stay on disk for offline analysis.
2026-04-23 feat: tighten driver-feedback latency (LCD 20 fps + live_map 25 Hz/30 fps)
    End-to-end latency from GPS measurement to "driver sees the screen
    move" was sitting at 200-350 ms typical / ~400 ms worst case, with
    the LCD path adding 0-100 ms on top of the GPS+parse 50-100 ms.
    At 60 km/h that lag means the on-screen position is ~3.4 m behind
    the cart, which is right where braking decisions get made. Push
    the dial down with three independent rate bumps that don't need
    the PCB rev to land.
    - src/display/display_internal.h: FRAME_INTERVAL_MS 100 → 50.
    20 FPS render cadence, halves LCD's contribution to the lag
    budget. ESP32-S3 CPU goes from ~12% to ~24%, well within
    headroom. T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
    [display.cpp, display_internal.h, live_map.py]
2026-04-23 feat: delta fast path — lap_timer kicks display on every GPS fix
    Complements the 1f922bb LCD 20 FPS bump by removing the remaining
    0-50 ms wait between "lap_timer writes a new delta_ms" and "display
    task reads it on its next heartbeat." Driver now sees the +/-
    delta digit move within ~30 ms of the GPS fix instead of averaging
    25 ms behind.
    Mechanism:
    - display_task captures its own FreeRTOS task handle at entry
    (s_display_task_handle).
    - Public display_kick() entry point in src/display.h does
    xTaskNotifyGive. Safe to call from any task, coalesced at the
    FreeRTOS level so rapid consecutive kicks don't queue.
    - display_task's main loop replaces vTaskDelayUntil with
    ulTaskNotifyTak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
    [display.cpp, display.h, lap_timer_delta.cpp]
2026-04-23 fix: codex round-7 review — rate-limit timing + kick coverage + trail length
    Codex caught 1 MEDIUM + 4 LOW regressions from the latency
    optimization pass (1f922bb + ab2c85f). All fixed.
    MEDIUM — last_render was advanced BEFORE snapshot_session_state()
    and the SPI takes, so a frame that skipped (session_mutex busy,
    button-handler mutex miss) still charged 33 ms against the rate
    limiter. The next GPS-fix kick had to wait ~33 ms before it could
    render — defeating the fast path exactly in the SD/TFT contention
    case it was meant to improve. last_render now only advances
    AFTER a successful render completes.
    LOW — update_session_delta dropped the display_kick() when the
    2 ms session_mu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
    [display.cpp, lap_timer_delta.cpp, live_map.py, main.cpp]
2026-04-23 feat(gps): CFG-NAV5 minElev=10 + staticHoldThresh=5 for drift suppression
    2026-04-23 walking-test report: position drift still visible at
    walking pace (1-2 m/s) even with Automotive dynamic model + SBAS +
    6-constellation tracking. Two additional CFG-NAV5 knobs that
    address the remaining drift without affecting any moving-vehicle
    behaviour:
    A — minElev 5° → 10°. Low-elevation satellites are dominated by
    multipath (reflections off buildings, trees, car bodies) which
    inject lateral noise into the fix. With 30+ visible satellites
    under multi-constellation + SBAS, cutting the bottom tier still
    leaves 15-20 strong signals and typically IMPROVES HDOP instead of
    degrading it.
    B — static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
    [gps_ubx.cpp, test_ubx_builder.cpp, ubx_builder.cpp, ubx_builder.h]
2026-04-23 feat(gps): alpha-beta Kalman smoothing + route filtered fix to live map
    Two linked problems the 2026-04-23 walking test surfaced:
    1. Even with the board sitting on the ground, live_map.py kept
    showing the green dot wobbling by several metres. The LCD used
    the EMA-filtered display_fix, but [gps-live] in gps/gps_fix.cpp
    emitted the raw assembled GGA/RMC — so the browser was looking
    at unfiltered receiver output the entire time. EMA tuning on
    the display side was invisible to the user's live_map view.
    2. The EMA itself was still too leaky at rest. At alpha=0.24 (the
    walking-pace tier) a single ±3 m noise sample nudges the filter
    by ~72 cm, which at 25 Hz fix rate is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
    [gps_filter.cpp, gps_fix.cpp, gps_kalman.cpp, gps_kalman.h, test_gps_kalman.cpp]
2026-04-23 fix(gps): codex 2026-04-23 review — reset bug + filtered API + raw sampler
    Addresses findings 1 and 2 from docs/CODEX_REVIEW_2026-04-23_gps-
    precision-followup.md. Finding 3 (delta through match_fix) is
    evaluated and deferred; see below.
    Finding 1 (HIGH): escape hatch leaked stale Kalman + median history
    -----------------------------------------------------------------
    Before this commit the consecutive-reject escape hatch in
    gps_filter_process only cleared display_valid / match_valid. That
    was sufficient when the display path was EMA-only (state was a
    single blended position). After the 2026-04-23 Kalman swap the
    display path holds its own position + velocity state, and the
    low-speed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
    [gps_filter.cpp, lap_timer_delta.cpp, main.cpp, test_gps_filter.cpp, types.h]
2026-04-23 fix(tests): codex follow-up — fail (not skip) on missing .deps file
    Codex's 2026-04-23 follow-up review caught one new LOW finding: the
    .deps sidecar mechanism added in 598e9fb / refined in 088e71c was
    treating a missing dependency file as SKIP, letting the runner exit 0
    with the test silently dropped from coverage — the exact failure mode
    the sidecar was supposed to prevent.
    Switched the missing-dep branch from "echo SKIP + continue" to a hard
    FAIL: increment fail counter, push to failed_tests, then continue to
    the next test. Mutation-verified by appending a bogus path to
    tests_host/test_gps_filter.deps; runner exit was 1 with the bad dep
    and 0 once restored.
    No source changes; runne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
2026-04-23 docs(todos): capture GPS-precision validation + deferred follow-ups + PCB migration
    Three groups added to TODOS.md so the work surfaced over the last few
    days isn't sitting only in commit messages and codex review files:
    1. Before v1.0 — GPS Precision Validation: walk test + kart-track test
    for the 598e9fb / 088e71c / 9d25328 commits (Kalman + filtered API
    + test runner hardening), plus the GSA enablement decision from
    Open Gap finding 4.
    2. Deferred to v1.1 — bundle GPS queue payload to route delta through
    match_fix (Codex review finding 3, deliberately deferred with
    rationale captured in 088e71c message; restated here so the next
    reader doesn't have to git-archaeolo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
2026-04-23 docs(todos): add Plan B contingency — split SD off shared SPI bus
    Perfboard build, so cost of rewiring later is ~30 min of flying wires,
    not a PCB respin. That changes the decision from "pre-wire now for
    insurance" to "start shared, split only if measurable stall proves
    software mitigation insufficient."
    Documents in TODOS.md Hardware Migration section:
    - When to trigger (Stage A complete + visible flush stalls).
    - Software mitigations to exhaust first (profile, batch, yield, task
    core affinity).
    - Exact pin migration (SD MOSI 11 -> 38, SCLK 12 -> 39; MISO 13 and
    CS 42 unchanged) with rationale for the pin picks (strap/USB/JTAG
    and current-usage exclusions spelled out).
    - Code-chan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
2026-04-28 docs(todos): refresh PCB migration steps for env-split walking-test build
    Stage A now also covers the TFT SPI BREADBOARD_OVERRIDE pair
    (SPI_FREQUENCY 4M->27M, SPI_READ_FREQUENCY 6M->20M). Stage B is no
    longer 'comment out -DWALKING_TEST_MODE=1' since faf2963 isolated
    walking-test into its own opt-in env; production is now the default
    'pio run' target with no edits needed.
2026-04-28 Improve mobile track setup Web UI
2026-05-05 chore(hw): Stage A.1 — restore CPU 240 MHz + SD 25 MHz post-soldering
    Verified on USB-only flash 2026-04-29: boot log confirms CPU runs at
    240 MHz and TFT splash draws cleanly. SD card and GPS module were not
    powered (both on battery rail), so SD 25 MHz path is unverified — to be
    checked next battery boot.
    TFT bump (SPI_FREQUENCY 4M->27M, SPI_READ_FREQUENCY 6M->20M) deferred:
    27 MHz produced a white screen on the hand-soldered PCB. TFT held at
    the conservative 4M/6M pair until a separate clock-sweep pass finds the
    real ceiling (Stage A.3 in TODOS.md).
2026-05-05 chore(hw): mark Stage A.2 verified — SD 25 MHz confirmed on battery boot
    Two clean boots captured from battery via boot_log.txt:
    [STORAGE][ok] sd mounted, defaults in use (~5060 ms)
    [STORAGE][ok] track loaded: 2
    [READY][ok] entering runtime
    no BROWNOUT, no Guru/PANIC/watchdog, no SDFat errors
    GPS timeout was expected (indoor boot, no sky view) — added Stage A.2b
    to capture that as a separate open-sky check.
2026-05-06 feat(live-map): add WiFi UDP transport + offline canvas renderer
    Lets the laptop run tools/live_map.py against a battery-powered board
    without USB. Firmware now mirrors every [gps-live] line into a UDP
    broadcast on the KartGPS AP (port 5555), and the tool grows a UDP
    reader plus a canvas-only map view that doesn't depend on Leaflet,
    unpkg.com, or any tile provider — none of which load once the laptop
    has joined the AP and lost its internet path.
    Firmware changes
    - src/wifi_server.h: declare gps_live_udp_broadcast() helper.
    - src/wifi/wifi_server.cpp: file-static WiFiUDP instance brought up
    alongside the HTTP server; broadcast helper is best-effort and
    silently no-ops until the AP is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
    [gps_fix.cpp, live_map.py, test_live_map_parse.py, test_live_map_udp.py, wifi_server.cpp, wifi_server.h]
2026-05-07 perf(boot): cut boot-to-splash time from 4856 ms to 1544 ms (-3.3 s)
    Visible boot now: brief white flash (~466 ms ROM time, no software fix)
    -> dark (~1078 ms TFT init + clean splash draw at the new SPI clock)
    -> splash appears in one frame. No more two-flash artifact, no more
    "is the screen dead?" gap, no more visible top-to-bottom logo wipe.
    Component breakdown of the savings:
    * src/main.cpp: drive PIN_TFT_BL LOW as the very first action of
    setup() (was line ~1085, after Serial.begin + delay 200 + boot
    status setup). Removes ~500 ms of "backlight floats high while
    setup runs" white phase. Also drops the breadboard-era
    prime_tft_cold_boot_power_path() helper that str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
    [boot_sequence.cpp, display.cpp, display_boot.cpp, display_internal.h, main.cpp]
2026-05-07 docs(wiring): add hot-glue strain-relief section for kart vibration
    Captures where to apply / not apply hot melt glue on the hand-soldered
    PCB before it goes on a kart at 30-80 km/h. Covers GPS connector,
    SD socket, TFT FPC / ribbon, USB-C mechanical pins, battery rail
    flying wires, and the 20 MHz TFT SPI lines that benefit from being
    held flat against the board for signal integrity.
    Also lists the 'do not glue' set: hot ICs (ESP32-S3, regulators,
    TFT controller), the GPS ceramic patch antenna and ~5 mm around it,
    debug headers / test points / BOOT+RST buttons, and the GPIO16
    (PIN_GPS_PPS) pad reserved for the future PPS retrofit.
2026-05-09 feat(hardware): add OpenSCAD enclosure skeleton + workflow doc
    hardware/case/case.scad starts the parametric enclosure model. All
    critical dimensions (TFT outline + visible area, perfboard, USB-C
    positions, BOOT/RST positions, 18650 pack, BK-880 GPS module, M12
    panel buttons) are declared as named constants at the top of the
    file with sensible placeholder values matching the spec sheet, so
    the model renders something usable from the first F5 even before
    the user fills in measured numbers.
    Module structure follows the design intent in PRD.md (GPS antenna
    face up, TFT face toward driver, battery low for low CG) and the
    hot-glue strain-relief notes in WIRING.md. Bottom case + top lid
    split w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
    [case.scad]
2026-05-09 docs(case): switch primary CAD from OpenSCAD to Fusion 360
    macOS Sequoia Gatekeeper blocks the 2021.01 OpenSCAD build (Homebrew
    Cask) — signature/notarization expired and there is no current
    official OpenSCAD macOS package. Fusion 360 is the user's installed
    toolchain and a better fit for hobby-grade enclosure work anyway.
    Conversion strategy: case.scad becomes a reference document, and
    the Fusion 360 path gets a parallel pair of parameter sources that
    mirror the same numbers in two formats.
    New files:
    hardware/case/parameters.csv — Fusion 360 User Parameters import
    (Modify → Change Parameters → folder icon → Import). 32
    measured-dimension entries plus 8 design parame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
    [case.scad, parameters.csv]
2026-05-10 fix(field): boot autodetect override + diagnostic pass for PANIC chain
    Field test 2026-05-09 produced 8 consecutive PANICs in a tight reboot
    loop, all marked crash_bc_core1=61 (display.cpp:532 'about to render').
    This commit lands one root-cause fix and four targeted diagnostics so
    the next field test can either (a) confirm the fix, (b) localize the
    remaining PANIC, or (c) rule out the suspected cause.
    Bug #1 — boot autodetect overrides catalog track (FIX)
    src/main.cpp boot path was unconditionally calling track_auto_detect()
    on the first GPS fix and overwriting whatever active_track was loaded
    by track_load_first(). Field-test boot log shows the device flipping
    between several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
    [display.cpp, gps_fix.cpp, main.cpp, test_boot_sequence.cpp]
2026-05-11 fix(web-ui): prevent iOS Safari auto-zoom on input focus
    Set input/select/textarea font-size to 16px so mobile Safari no longer
    triggers its "input is too small" auto-zoom when the on-screen keyboard
    opens — kept user pinch-zoom intact (no maximum-scale lockdown).
    [web_ui_markup.cpp]
2026-05-11 fix(session): REC button preserves selected track; +finer crash markers
    Bug #3 — REC button clobbers active track name
    =================================================
    session.cpp handle_button_press() was calling
    session_start_recording("Unknown Track")
    unconditionally on the physical REC short-press, regardless of which
    track was actually loaded. session_start_recording then strncpy's the
    literal into session_state.track_name (session.cpp:113), so the
    display flipped from the loaded track (track_load_first picked
    'test0422' at boot) to 'Unknown Track' the moment the user pressed
    REC — and stayed there after stop because there is no code path that
    restores session_state.track_name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
    [display_driving.cpp, session.cpp]
